zayinconde/Expert_In_Teams/Report/Images/olfactoryBreadboard.JPEG

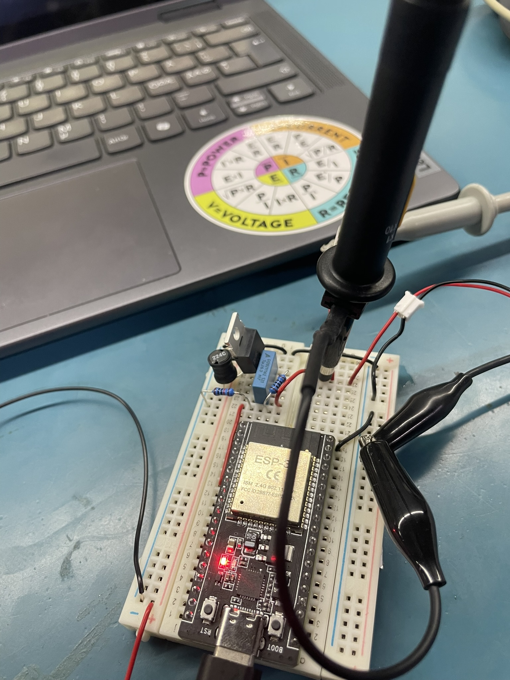
Report/Images/olfactoryBreadboard.JPEG
