zayinconde/Expert_In_Teams/Report/Images/IMG_4819.JPEG

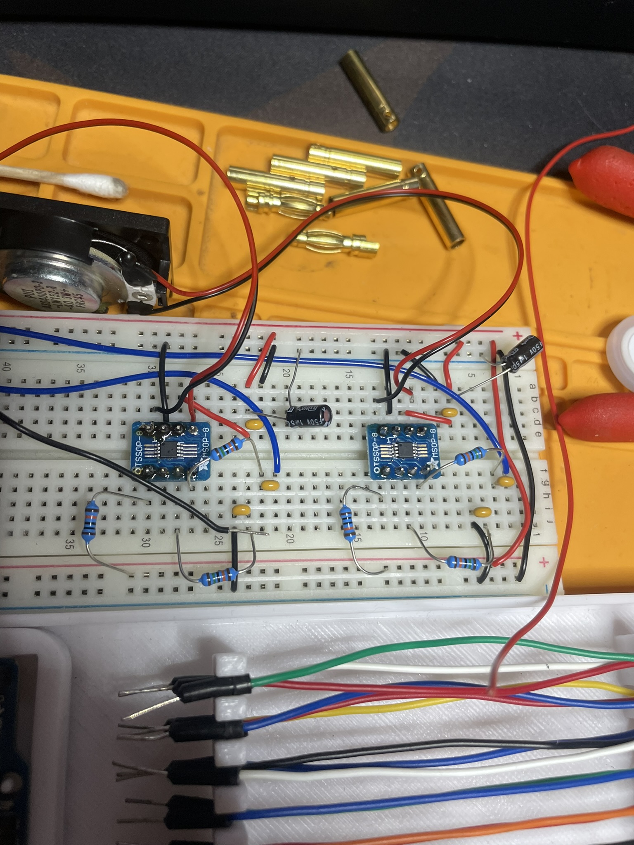
Report/Images/IMG_4819.JPEG
