zayinconde/Expert_In_Teams/README.md

This is my expert and teams electronics repository. The project is a multi-dsiciplinary project. This repository contains all the files related to the electronics part by me (Zayin Conde). 

The embedded software is developed in VS code using platformio cross platform developemnt tool. 

The repository also contains the KICAD files for circuit schematics and PCB designs. 

Additionally, a project B.O.M list is linked along with a brainstorming document (note: language can be informal, used for personal brainstorming and decision making) (View only with SDU Mail)

[📄 View the live Brainstorming Document (Word)](https://syddanskuni.sharepoint.com/:w:/s/AIDeputyExpertinTeams/ETyJX5G7IEFBnaOn01ZgCaMBbD81jJfqN7rkElq9ijI7jw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)
[📊 View the live B.O.M list (Excel)](https://syddanskuni.sharepoint.com/:x:/s/AIDeputyExpertinTeams/EaCTvVSukcdOoP5wCQjI0uoB_z5LuD4u5wMGKWqrb4GMKw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)
