zayinconde/Expert_In_Teams/Report/olfactory_presentation.pdf

## Active Mesh Nebulizer

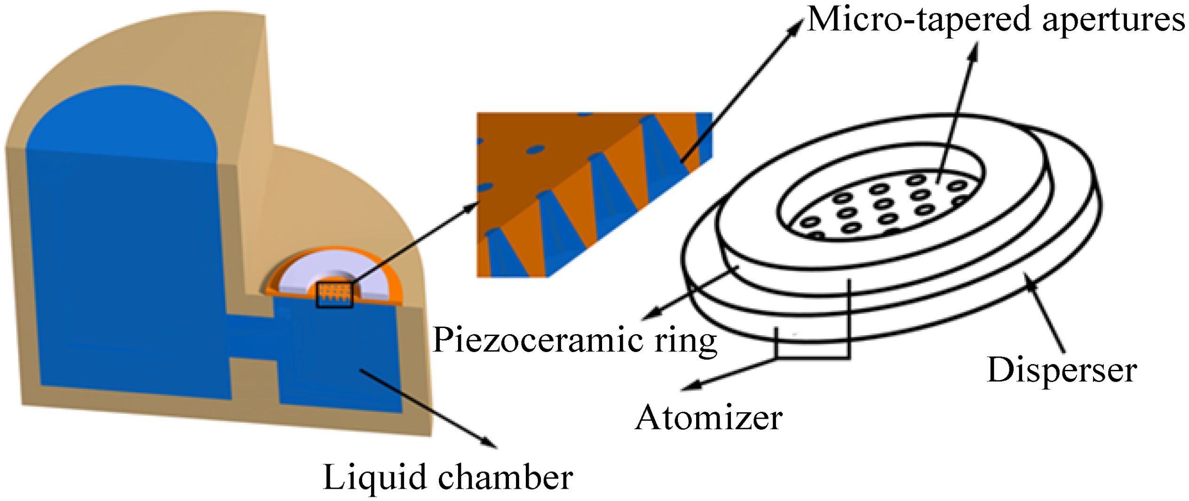
[picture p17: figure]

## Driving Circuit

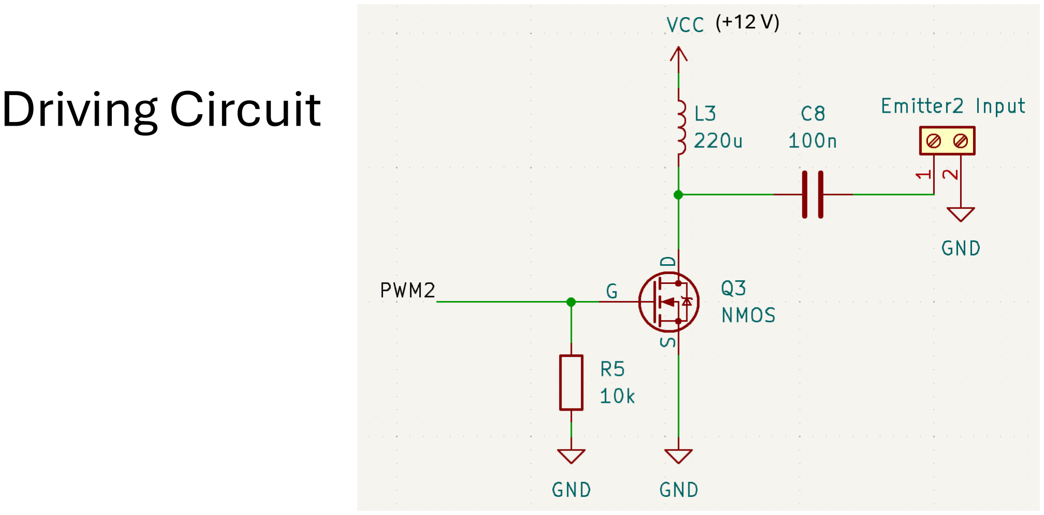
[picture p18: page 2]

(+12 V)

## Things to Consider

- 1. Low rate of atomization (up to 0.025 ml/s or 25 ul/s) for water.
- 2. Higher voltages may help achieve better atomization rates but risk damaging the transducer.
- 3. If the pressure of your liquid reservoir is too high, the liquid may leak through the mesh on its own.
- 4. Performance drops with more viscous liquids.
- 5. Liquids that crystalize on drying can clog the mesh. (e.g. tap water)
