zayinconde/Expert_In_Teams/DC-DC Converter Design/Scope ScreenShots/scopeDCDC.PNG

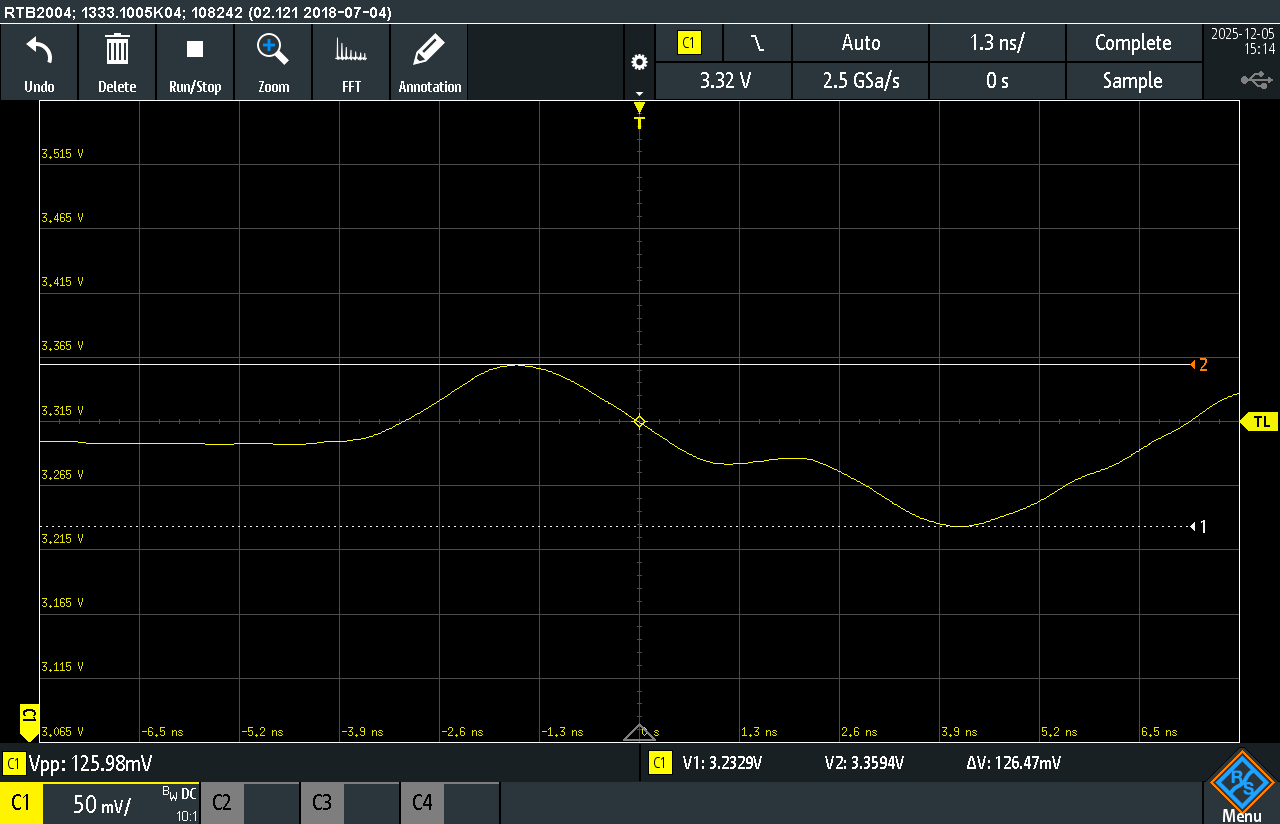
DC-DC Converter Design/Scope ScreenShots/scopeDCDC.PNG
