zayinconde/Expert_In_Teams/DC-DC Converter Design/Scope ScreenShots/SCR05.PNG

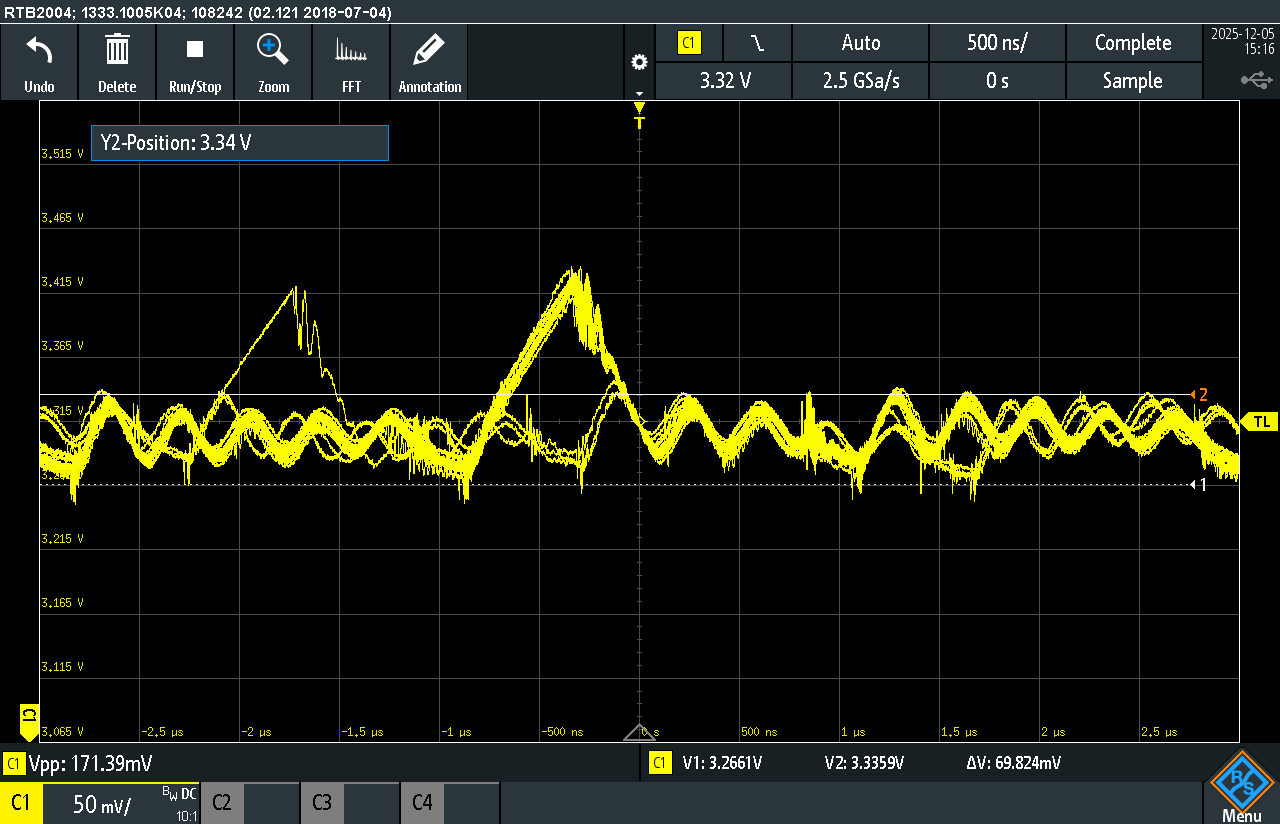
DC-DC Converter Design/Scope ScreenShots/SCR05.PNG
