zayinconde/Expert_In_Teams/DC-DC Converter Design/Scope ScreenShots/SCR07.PNG

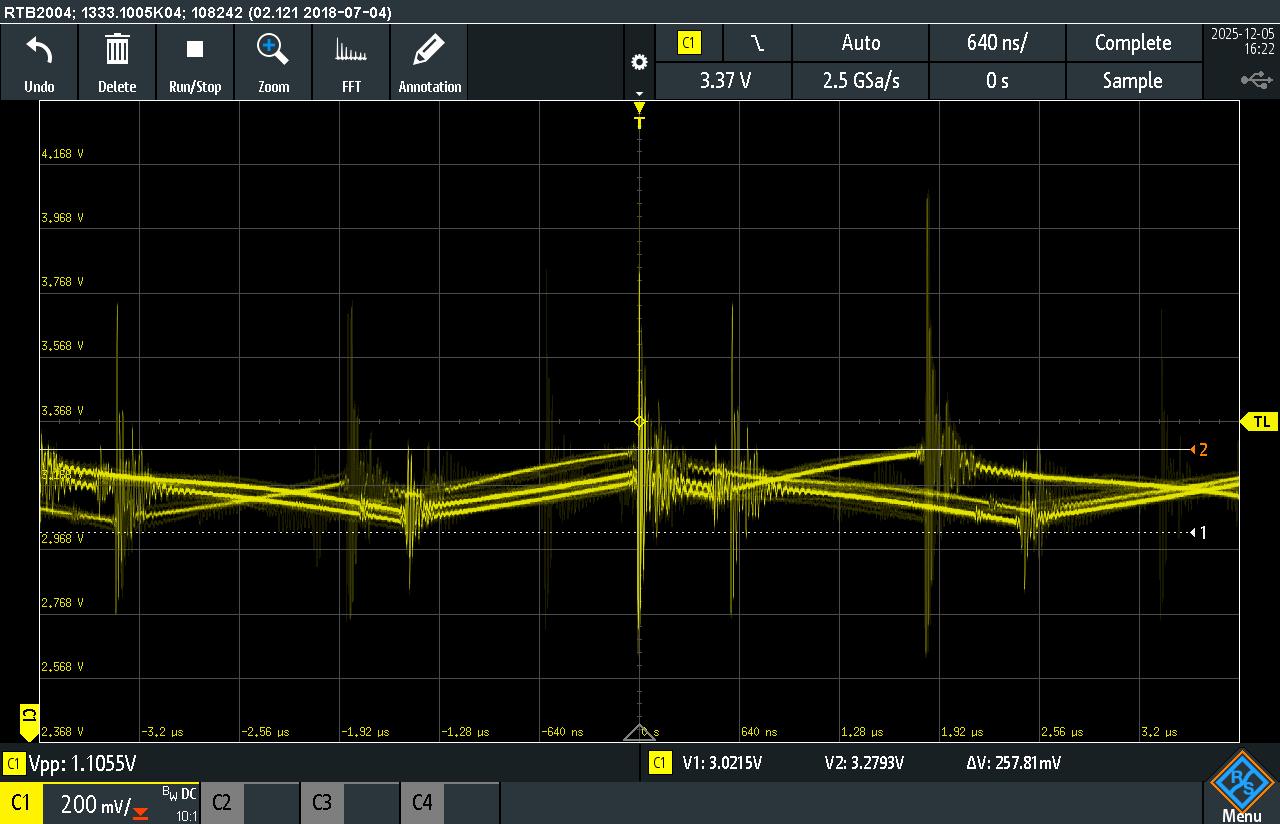
DC-DC Converter Design/Scope ScreenShots/SCR07.PNG
