zayinconde/Expert_In_Teams/Report/github.png

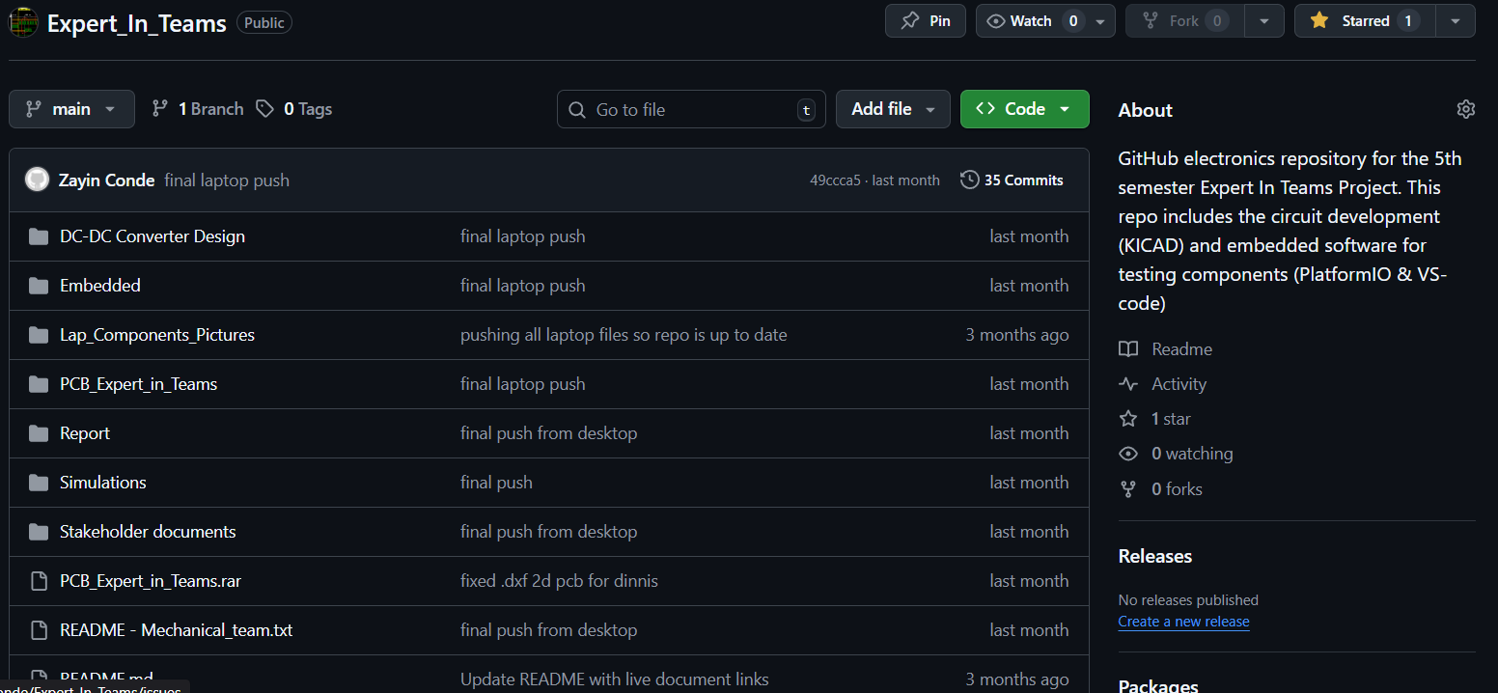
Report/github.png
