zayinconde/Expert_In_Teams/Report/Images/3dRenderPCB.png

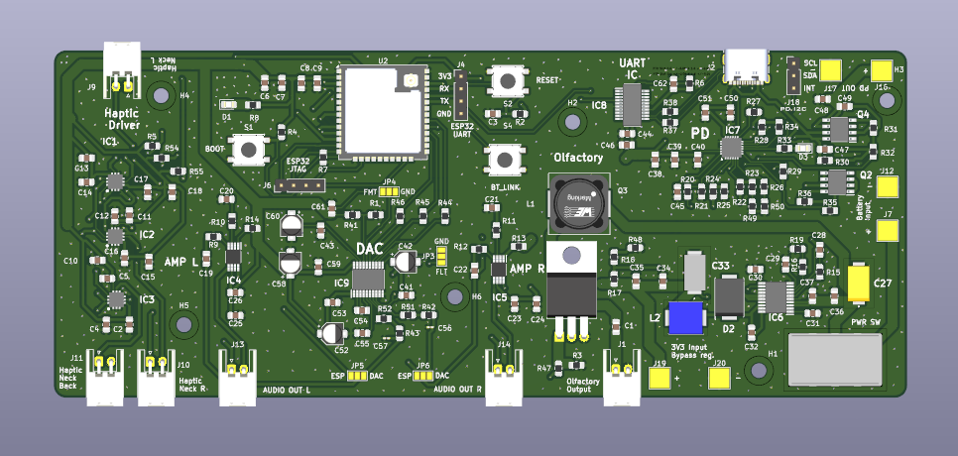
Report/Images/3dRenderPCB.png
