zayinconde/Expert_In_Teams/Report/Images/3dRenderPCBoutline.PNG

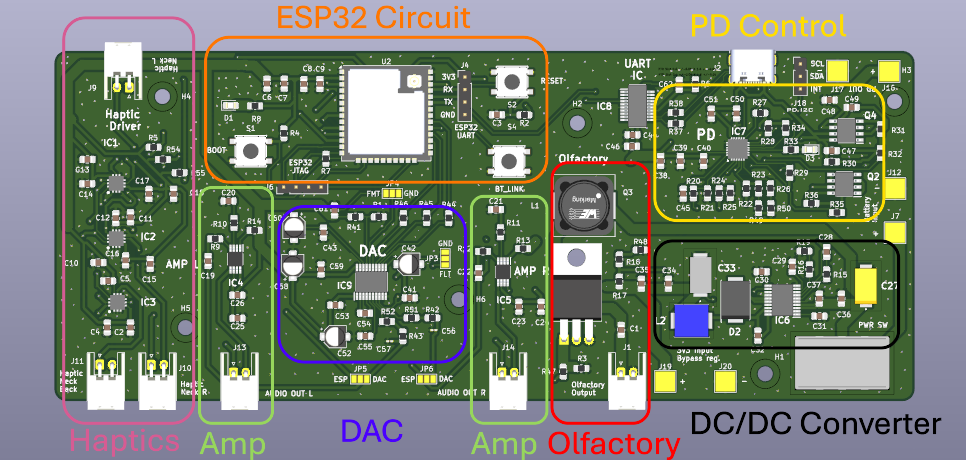
Report/Images/3dRenderPCBoutline.PNG
