zayinconde/Expert_In_Teams/Report/Images/AI-Deputy-Electronics-System-Diagram.drawio.png

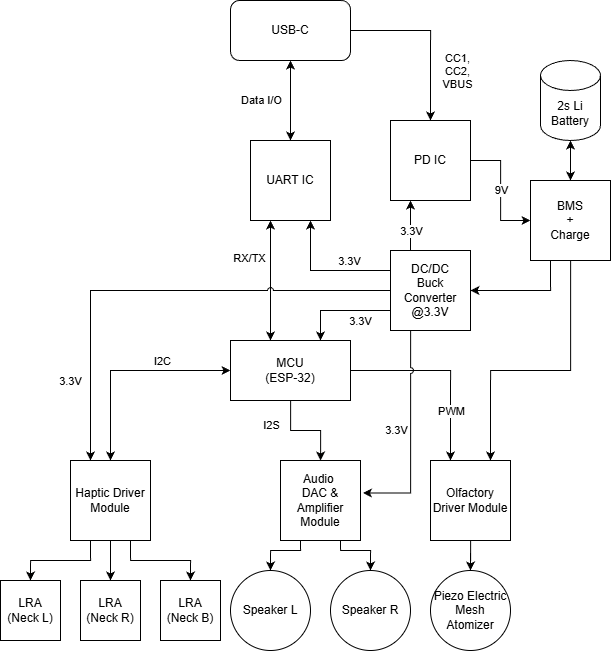
Report/Images/AI-Deputy-Electronics-System-Diagram.drawio.png
