zayinconde/Expert_In_Teams/Report/Images/audiodiagram.drawio.png

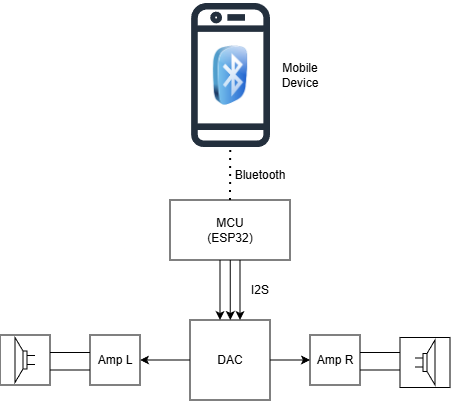
Report/Images/audiodiagram.drawio.png
