zayinconde/Expert_In_Teams/Report/Images/audiotestnodac..JPG

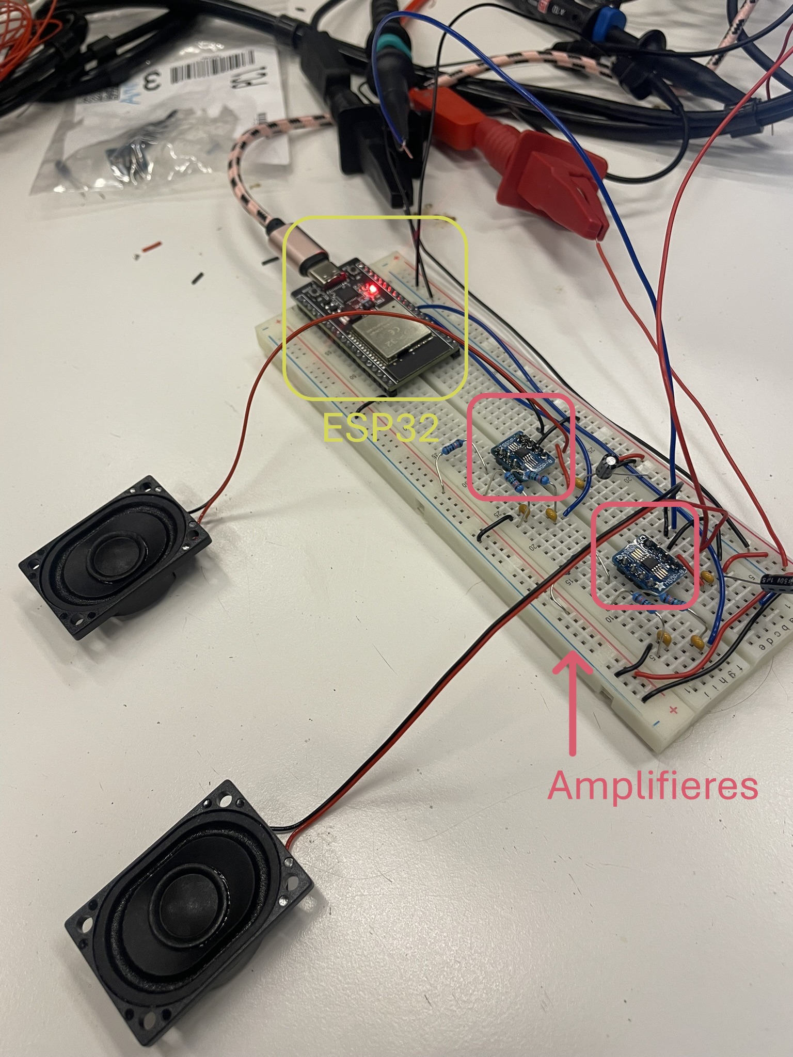
Report/Images/audiotestnodac..JPG
