zayinconde/Expert_In_Teams/Report/Images/buck_converter.JPEG

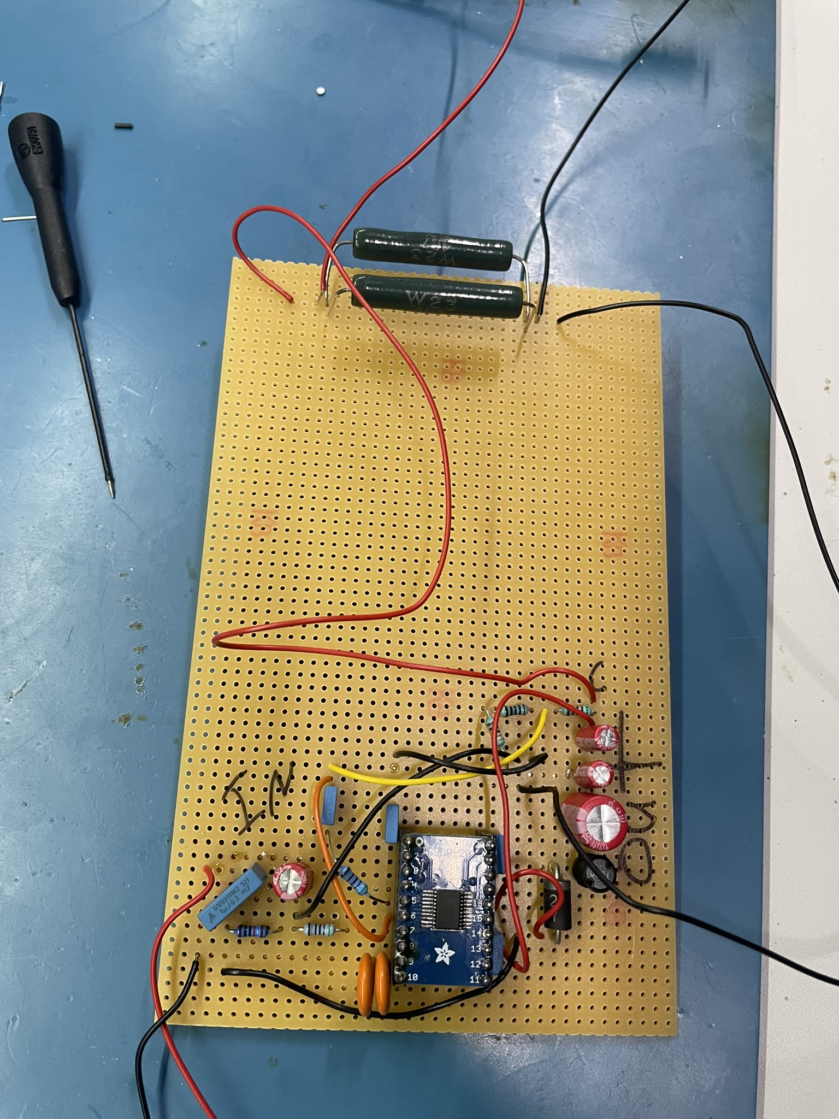
Report/Images/buck_converter.JPEG
