zayinconde/Expert_In_Teams/Report/Images/buck_converter_breadboard.JPEG

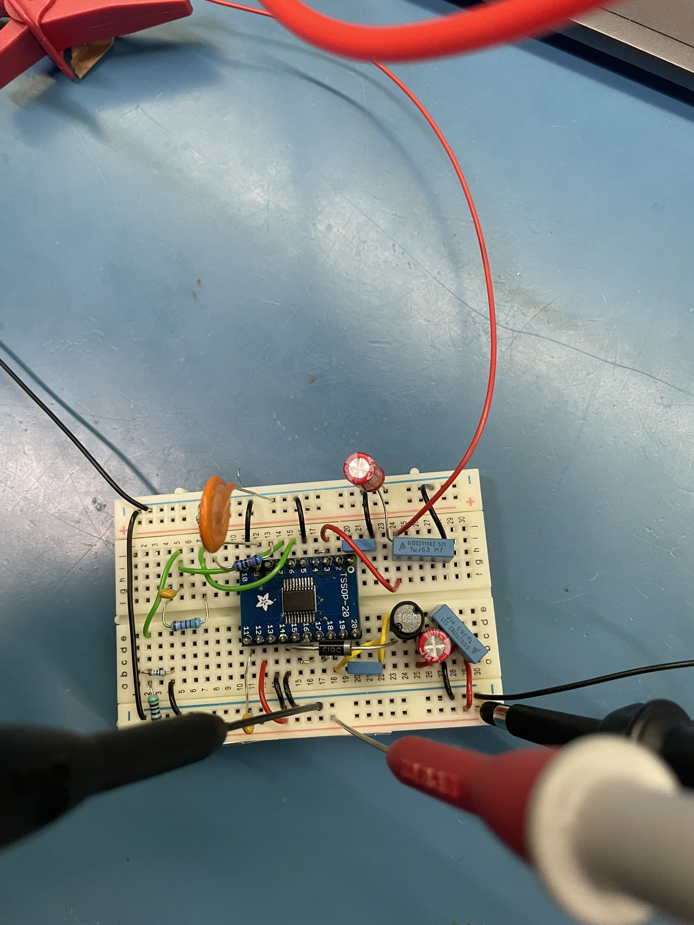
Report/Images/buck_converter_breadboard.JPEG
