zayinconde/Expert_In_Teams/Report/Images/DACbreadboard.JPG

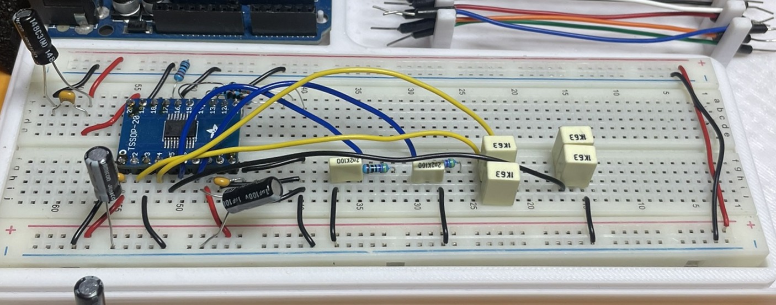
Report/Images/DACbreadboard.JPG
