zayinconde/Expert_In_Teams/Report/Images/git.png

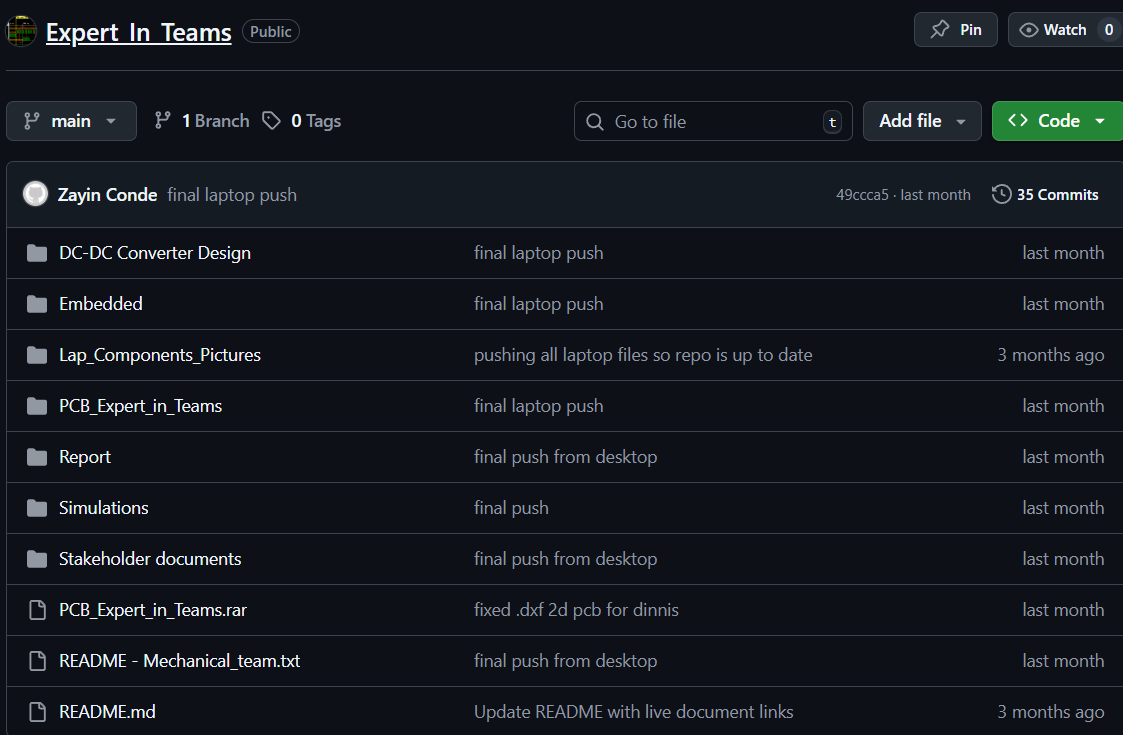
Report/Images/git.png
