zayinconde/Expert_In_Teams/Report/Images/IMG_4792.JPEG

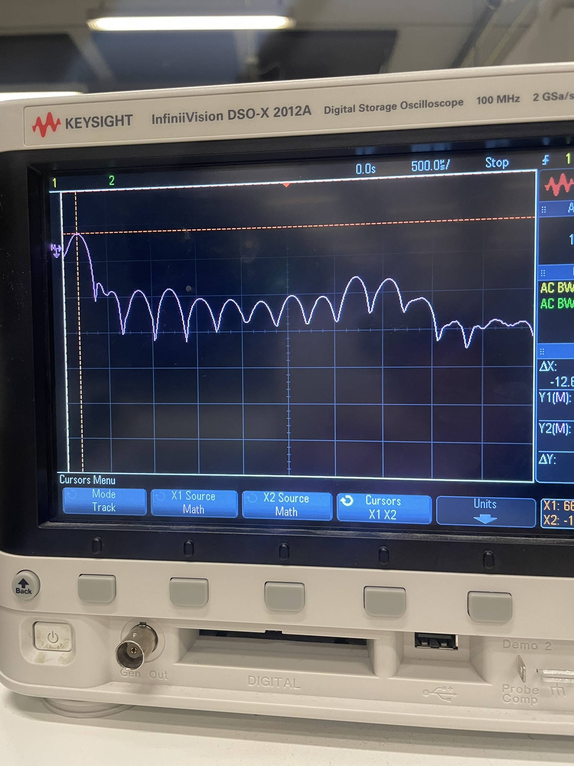
Report/Images/IMG_4792.JPEG
