zayinconde/Expert_In_Teams/Report/Images/IMG_4815.JPEG

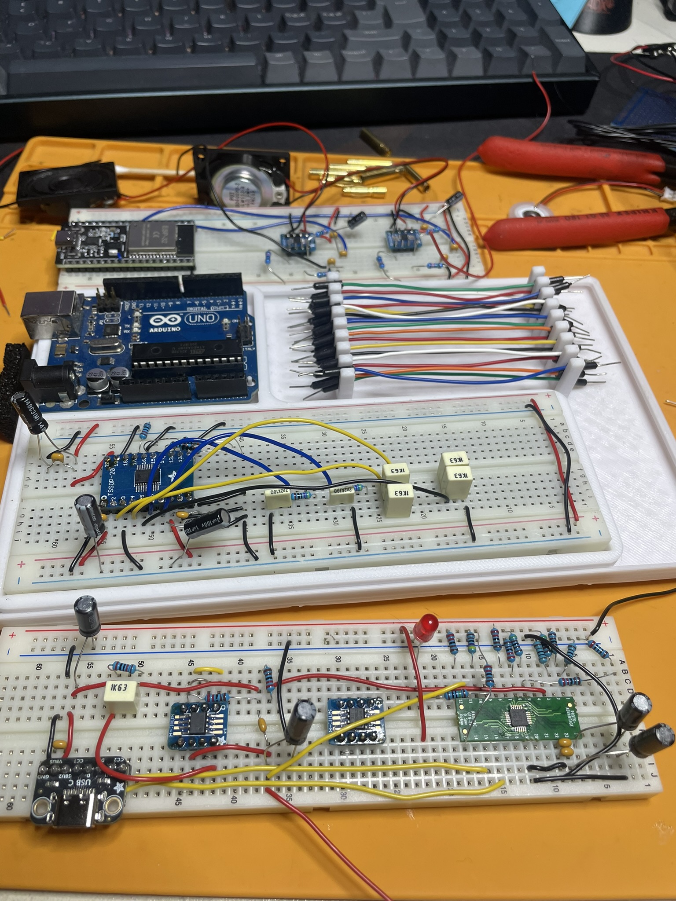
Report/Images/IMG_4815.JPEG
