zayinconde/Expert_In_Teams/Report/Images/IMG_4816.JPEG

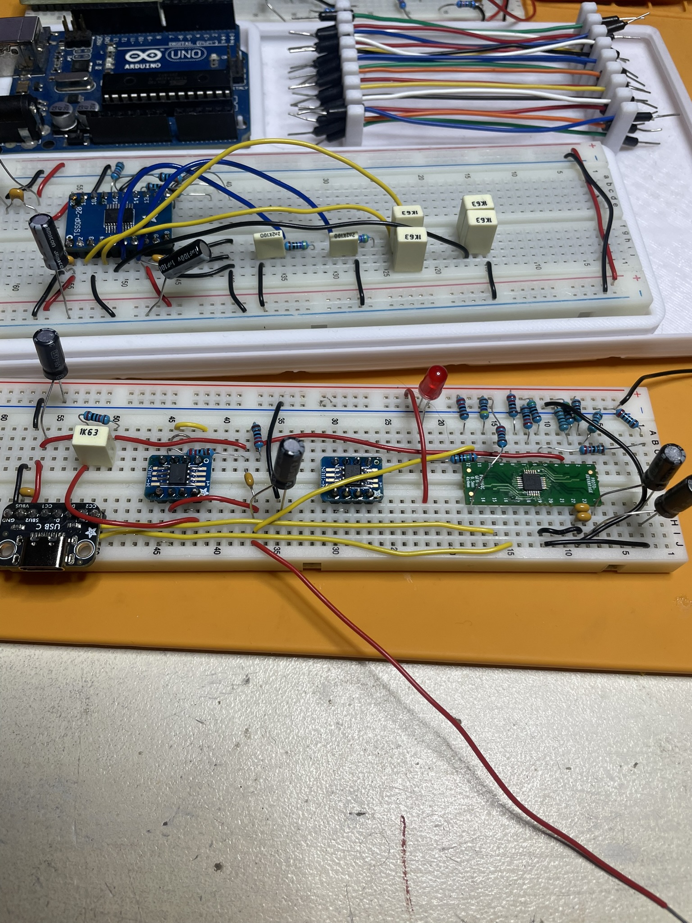
Report/Images/IMG_4816.JPEG
