zayinconde/Expert_In_Teams/Report/Images/IMG_4817.JPEG

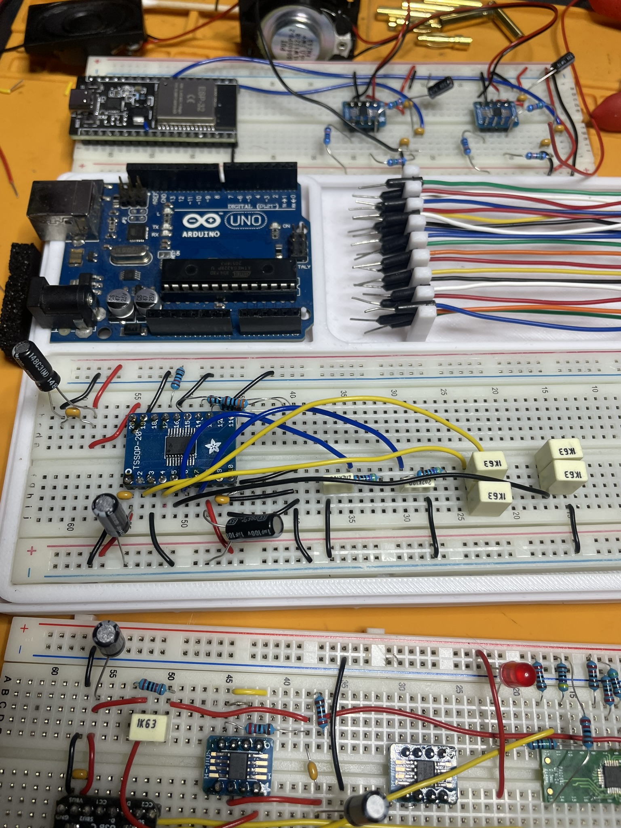
Report/Images/IMG_4817.JPEG
