zayinconde/Expert_In_Teams/Report/Images/IMG_4818.JPEG

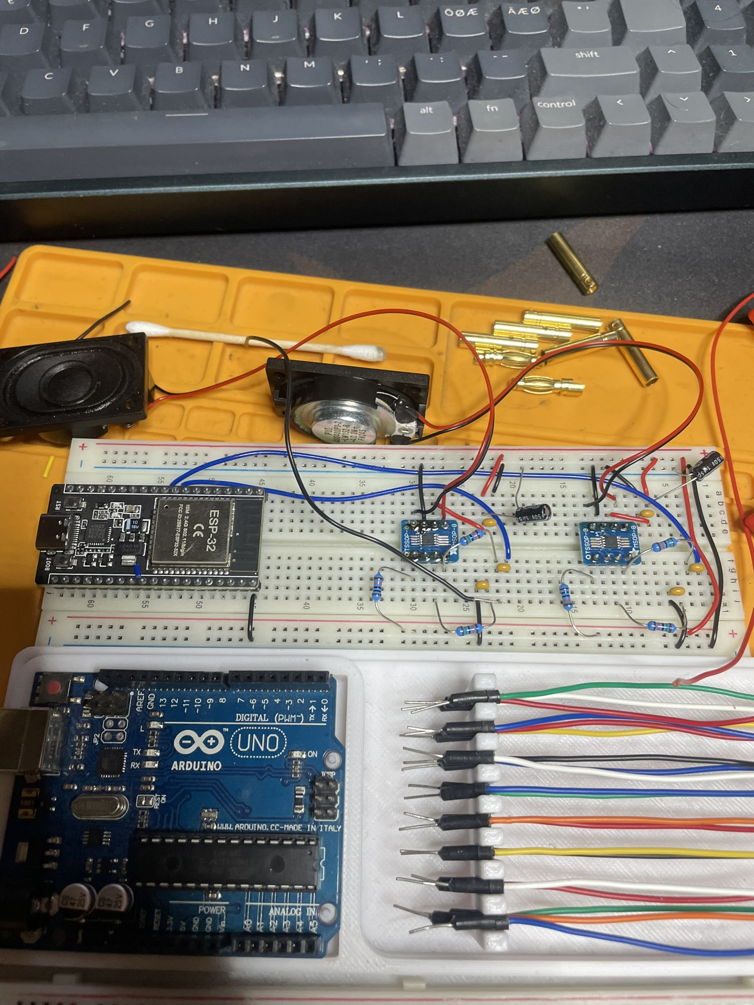
Report/Images/IMG_4818.JPEG
