zayinconde/Expert_In_Teams/Report/Images/IMG_4835.JPEG

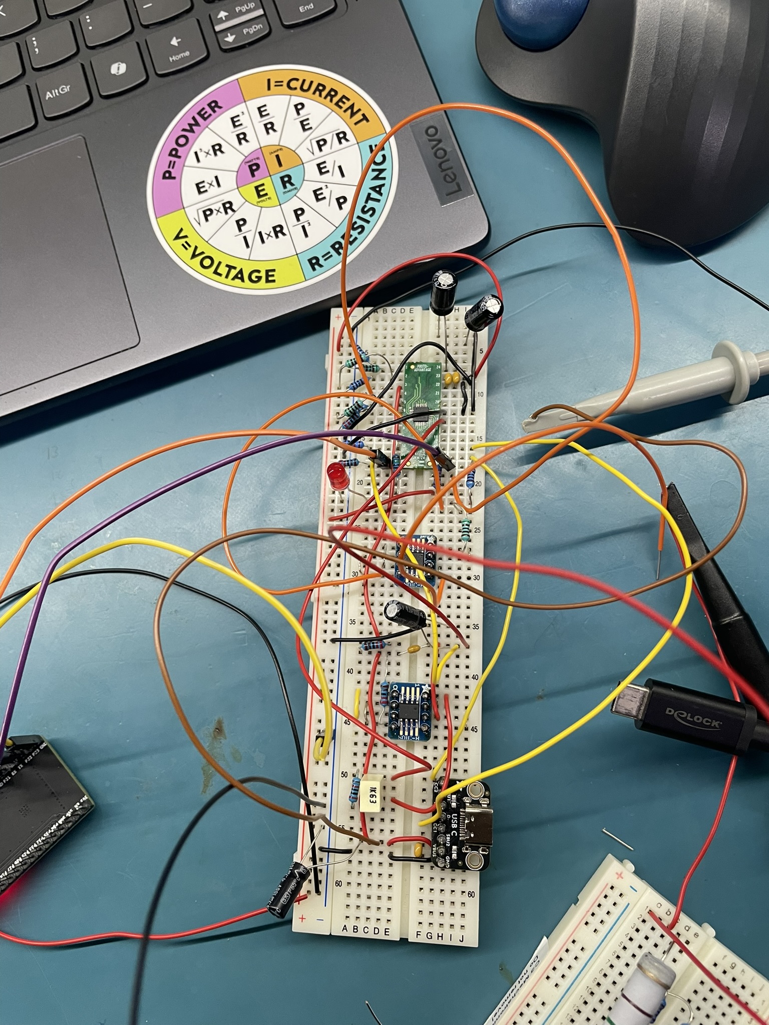
Report/Images/IMG_4835.JPEG
