zayinconde/Expert_In_Teams/Report/Images/IMG_4836.JPEG

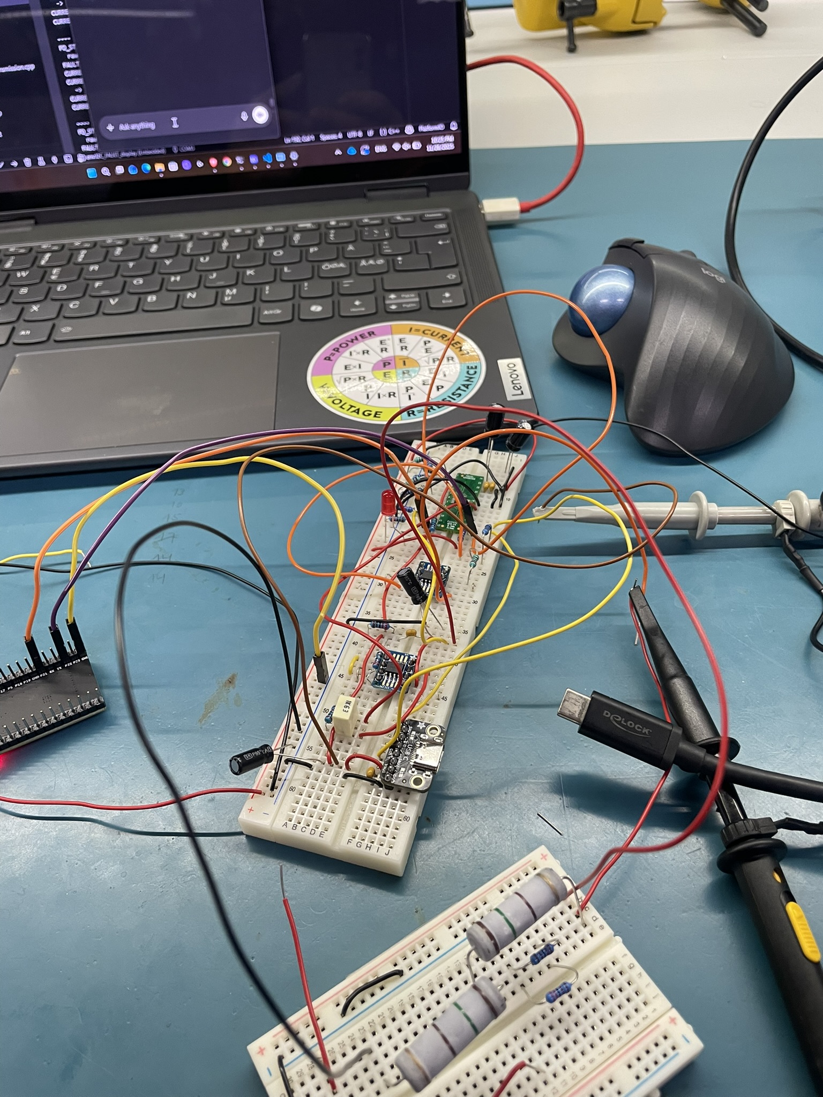
Report/Images/IMG_4836.JPEG
