zayinconde/Expert_In_Teams/Report/Images/IMG_4837.JPEG

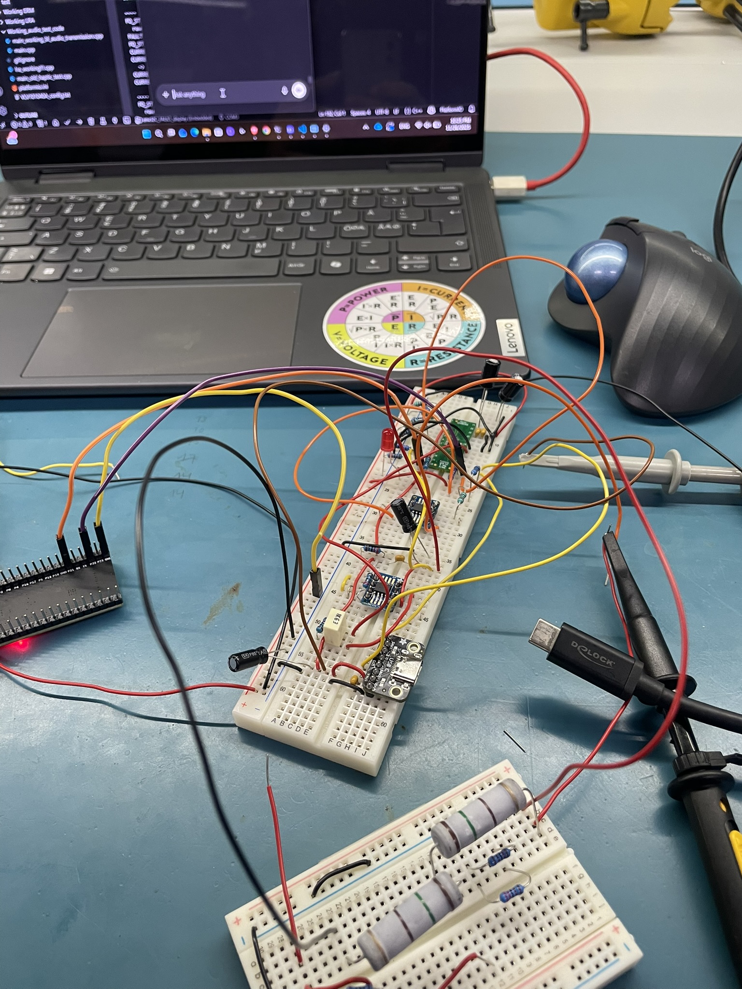
Report/Images/IMG_4837.JPEG
