zayinconde/Expert_In_Teams/Report/Images/IMG_4838.JPEG

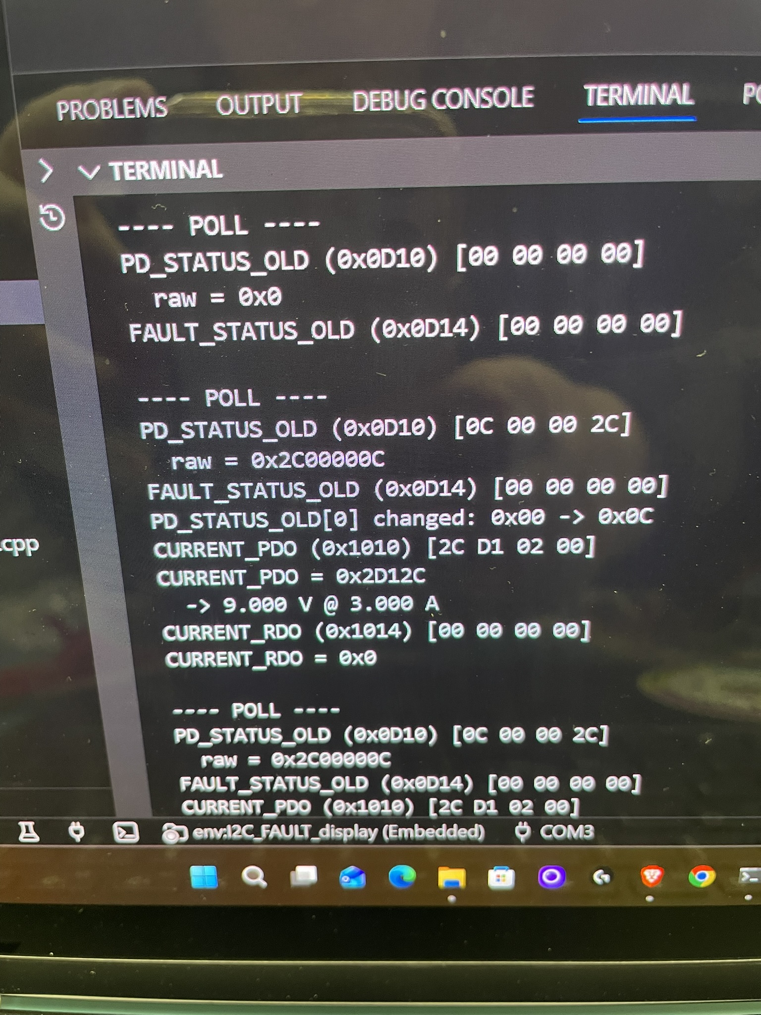
Report/Images/IMG_4838.JPEG
