zayinconde/Expert_In_Teams/Report/Images/IMG_4950.JPEG

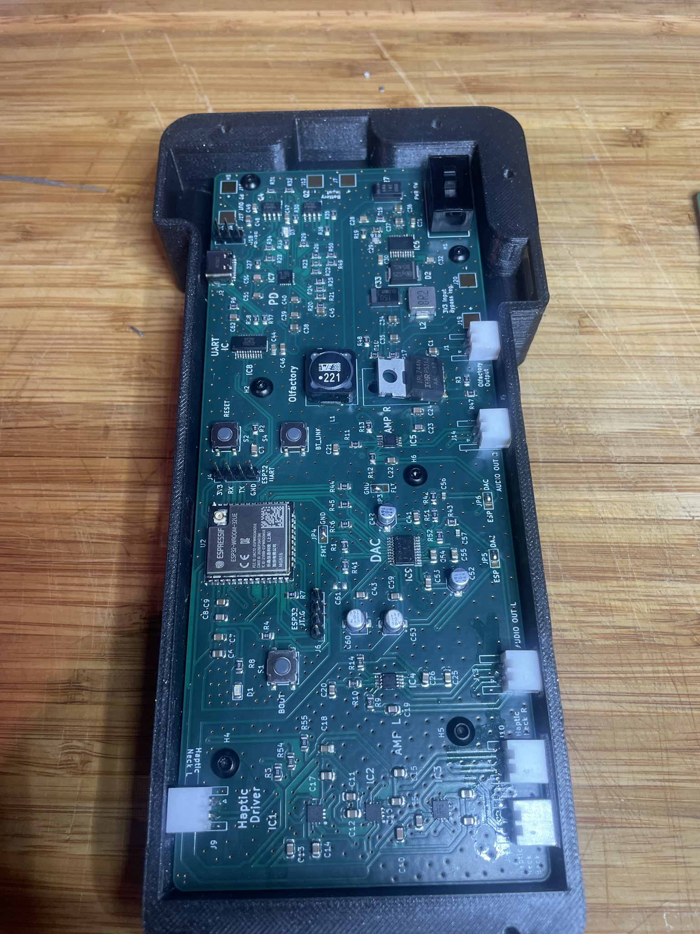
Report/Images/IMG_4950.JPEG
