zayinconde/Expert_In_Teams/Report/Images/IMG_4951.JPEG

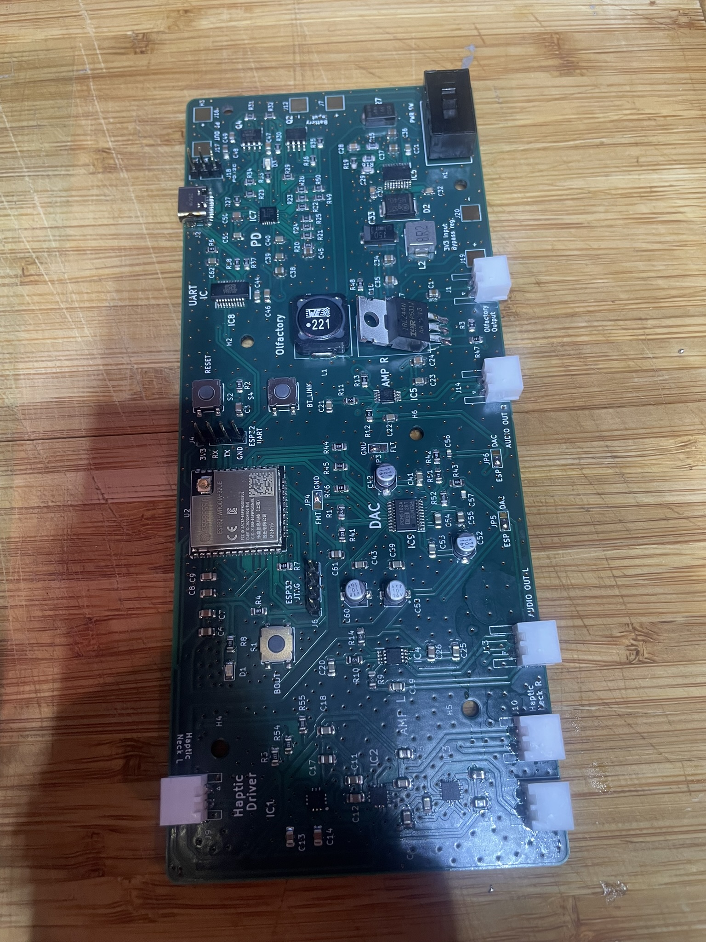
Report/Images/IMG_4951.JPEG
