zayinconde/Expert_In_Teams/Report/Images/IMG_4952.JPEG

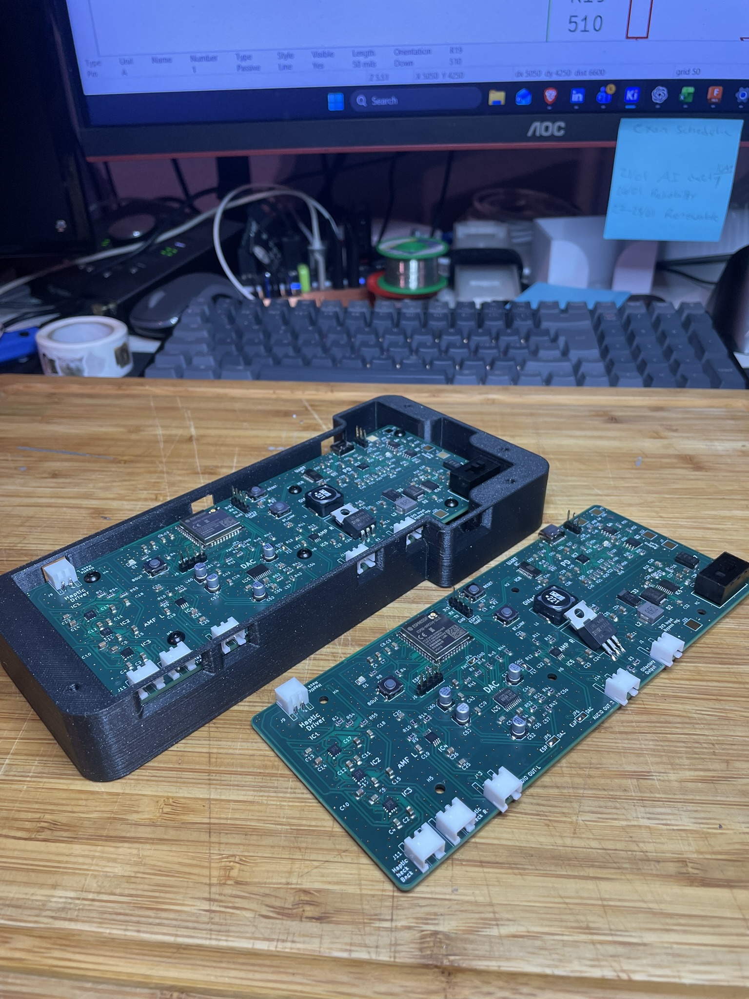
Report/Images/IMG_4952.JPEG
