zayinconde/Expert_In_Teams/Report/Images/IMG_4957.JPEG

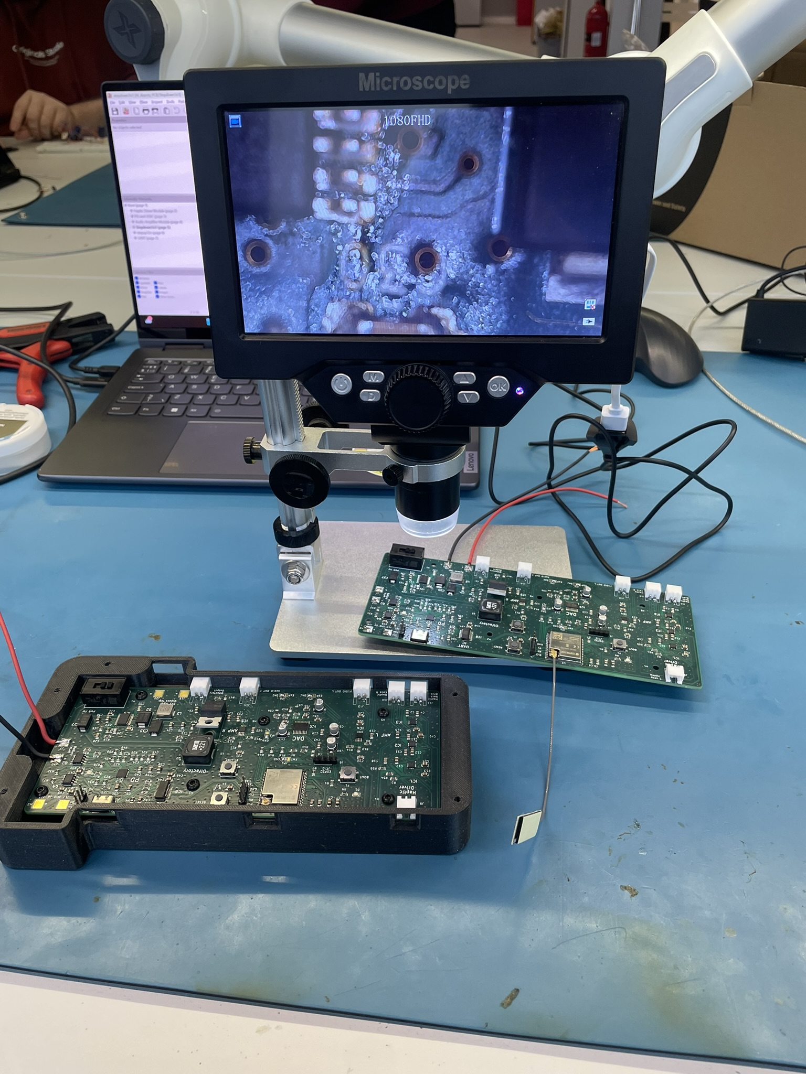
Report/Images/IMG_4957.JPEG
