zayinconde/Expert_In_Teams/Report/Images/Mikroe-Haptic-4-click.png

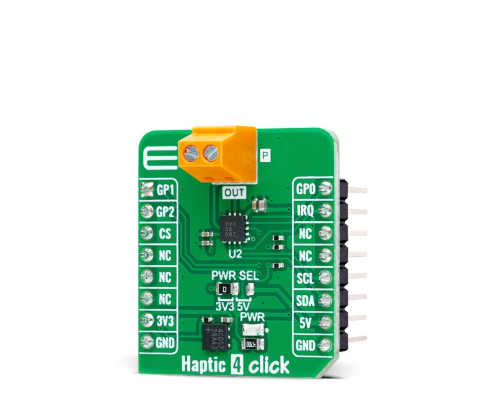
Report/Images/Mikroe-Haptic-4-click.png
