zayinconde/Expert_In_Teams/Report/Images/pcbcrop.JPG

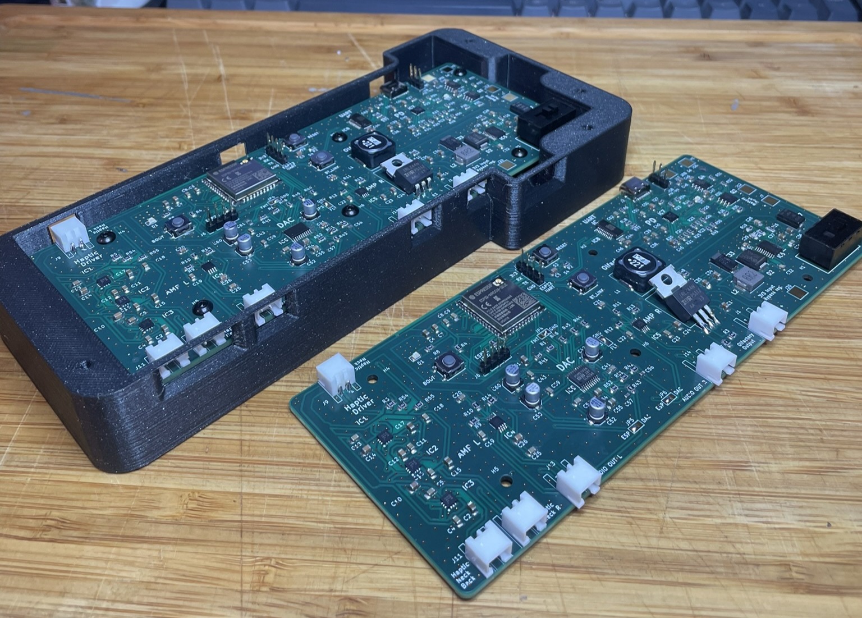
Report/Images/pcbcrop.JPG
