zayinconde/Expert_In_Teams/Report/Images/pdtriggerbreadboard.JPG

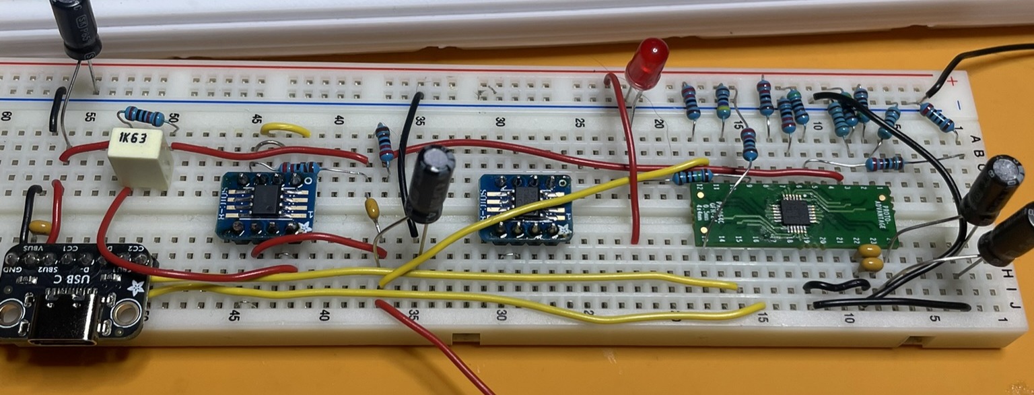
Report/Images/pdtriggerbreadboard.JPG
