zayinconde/Expert_In_Teams/Report/Images/Power Supply ext.drawio.png

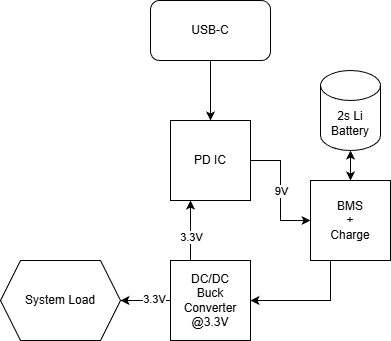
Report/Images/Power Supply ext.drawio.png
