zayinconde/Expert_In_Teams/Report/Images/pres1.png

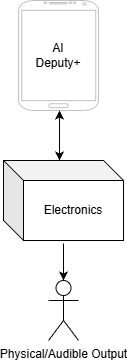
Report/Images/pres1.png
