zayinconde/Expert_In_Teams/Report/Images/Screenshot 2026-01-20 133958.png

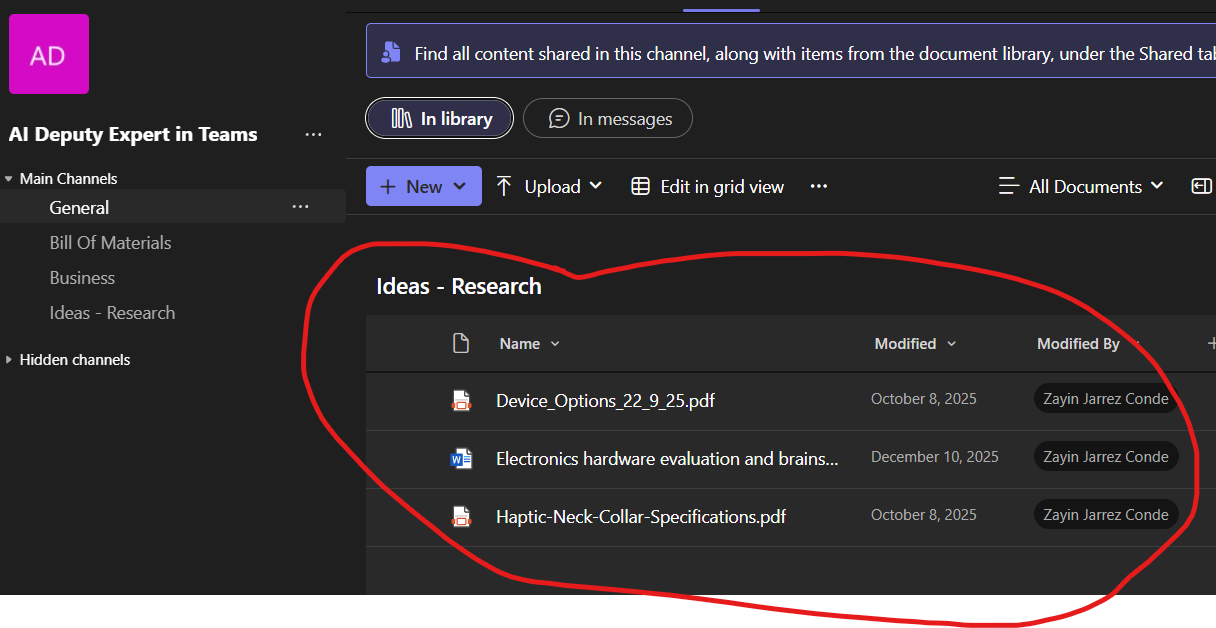
Report/Images/Screenshot 2026-01-20 133958.png
