zayinconde/Expert_In_Teams/Simulations/Olfactory/Screenshot 2025-11-24 204346.png

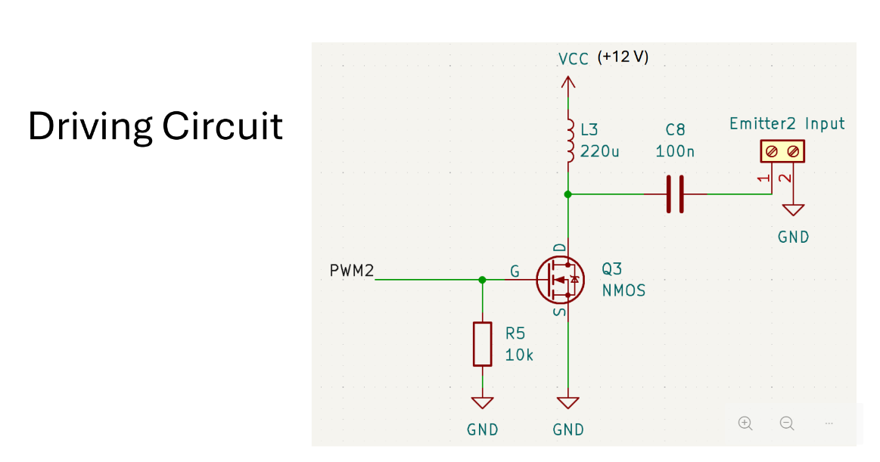
Simulations/Olfactory/Screenshot 2025-11-24 204346.png
