zayinconde/Expert_In_Teams/Lap_Components_Pictures/lab-opamps.jpeg

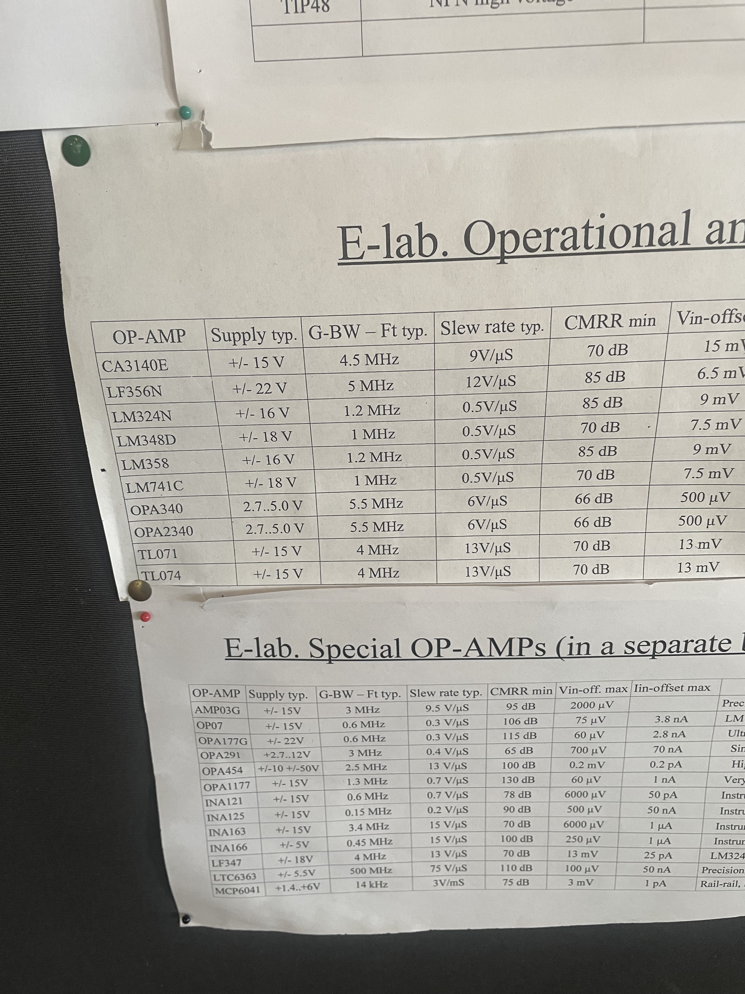
Lap_Components_Pictures/lab-opamps.jpeg
