zayinconde/Expert_In_Teams/Lap_Components_Pictures/lab-transistors.jpeg

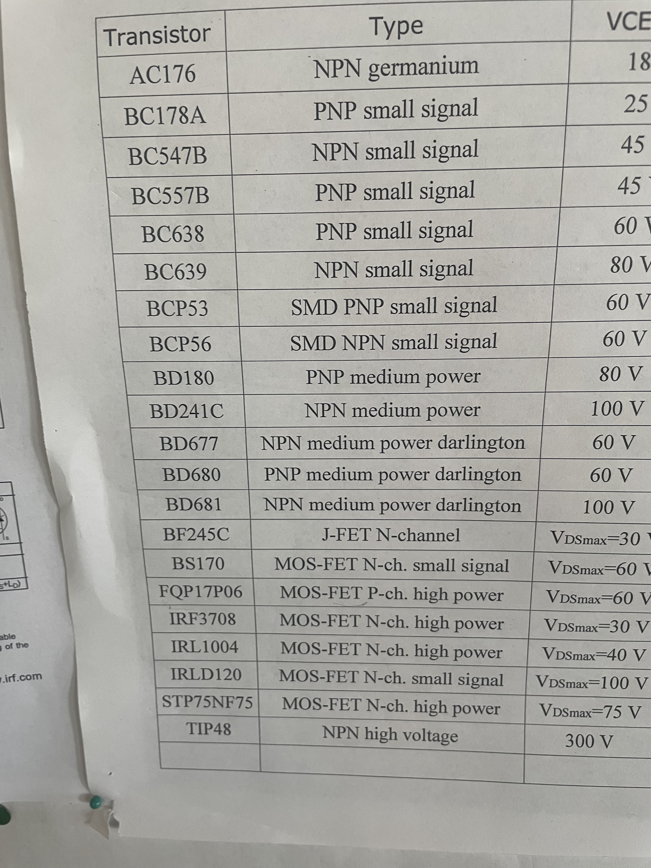
Lap_Components_Pictures/lab-transistors.jpeg
