zayinconde/Expert_In_Teams/CAD Files/scent emitter concept zayin.stl

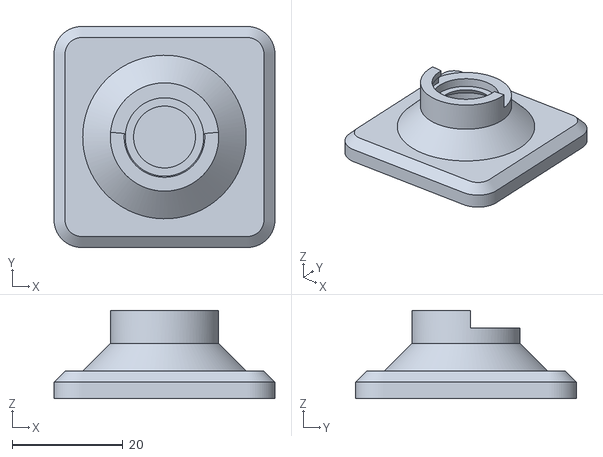
[picture p56: CAD file, 2026-01-21]
CAD Files/scent emitter concept zayin.stl
40.0 x 40.0 x 16.0
