zayinconde/Expert_In_Teams/PCB_Expert_in_Teams/Models/CYPD3177-24LQXQ/3D/CYPD3177-24LQXQ.stp

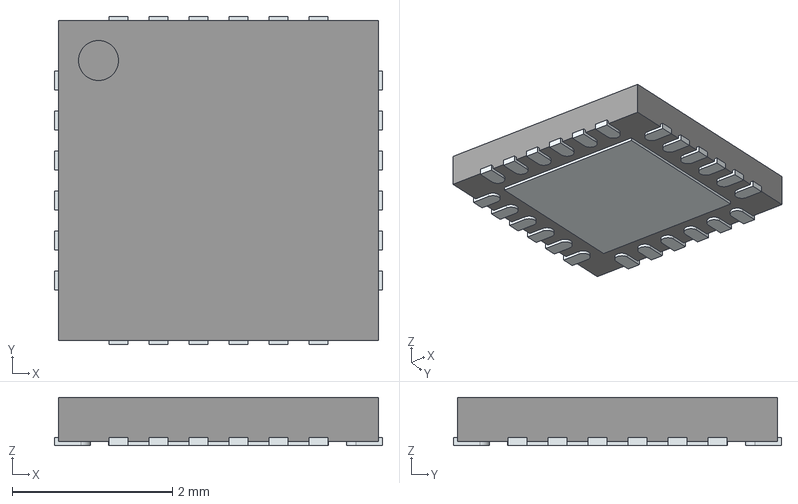
[picture p57: CAD file, 2025-10-30]
PCB_Expert_in_Teams/Models/CYPD3177-24LQXQ/3D/CYPD3177-24LQXQ.stp
4.10 x 4.10 x 0.6 mm
ThermalPin
PinsArrayLR
PinsArrayTB
