zayinconde/Expert_In_Teams/PCB_Expert_in_Teams/Models/DA7280-00FVC/3D/DA7280-00FVC.stp

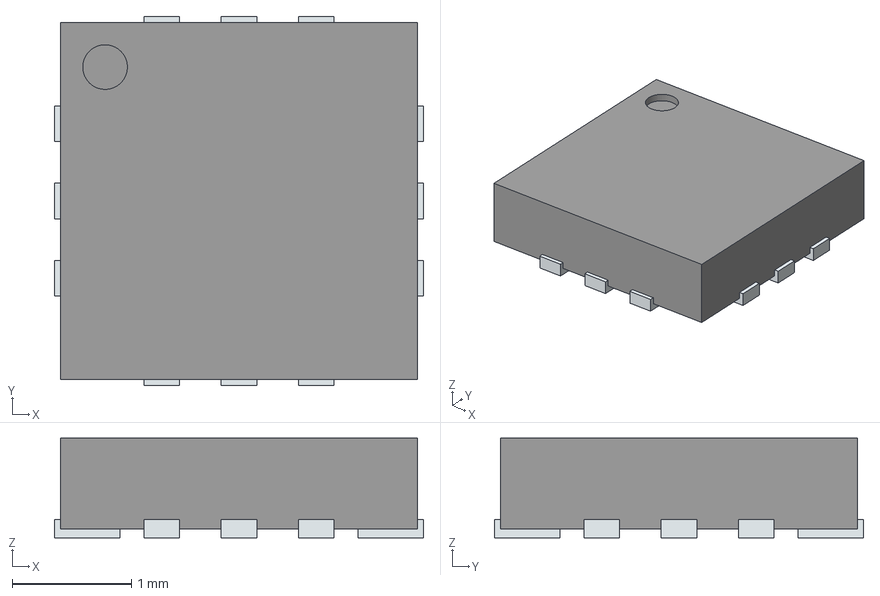
[picture p58: CAD file, 2025-10-28]
PCB_Expert_in_Teams/Models/DA7280-00FVC/3D/DA7280-00FVC.stp
3.10 x 3.10 x 0.84 mm
PinsArrayLR
PinsArrayTB
