zayinconde/Expert_In_Teams/PCB_Expert_in_Teams/Models/DMP3098LSD-13/3D/DMP3098LSD-13.stp

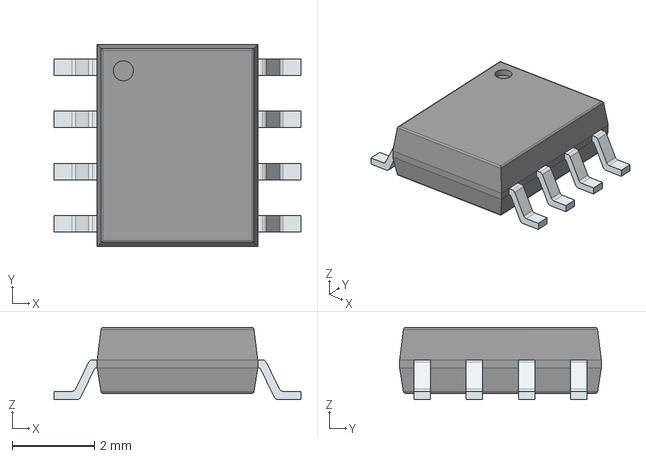
[picture p59: CAD file, 2025-10-30]
PCB_Expert_in_Teams/Models/DMP3098LSD-13/3D/DMP3098LSD-13.stp
6.00 x 4.90 x 1.75 mm
PinsArrayLR
