zayinconde/Expert_In_Teams/PCB_Expert_in_Teams/Models/EEFSX0J151ER/3D/EEFSX0J151ER.stp

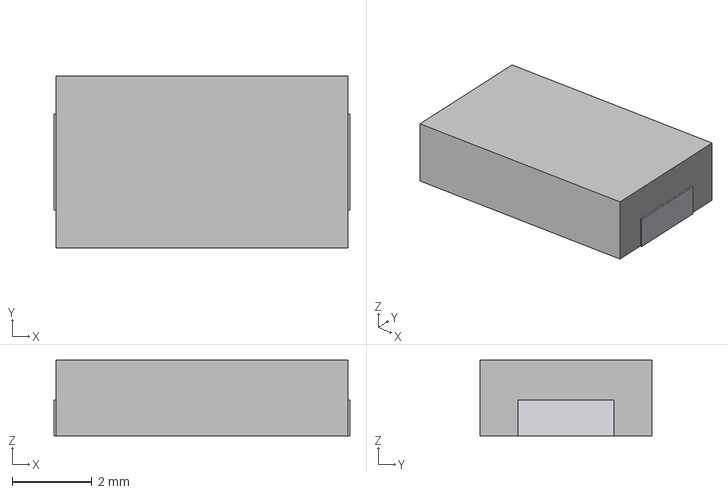
[picture p60: CAD file, 2025-11-06]
PCB_Expert_in_Teams/Models/EEFSX0J151ER/3D/EEFSX0J151ER.stp
7.40 x 4.30 x 1.90 mm
