zayinconde/Expert_In_Teams/PCB_Expert_in_Teams/Models/ESP32-WROOM-32UE-N16/3D/ESP32-WROOM-32UE-N16.stp

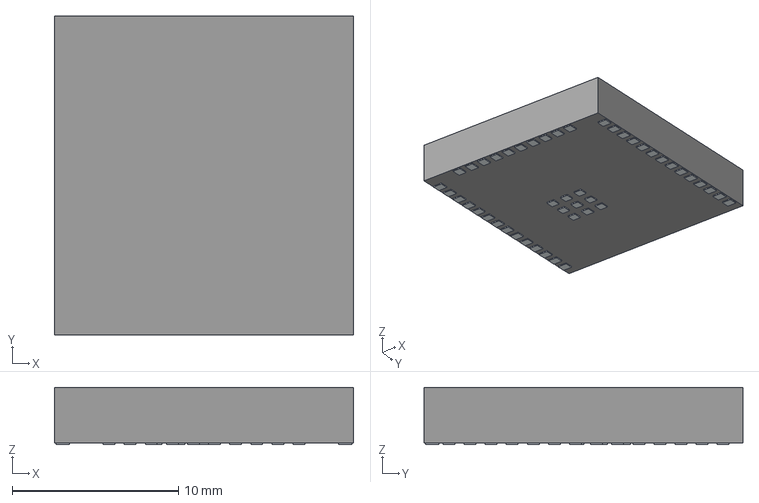
[picture p61: CAD file, 2025-12-01]
PCB_Expert_in_Teams/Models/ESP32-WROOM-32UE-N16/3D/ESP32-WROOM-32UE-N16.stp
18.0 x 19.2 x 3.45 mm
Pins
