zayinconde/Expert_In_Teams/PCB_Expert_in_Teams/Models/ESP32-WROOM-32UE_M113EH6400UH3Q0_/ESP32-WROOM-32UE_M113EH6400UH3Q0_.step

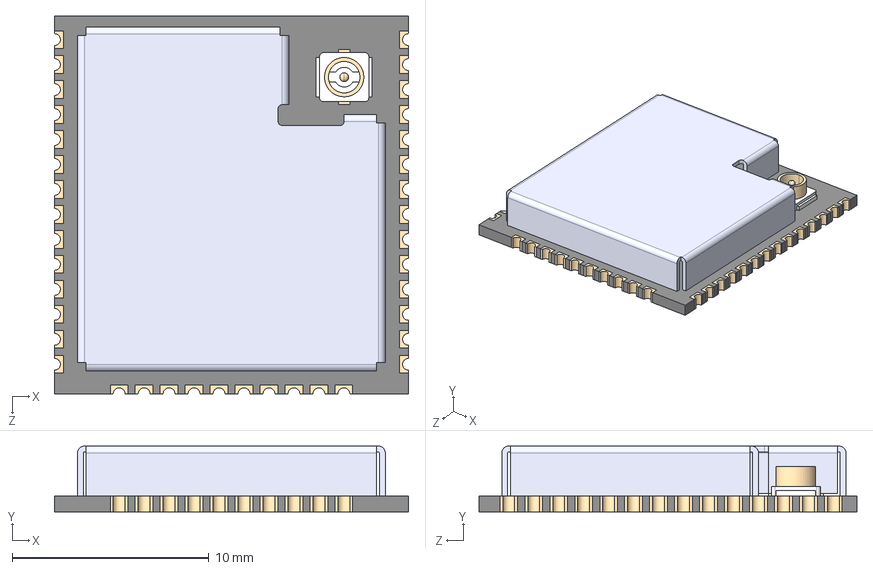
[picture p62: CAD file, 2025-10-28]
PCB_Expert_in_Teams/Models/ESP32-WROOM-32UE_M113EH6400UH3Q0_/ESP32-WROOM-32UE_M113EH6400UH3Q0_.step
18.0 x 3.35 x 19.2 mm
