zayinconde/Expert_In_Teams/PCB_Expert_in_Teams/Models/FT231XS-R/3D/FT231XS-R.stp

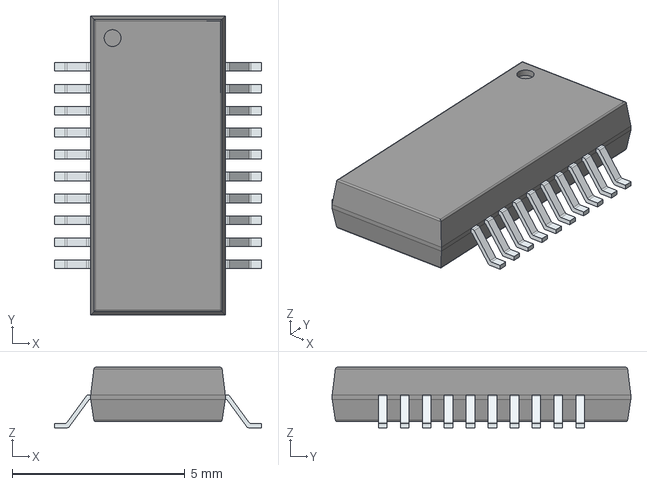
[picture p63: CAD file, 2025-10-30]
PCB_Expert_in_Teams/Models/FT231XS-R/3D/FT231XS-R.stp
5.99 x 8.65 x 1.75 mm
PinsArrayLR
