zayinconde/Expert_In_Teams/PCB_Expert_in_Teams/Models/FT231XS-R/KiCad/SSOP-20-5_3.step

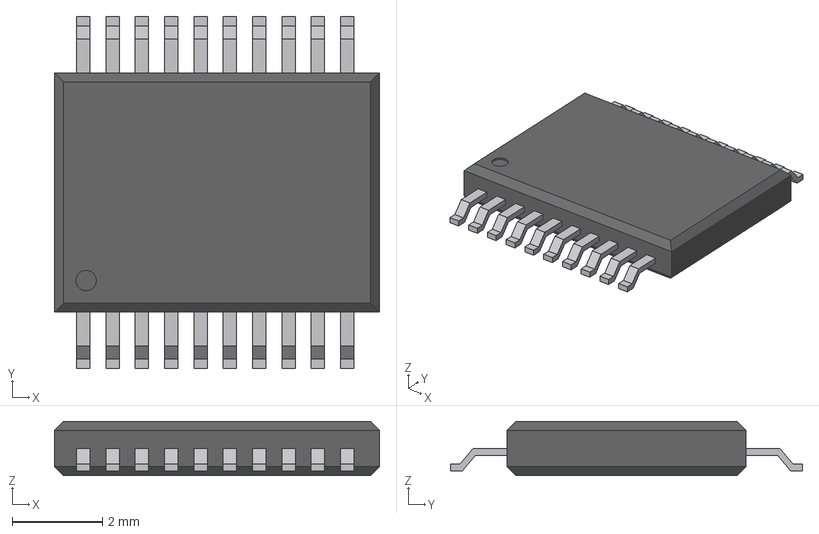
[picture p64: CAD file, 2025-11-12]
PCB_Expert_in_Teams/Models/FT231XS-R/KiCad/SSOP-20-5_3.step
7.20 x 7.80 x 1.20 mm
