zayinconde/Expert_In_Teams/PCB_Expert_in_Teams/Models/IS31AP2005-SLS2-TR/3D/IS31AP2005-SLS2-TR.stp

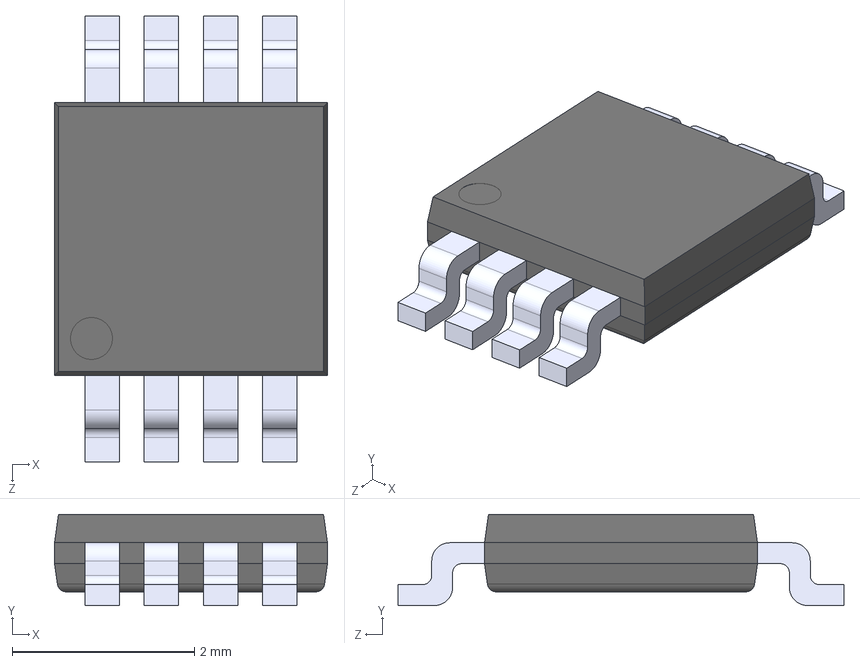
[picture p65: CAD file, 2025-10-28]
PCB_Expert_in_Teams/Models/IS31AP2005-SLS2-TR/3D/IS31AP2005-SLS2-TR.stp
3.00 x 1.00 x 4.90 mm
