zayinconde/Expert_In_Teams/PCB_Expert_in_Teams/Models/LM2576S-3.3_NOPB/3D/LM2576S-3.3_NOPB.stp

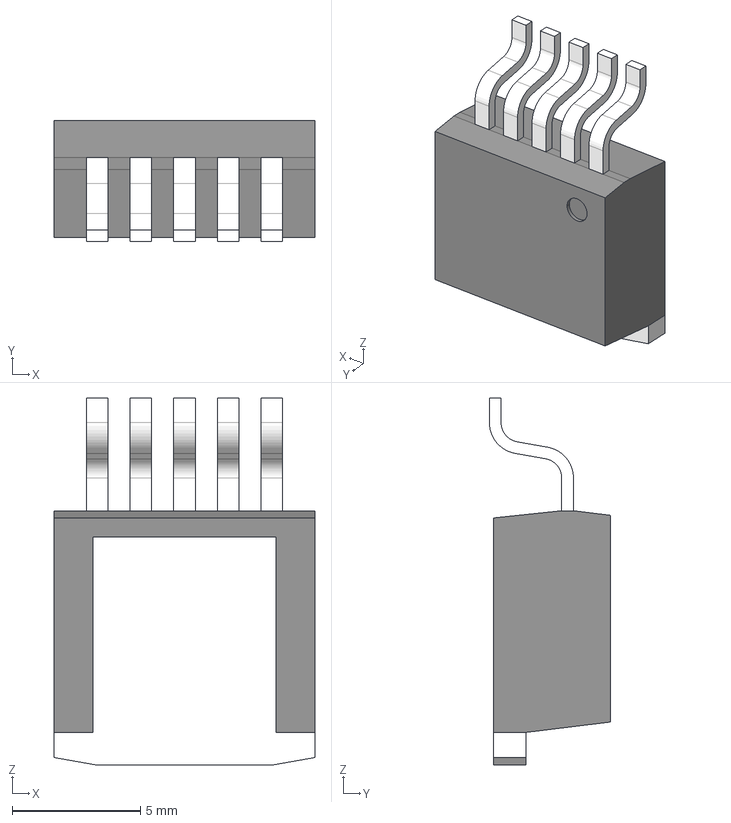
[picture p66: CAD file, 2025-10-28]
PCB_Expert_in_Teams/Models/LM2576S-3.3_NOPB/3D/LM2576S-3.3_NOPB.stp
10.2 x 4.72 x 14.3 mm
BODY_TS5B
HTSINK_TS5B
LEAD_TS5B x 5
