zayinconde/Expert_In_Teams/PCB_Expert_in_Teams/Models/MBRS540T3G/3D/MBRS540T3G.stp

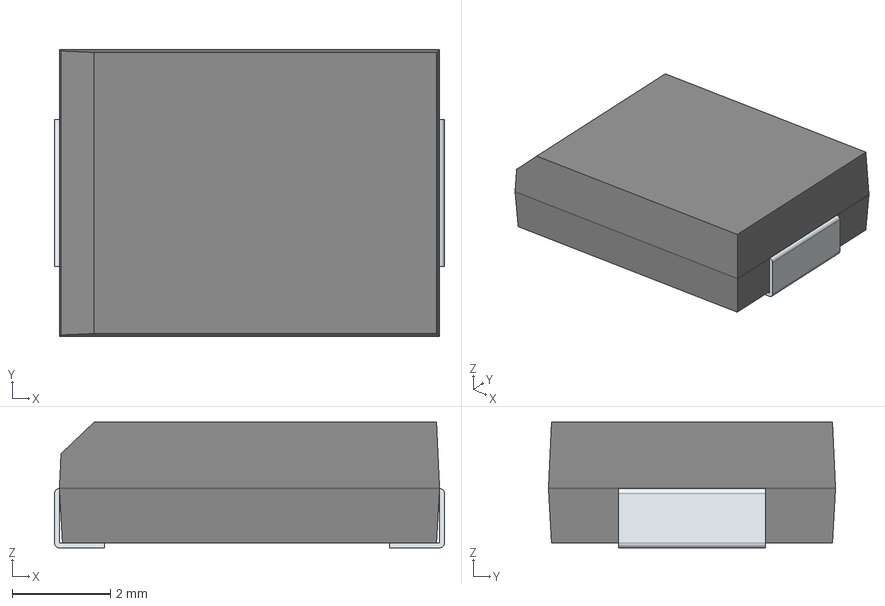
[picture p67: CAD file, 2025-10-28]
PCB_Expert_in_Teams/Models/MBRS540T3G/3D/MBRS540T3G.stp
7.94 x 5.84 x 2.56 mm
FilletPin1
FilletPin2
