zayinconde/Expert_In_Teams/PCB_Expert_in_Teams/Models/PCM5102APWR/3D/PCM5102APWR.stp

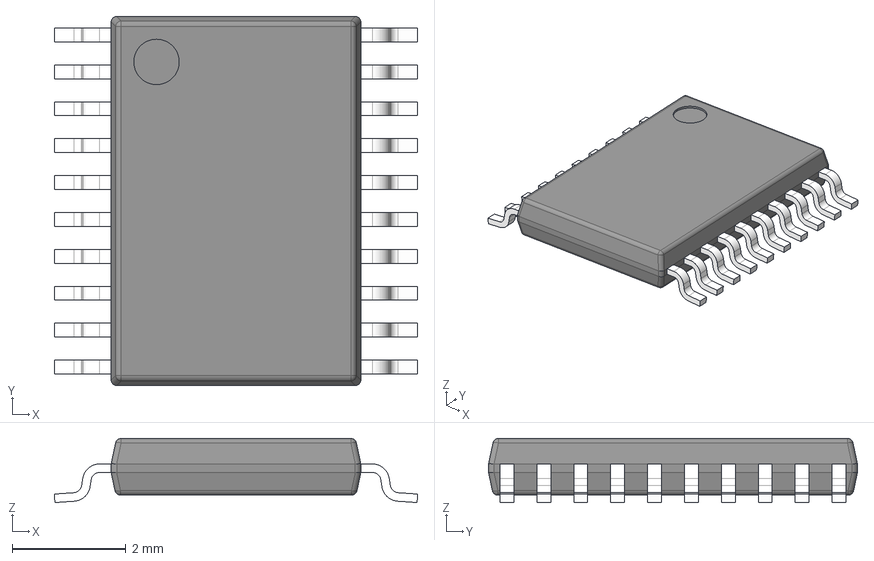
[picture p68: CAD file, 2025-11-10]
PCB_Expert_in_Teams/Models/PCM5102APWR/3D/PCM5102APWR.stp
6.40 x 6.50 x 1.13 mm
BODY-TSSOP
LEAD-TSSOP x 20
PIN1
