zayinconde/Expert_In_Teams/PCB_Expert_in_Teams/Models/SRP6530A-8R2M/3D/SRP6530A-8R2M.stp

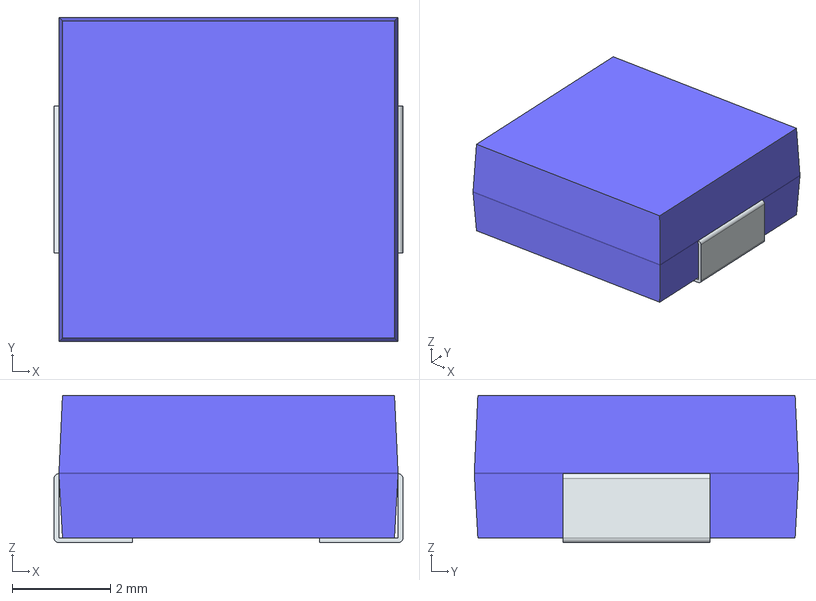
[picture p69: CAD file, 2025-11-06]
PCB_Expert_in_Teams/Models/SRP6530A-8R2M/3D/SRP6530A-8R2M.stp
7.10 x 6.60 x 3.00 mm
FilletPin1
FilletPin2
