zayinconde/Expert_In_Teams/PCB_Expert_in_Teams/Models/STUSB4500QTR/3D/STUSB4500QTR.stp

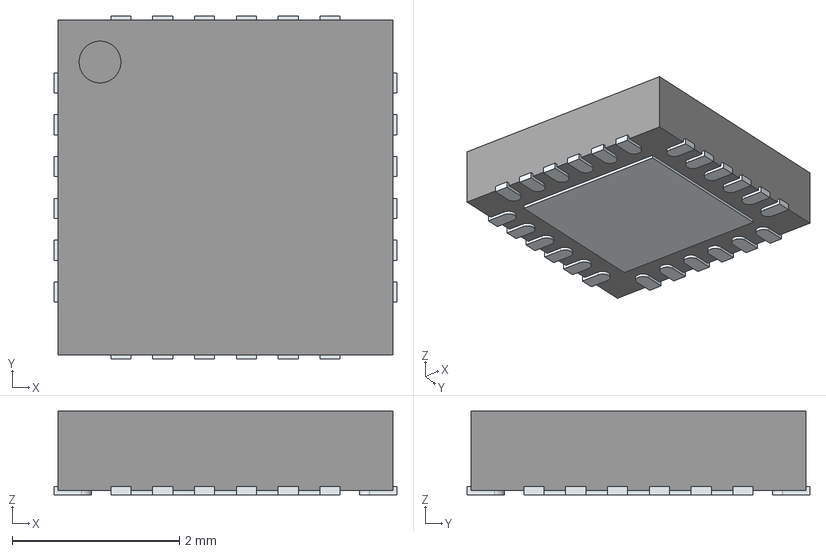
[picture p70: CAD file, 2025-10-30]
PCB_Expert_in_Teams/Models/STUSB4500QTR/3D/STUSB4500QTR.stp
4.10 x 4.10 x 1.00 mm
ThermalPin
PinsArrayLR
PinsArrayTB
