zayinconde/Expert_In_Teams/PCB_Expert_in_Teams/Models/T520D686M016ATE050/3D/T520D686M016ATE050.stp

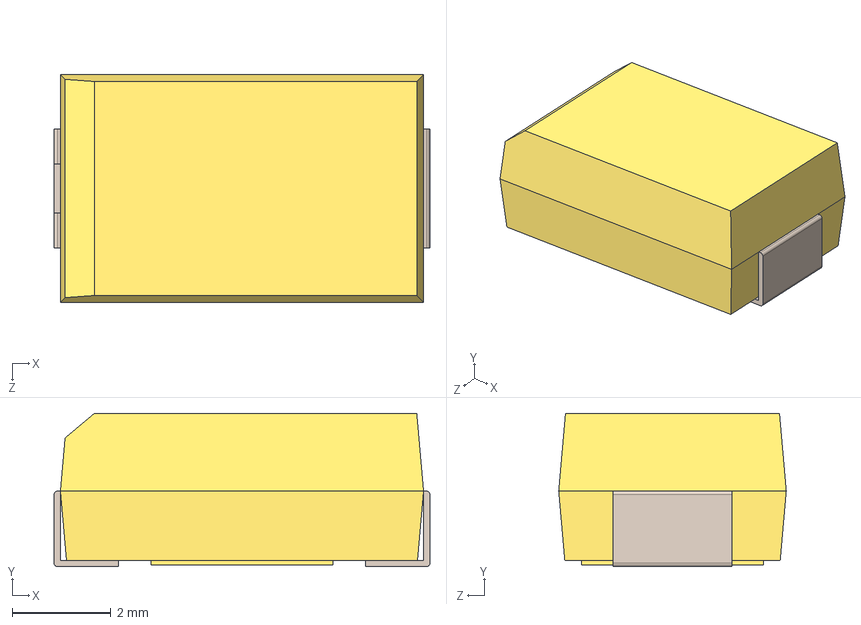
[picture p71: CAD file, 2025-11-06]
PCB_Expert_in_Teams/Models/T520D686M016ATE050/3D/T520D686M016ATE050.stp
7.60 x 3.10 x 4.60 mm
Case_Bottom_21
Case_Top_21
Case_Cathode_21
Case_Anode_21
