zayinconde/Expert_In_Teams/PCB_Expert_in_Teams/Models/Wurth Buttons/Downloads_STP_4307x30xx8xx_rev1.stp

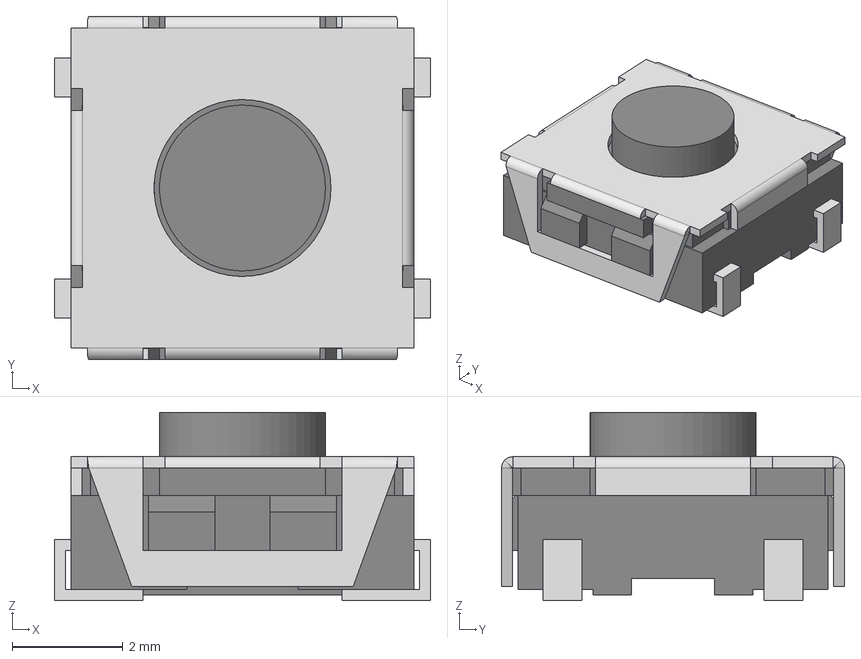
[picture p72: CAD file, 2025-11-12]
PCB_Expert_in_Teams/Models/Wurth Buttons/Downloads_STP_4307x30xx8xx_rev1.stp
6.80 x 6.20 x 3.40 mm
spring
actuator_3_4
cover
