zayinconde/Expert_In_Teams/PCB_Expert_in_Teams/PCB 2D DXF/AI_DEPUTY_PCB_MM_2D.dxf

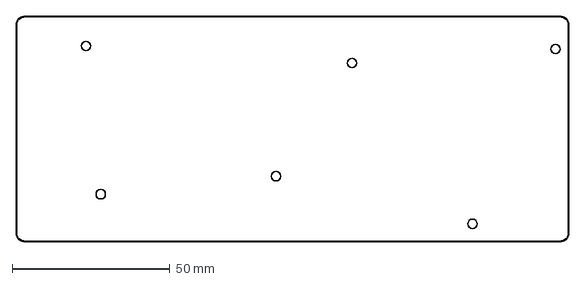
[picture p73: CAD file, 2025-12-23]
PCB_Expert_in_Teams/PCB 2D DXF/AI_DEPUTY_PCB_MM_2D.dxf
175.2 x 71.5 mm
