zayinconde/Expert_In_Teams/PCB_Expert_in_Teams/PCB 3D Renders/Rev v0.2/AI_deputy_PCB_V2.step

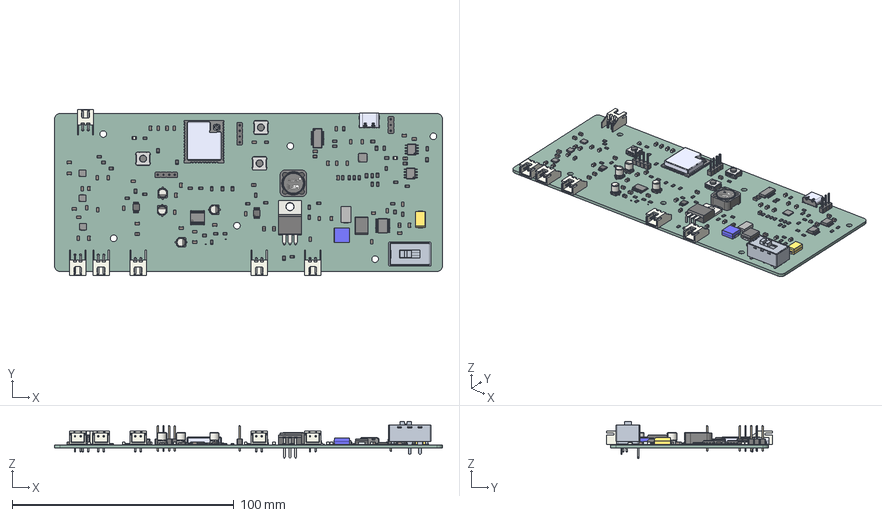
[picture p74: CAD file, 2025-12-02]
PCB_Expert_in_Teams/PCB 3D Renders/Rev v0.2/AI_deputy_PCB_V2.step
175.0 x 74.8 x 16.8 mm
C_0805_2012Metric x 54
R_0805_2012Metric x 52
L101121MS02Q_PART1
C_0201_0603Metric x 2
FilletPin1 x 2
FilletPin2 x 2
CP_Elec_4x5.4 x 4
IS31AP2005-SLS2-TR x 2
JST_XH_S2B-XH-A_1x02_P2.50mm_Horizontal x 3
JST_XH_S2B-XH-A-1_1x02_P2.50mm_Horizontal x 3
Case_Bottom_21
Case_Top_21
Case_Cathode_21
Case_Anode_21
ESP32-WROOM-32UE_M113EH6400UH3Q0_
spring x 3
actuator_3_4 x 3
cover x 3
LED_0805_2012Metric x 2
PinsArrayLR x 7
TO-220-3_Horizontal_TabDown
PinsArrayTB x 4
PinHeader_1x04_P2.54mm_Vertical x 2
PinHeader_1x03_P2.54mm_Vertical
Core
ShieldRing
Glue
Leadframe
SX2.0
端子1
端子2
ThermalPin
BODY-TSSOP
LEAD-TSSOP x 20
PIN1
BODY-SO
LEAD-SO x 20
THERMALPAD-SO
PIN1-ID
AI_deputy_PCB_PCB
