zayinconde/Expert_In_Teams/CAD Files/scent emitter concept.step

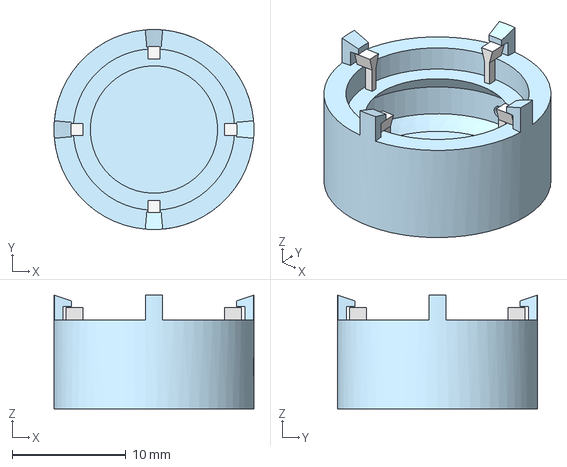
[picture p75: CAD file, 2026-01-20]
CAD Files/scent emitter concept.step
17.6 x 17.6 x 10.0 mm
