zayinconde/Expert_In_Teams/(list of files, cad)

Other CAD files:
PCB_Expert_in_Teams/Models/1054500101/1054500101.step
PCB_Expert_in_Teams/Models/744771220wruth_we-pd/3D/744771220.stp
PCB_Expert_in_Teams/Models/744771220wruth_we-pd/DEHDL/744771220/chips/chips.prt
PCB_Expert_in_Teams/Models/CYPD3177-24LQXQ/Allegro/qfn50p400x400x60-25n-d.psm
PCB_Expert_in_Teams/Models/CYPD3177-24LQXQ/DEHDL/cypd3177_24lqxq/chips/chips.prt
PCB_Expert_in_Teams/Models/DA7280-00FVC/Allegro/qfn65p300x300x84-12n.psm
PCB_Expert_in_Teams/Models/DA7280-00FVC/DEHDL/da7280_00fvc/chips/chips.prt
PCB_Expert_in_Teams/Models/DMP3098LSD-13/Allegro/soic127p600x175-8n.psm
PCB_Expert_in_Teams/Models/DMP3098LSD-13/DEHDL/dmp3098lsd_13/chips/chips.prt
PCB_Expert_in_Teams/Models/EEFSX0J151ER/Allegro/sx_package.psm
PCB_Expert_in_Teams/Models/EEFSX0J151ER/DEHDL/eefsx0j151er/chips/chips.prt
PCB_Expert_in_Teams/Models/ESP32-WROOM-32UE-N16/DEHDL/esp32_wroom_32ue_n16/chips/chips.prt
PCB_Expert_in_Teams/Models/FT231XS-R/Allegro/sop64p599x175-20n.psm
PCB_Expert_in_Teams/Models/FT231XS-R/DEHDL/ft231xs_r/chips/chips.prt
PCB_Expert_in_Teams/Models/IS31AP2005-SLS2-TR/Allegro/sop65p490x110-8n.psm
PCB_Expert_in_Teams/Models/IS31AP2005-SLS2-TR/DEHDL/is31ap2005_sls2_tr/chips/chips.prt
PCB_Expert_in_Teams/Models/LM25576QMH_NOPB/3D/LM25576QMH_NOPB.stp
PCB_Expert_in_Teams/Models/LM25576QMH_NOPB/Allegro/sop65p640x110-21n.psm
PCB_Expert_in_Teams/Models/LM25576QMH_NOPB/DEHDL/lm25576qmh_nopb/chips/chips.prt
PCB_Expert_in_Teams/Models/LM2576S-3.3_NOPB/Allegro/to170p1435x465-6n.psm
PCB_Expert_in_Teams/Models/LM2576S-3.3_NOPB/DEHDL/lm2576s_3.3_nopb/chips/chips.prt
PCB_Expert_in_Teams/Models/MBRS540T3G/Allegro/diom7958x256n.psm
PCB_Expert_in_Teams/Models/MBRS540T3G/DEHDL/mbrs540t3g/chips/chips.prt
PCB_Expert_in_Teams/Models/PCM5102APWR/Allegro/sop65p640x120-20n.psm
PCB_Expert_in_Teams/Models/PCM5102APWR/DEHDL/pcm5102apwr/chips/chips.prt
PCB_Expert_in_Teams/Models/PWR_SW_L101121MS02Q/3D/L101121MS02Q.stp
PCB_Expert_in_Teams/Models/PWR_SW_L101121MS02Q/Allegro/l101021ms02q.psm
PCB_Expert_in_Teams/Models/PWR_SW_L101121MS02Q/DEHDL/l101121ms02q/chips/chips.prt
PCB_Expert_in_Teams/Models/SRP6530A-8R2M/Allegro/indpm7166x300n.psm
PCB_Expert_in_Teams/Models/SRP6530A-8R2M/DEHDL/srp6530a_8r2m/chips/chips.prt
PCB_Expert_in_Teams/Models/STUSB4500QTR/Allegro/qfn50p400x400x100-25n-d.psm
PCB_Expert_in_Teams/Models/STUSB4500QTR/DEHDL/stusb4500qtr/chips/chips.prt
PCB_Expert_in_Teams/Models/T520D686M016ATE050/Allegro/t520d.psm
PCB_Expert_in_Teams/Models/T520D686M016ATE050/DEHDL/t520d686m016ate050/chips/chips.prt
PCB_Expert_in_Teams/Models/USBC_16p_2.0_217179-0001/2171790001.step
PCB_Expert_in_Teams/Models/USBC_16p_2.0_217179-0001/3D/217179-0001.stp
PCB_Expert_in_Teams/PCB 3D Renders/Rev v0.1/PCB OUTLINE 2D dxf.dxf
PCB_Expert_in_Teams/PCB 3D Renders/Rev v0.1/PCB Outline dxf.dxf
