zayinconde/Expert_In_Teams/Report/Images/integration_test_img.JPG

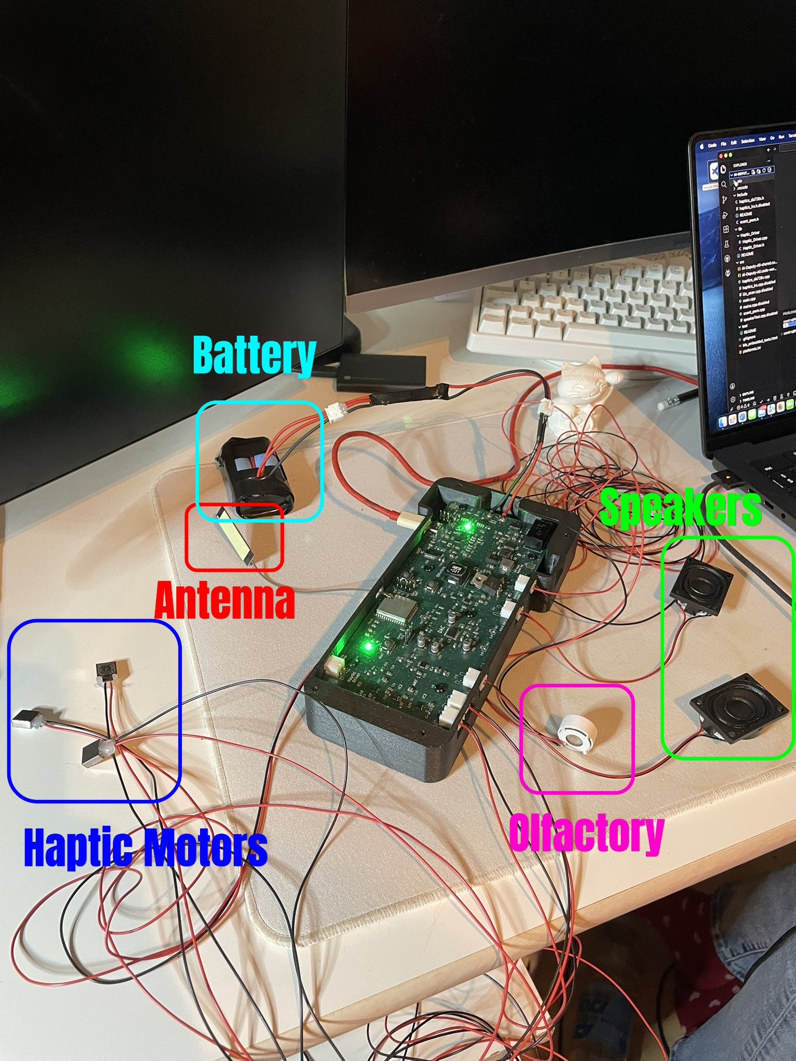
Report/Images/integration_test_img.JPG
