zayinconde/Expert_In_Teams/Report/Images/olfactoryTest.JPEG

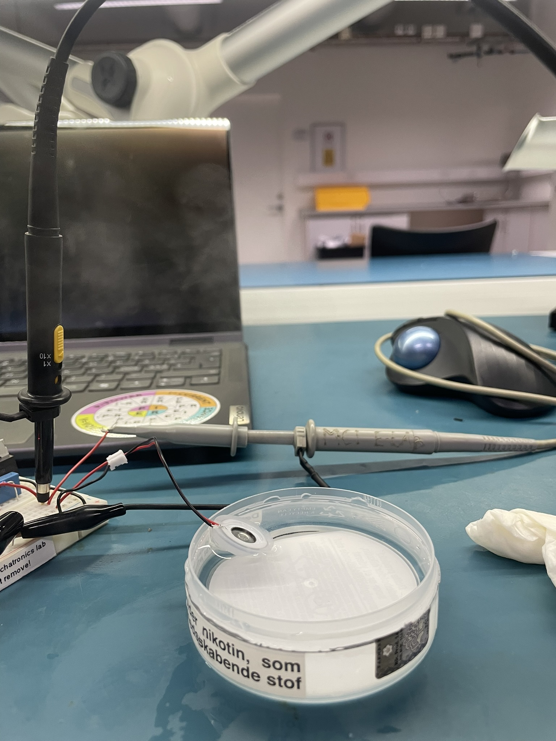
Report/Images/olfactoryTest.JPEG
