zayinconde/Expert_In_Teams/DC-DC Converter Design/matlab_DCDC_calculations.pdf

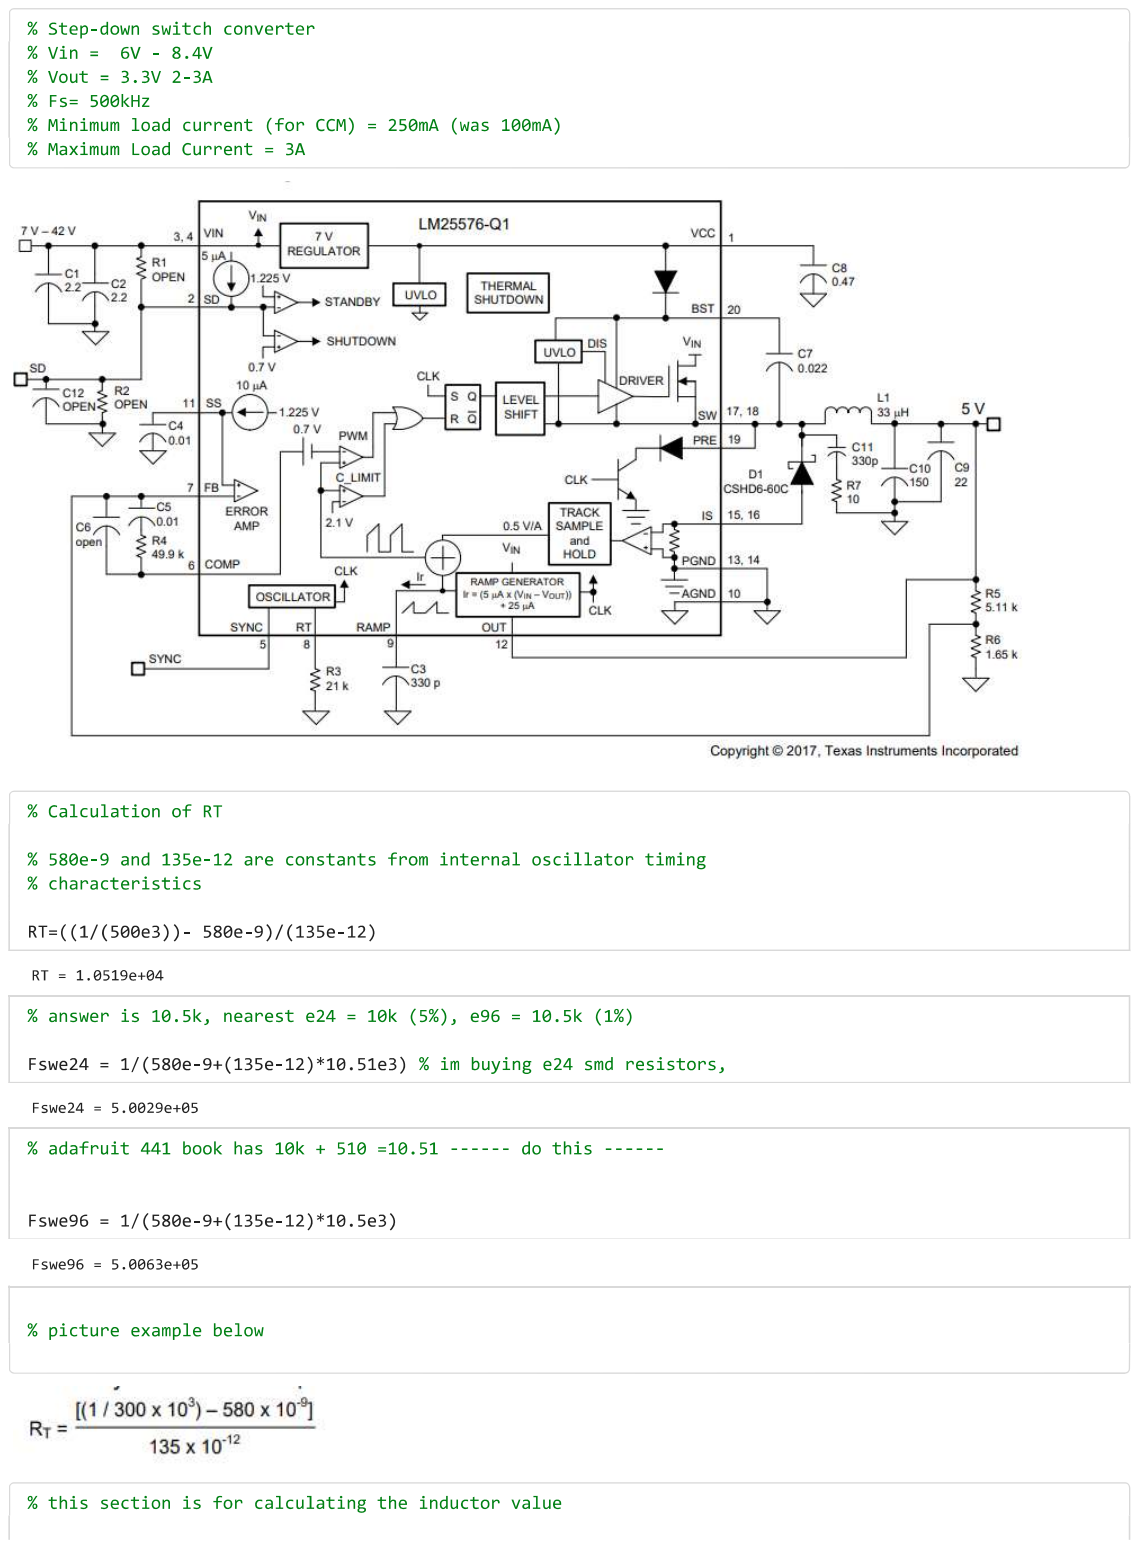
[picture p78: page 1]

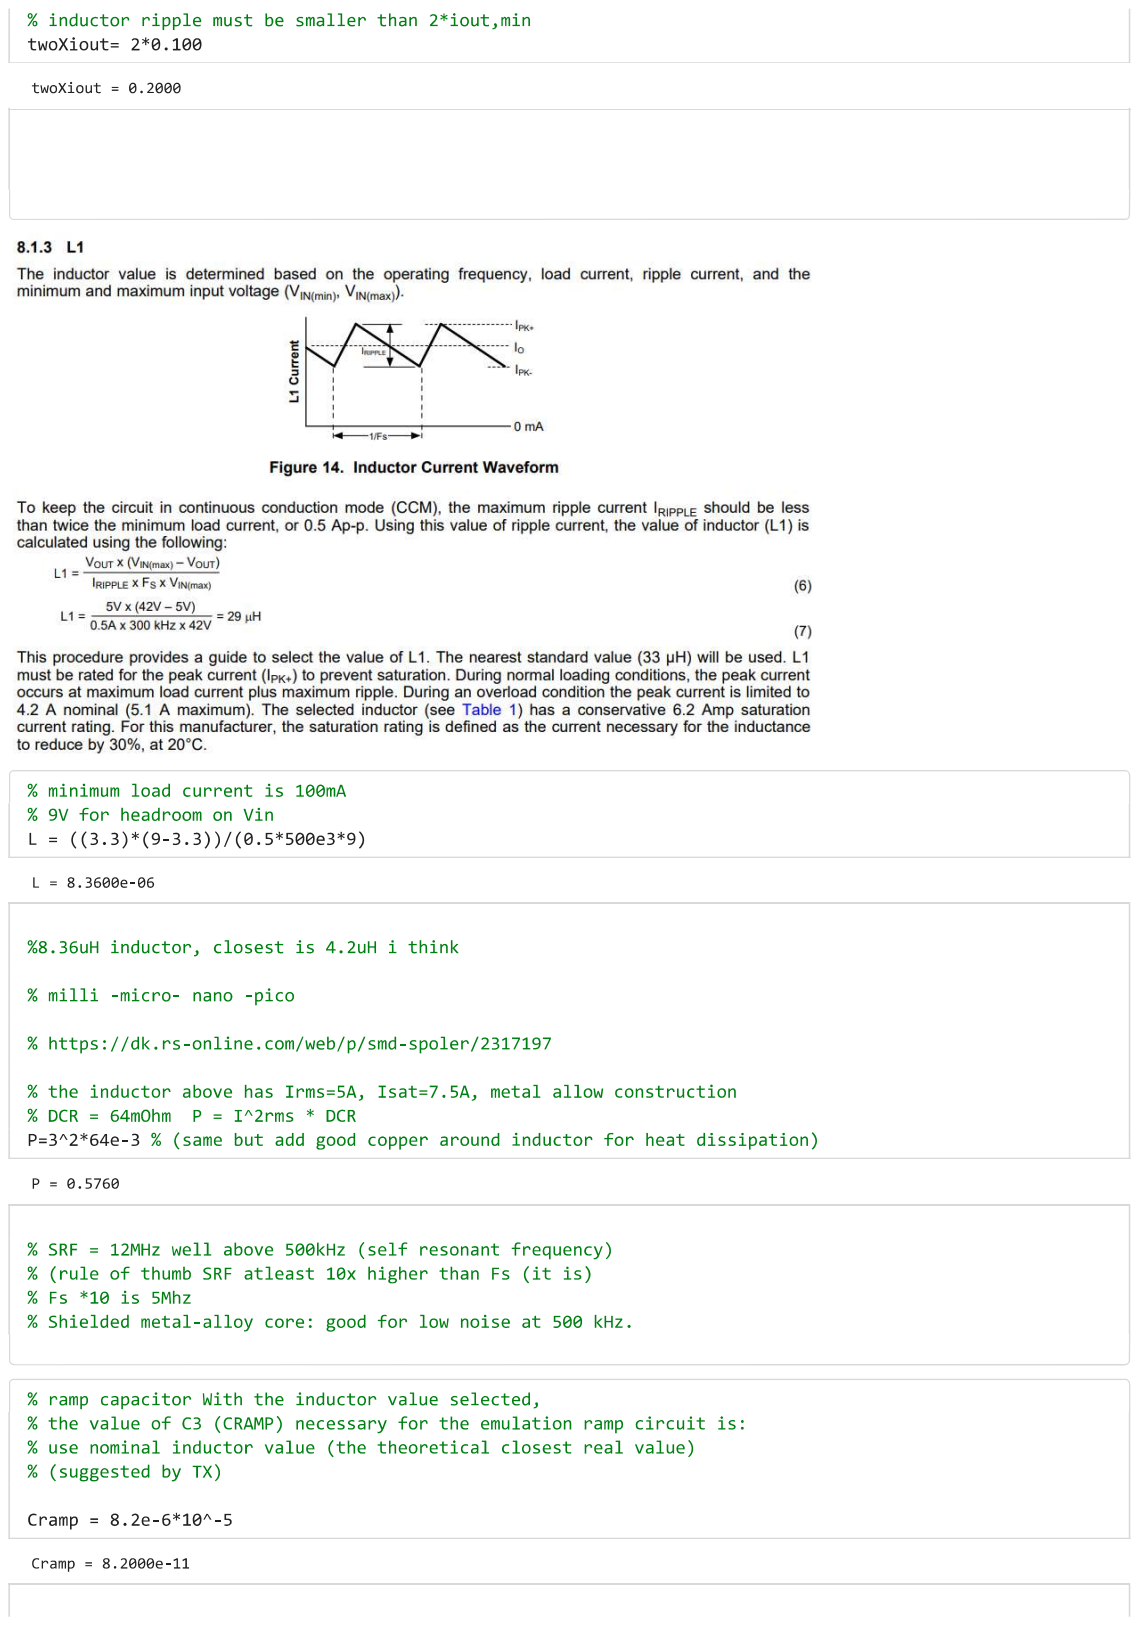
[picture p79: page 2]

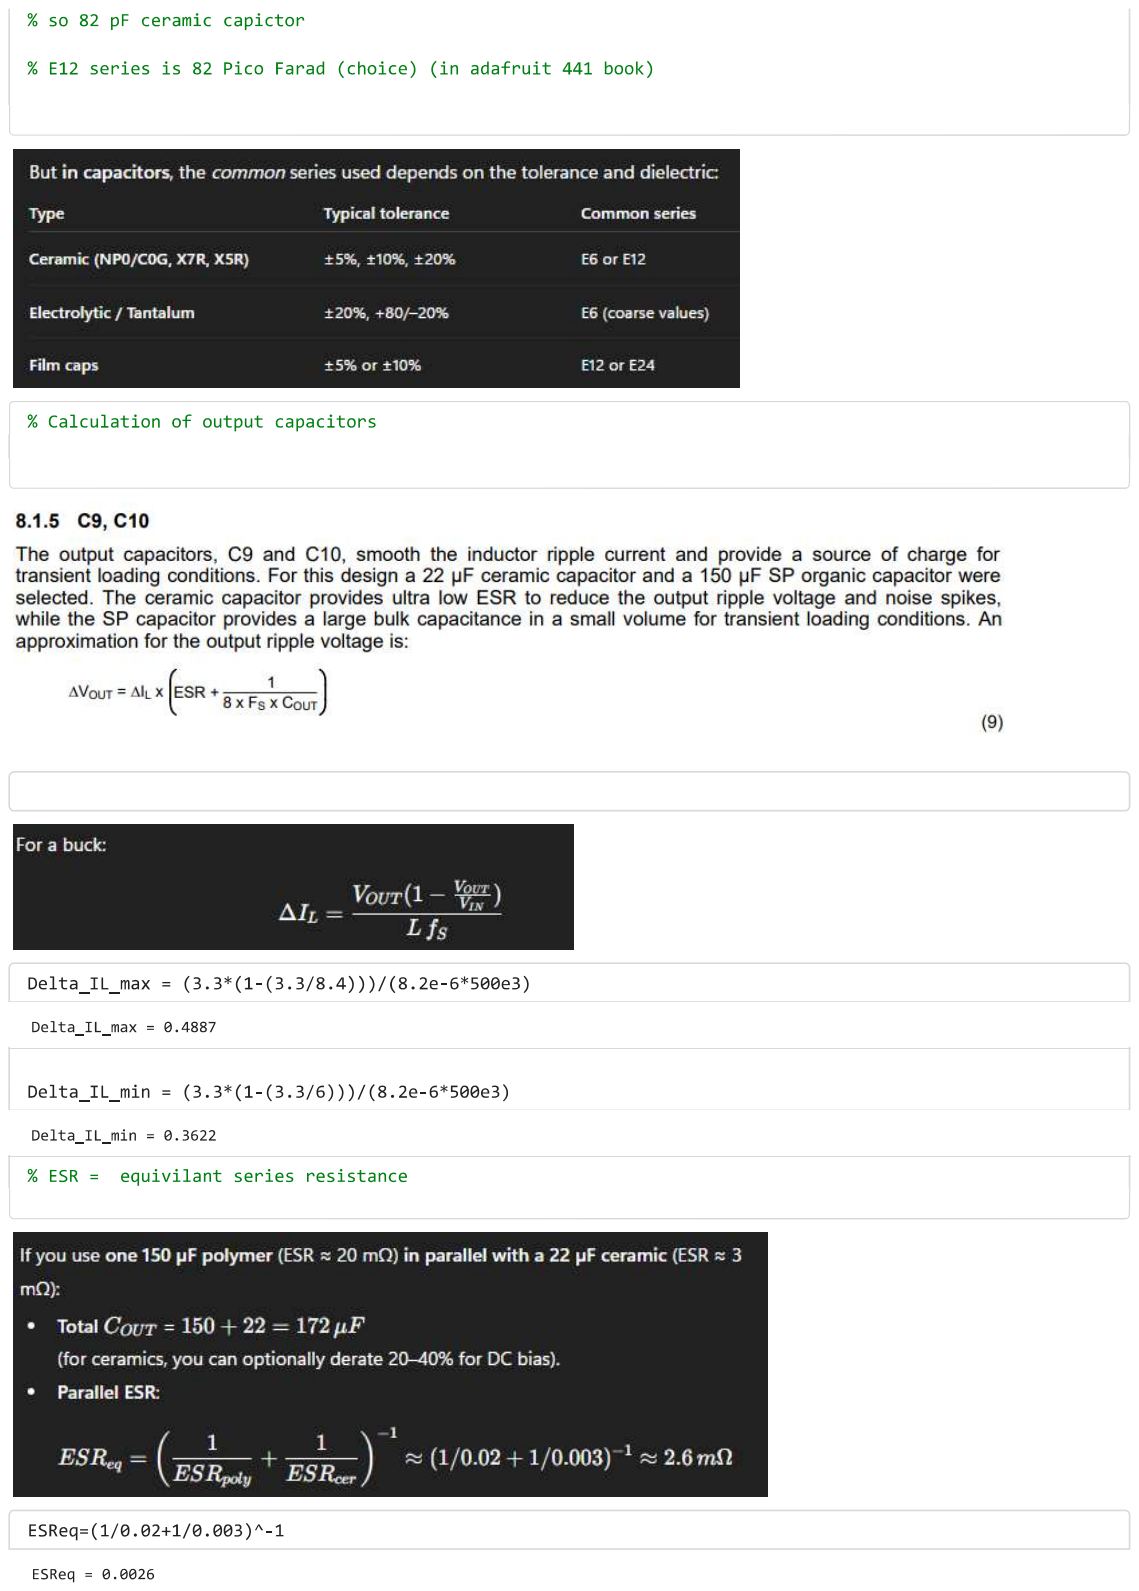
[picture p80: page 3]

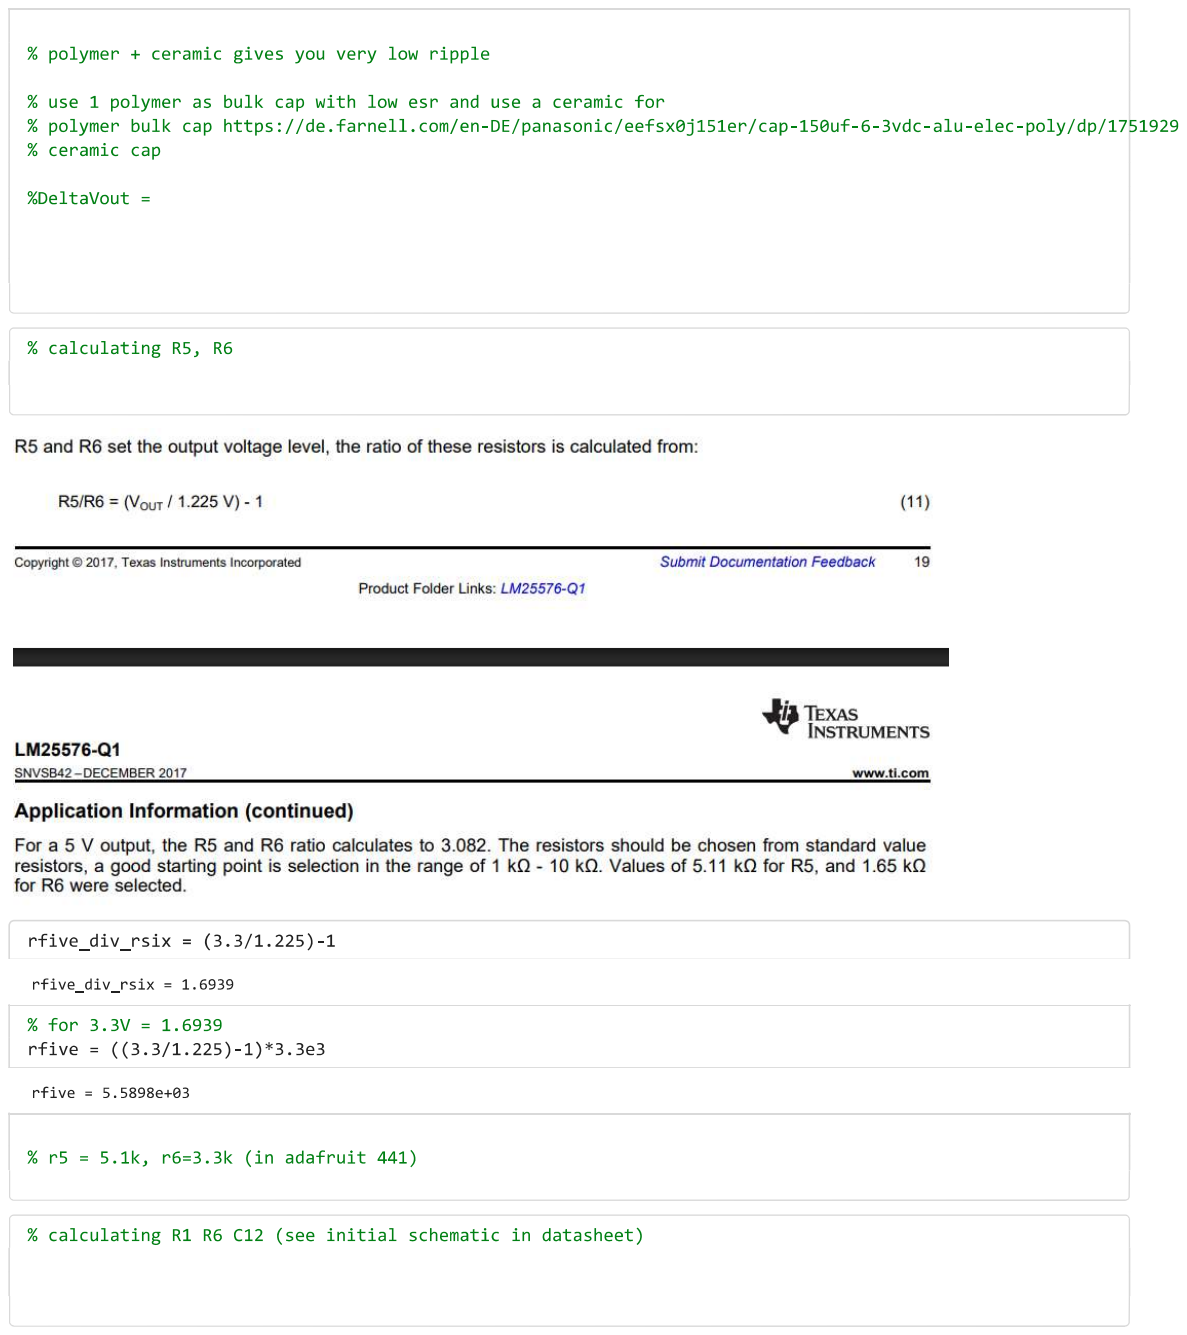
[picture p81: page 4]

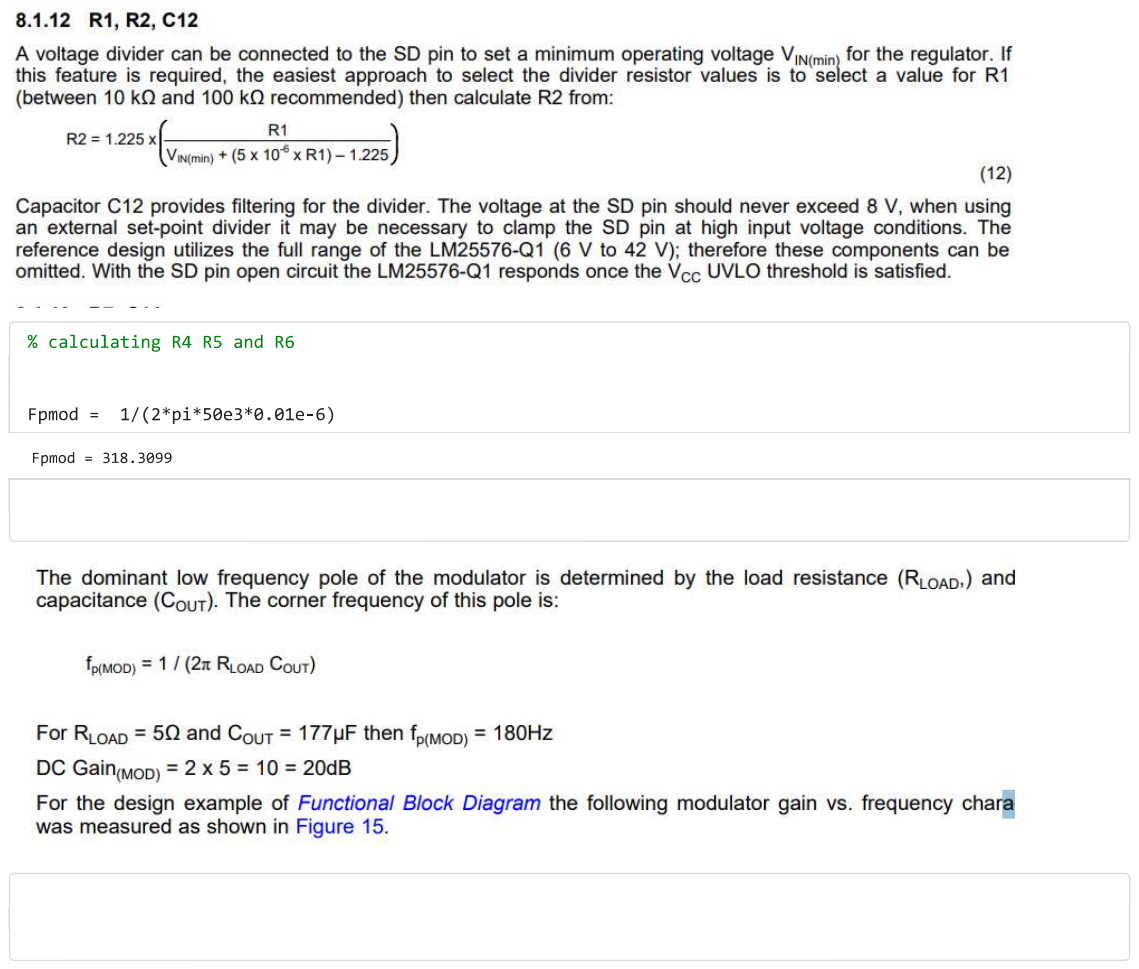
[picture p82: page 5]
