zayinconde/Expert_In_Teams/DC-DC Converter Design/Draft1.asc

M1: nmos; IPF050N03L
M2: pmos; IRF7205
M3: nmos; IPF050N03L
M4: pmos; IRF7205
M5: nmos; IPF050N03L
Q1: npn; 2N3904
Q2: pnp; 2N3906
R1: res; 3
R2: res; 1.2
R3: res; 1.2
R4: res; 10k
R5: res; 3
R6: res; 1.2
R7: res; 10k
V1: voltage; 12
V2: voltage; PULSE(0 3.3V 0 0 0 4.54u 9.1u)
V3: voltage; 12
V4: voltage; PULSE(0 3.3V 0 0 0 4.54u 9.1u)
V5: voltage; 12
V6: voltage; PULSE(0 3.3V 0 0 0 4.54u 9.1u)
Named nets: 0
.tran 100u
LOW SIDE SWITCHING N channel MOSFET
HIGH SIDE SWITCHING P-channel MOSFET
This is an example of how you do PMOS High Side Switching and NMOS low side switching with a 3.3V gate voltage from MCU
.tran 100u
HIGH SIDE SWITCHING P-channel MOSFET
