zayinconde/Expert_In_Teams/DC-DC Converter Design/LM25576_LTSPICE_Simulation.asc

C1: cap; 68µ
C2: cap; 10µ
C3: cap; 10µ
C4: cap; 0.01µ
C5: cap; 0.01µ
C6: cap; 150µ
C7: cap; 10µ
C8: cap; 10µ
C9: cap; 0.01µ
C10: cap; 82p
C11: cap; 22n
D1: schottky
L1: ind; 8.2µ
R1: res; 50k
R2: res; 10k
R3: res; 510
R4: res; 5.1k
R5: res; 3k
R6: res; 100k
U1: LM25576_TRANS
V1: voltage; 8.4
Named nets: 0
.tran 0.1
.lib "C:\\Users\\zayin\\OneDrive - Syddansk Universitet\\Desktop\\Expert in Teams - AI Deputy\\DC-DC Converter Design\\Ltspice Model\\LM25576_Trans_LTSPICE.lib"
