zayinconde/Expert_In_Teams/Simulations/load switch for pd trigger/Draft1.asc

C1: cap; 10µ
L1: ind; 220µ
M1: nmos
R1: res; 1
R2: res; 10k
V1: voltage; PULSE(0 3.3 0 0 0 4.54u 9.09u)
V2: voltage; 6
Named nets: 0
Battery Voltage
.tran 50u
