zayinconde/Expert_In_Teams/Simulations/load switch for pd trigger/Draft2.asc

C1: cap; 10µ
L1: ind; 220µ
R1: res; 10k
R2: res; 10k
V1: voltage; PULSE(0 6 0 0 0 4.54u 9.09u)
Named nets: 0
.tran 100u
