zayinconde/Expert_In_Teams/Simulations/load switch for pd trigger/PMOS_Load_switch_backtoback_sim.asc

C1: cap; 4.7µ
C2: cap; 4.7µ
C3: cap; 100n
C4: cap; 100n
C5: cap; 1µ
R1: res; 2.2k
R2: res; 100k
R4: res; 170k
R5: res; 10k
R7: res; 2.2k
U1: DMP3098LSD
U2: DMP3098LSD
V1: voltage; 5
V2: voltage; PULSE(0 3.3 0 0 0 4.5u 9u)
V3: voltage; 8.1
V4: voltage; 3
V5: voltage; PULSE(0 3.3 0 0 0 10u 20u)
Named nets: 0, gate, VDC_OUT, VBUS, Source
.include DMP3098LSD.lib
Vbus en
1
2
.tran 100u
VBUS
