zayinconde/Expert_In_Teams/Simulations/Olfactory/with_irlz44N.asc

C1: cap; 10µ
C2: cap; 5µ
L1: ind; 220µ
M1: nmos; IRLZ44N
R1: res; 10k
R2: res; 20
R3: res; 68
V1: voltage; PULSE(0 3.3 0 0 0 4.545u 9.09u)
V2: voltage; 3.3
Named nets: 0
.tran 300u
.include "IRLZ44N.spi"
ESP32 current limit
