zayinconde/Expert_In_Teams/Simulations/Olfactory/V1_based_on_demo_model.asc

C1: cap; 100µ
L1: ind; 200µ
M1: nmos
Piezo: cap; 2n
R1: res; 10k
V1: voltage; PULSE(0 3.3 0 1n 1n 0.294u 0.588u)
V2: voltage; 12
Named nets: 0, V1
.tran 1ms
