zayinconde/Expert_In_Teams/(list of files, drawings)

Other design files:
PCB_Expert_in_Teams/Models/CYPD3177-24LQXQ/Altium/CYPD3177-24LQXQ.SchLib
PCB_Expert_in_Teams/Models/CYPD3177-24LQXQ/Altium/QFN50P400X400X60-25N-D.PcbLib
PCB_Expert_in_Teams/Models/DA7280-00FVC/Altium/DA7280-00FVC.SchLib
PCB_Expert_in_Teams/Models/DA7280-00FVC/Altium/QFN65P300X300X84-12N.PcbLib
PCB_Expert_in_Teams/Models/DMP3098LSD-13/Altium/DMP3098LSD-13.SchLib
PCB_Expert_in_Teams/Models/DMP3098LSD-13/Altium/SOIC127P600X175-8N.PcbLib
PCB_Expert_in_Teams/Models/ESP32-WROOM-32UE-N16/Altium/ESP32-WROOM-32UE-N16.SchLib
PCB_Expert_in_Teams/Models/ESP32-WROOM-32UE-N16/Altium/ESP32WROOM32UEN16.PcbLib
PCB_Expert_in_Teams/Models/FT231XS-R/Altium/FT231XS-R.SchLib
PCB_Expert_in_Teams/Models/FT231XS-R/Altium/SOP64P599X175-20N.PcbLib
PCB_Expert_in_Teams/Models/IS31AP2005-SLS2-TR/Altium/IS31AP2005-SLS2-TR.SchLib
PCB_Expert_in_Teams/Models/IS31AP2005-SLS2-TR/Altium/SOP65P490X110-8N.PcbLib
PCB_Expert_in_Teams/Models/LM25576QMH_NOPB/Altium/LM25576QMH_NOPB.SchLib
PCB_Expert_in_Teams/Models/LM25576QMH_NOPB/Altium/SOP65P640X110-21N.PcbLib
PCB_Expert_in_Teams/Models/MBRS540T3G/Altium/DIOM7958X256N.PcbLib
PCB_Expert_in_Teams/Models/MBRS540T3G/Altium/MBRS540T3G.SchLib
PCB_Expert_in_Teams/Models/PCM5102APWR/Altium/PCM5102APWR.SchLib
PCB_Expert_in_Teams/Models/PCM5102APWR/Altium/SOP65P640X120-20N.PcbLib
PCB_Expert_in_Teams/Models/SRP6530A-8R2M/Altium/INDPM7166X300N.PcbLib
PCB_Expert_in_Teams/Models/SRP6530A-8R2M/Altium/SRP6530A-8R2M.SchLib
PCB_Expert_in_Teams/Models/STUSB4500QTR/Altium/QFN50P400X400X100-25N-D.PcbLib
PCB_Expert_in_Teams/Models/STUSB4500QTR/Altium/STUSB4500QTR.SchLib
