zayinconde/Expert_In_Teams/PCB_Expert_in_Teams/pcb/AI_deputy_PCB/AI_deputy_PCB.kicad_pcb

## KiCad design PCB_Expert_in_Teams/pcb/AI_deputy_PCB/AI_deputy_PCB.kicad_pcb (2025-12-23)

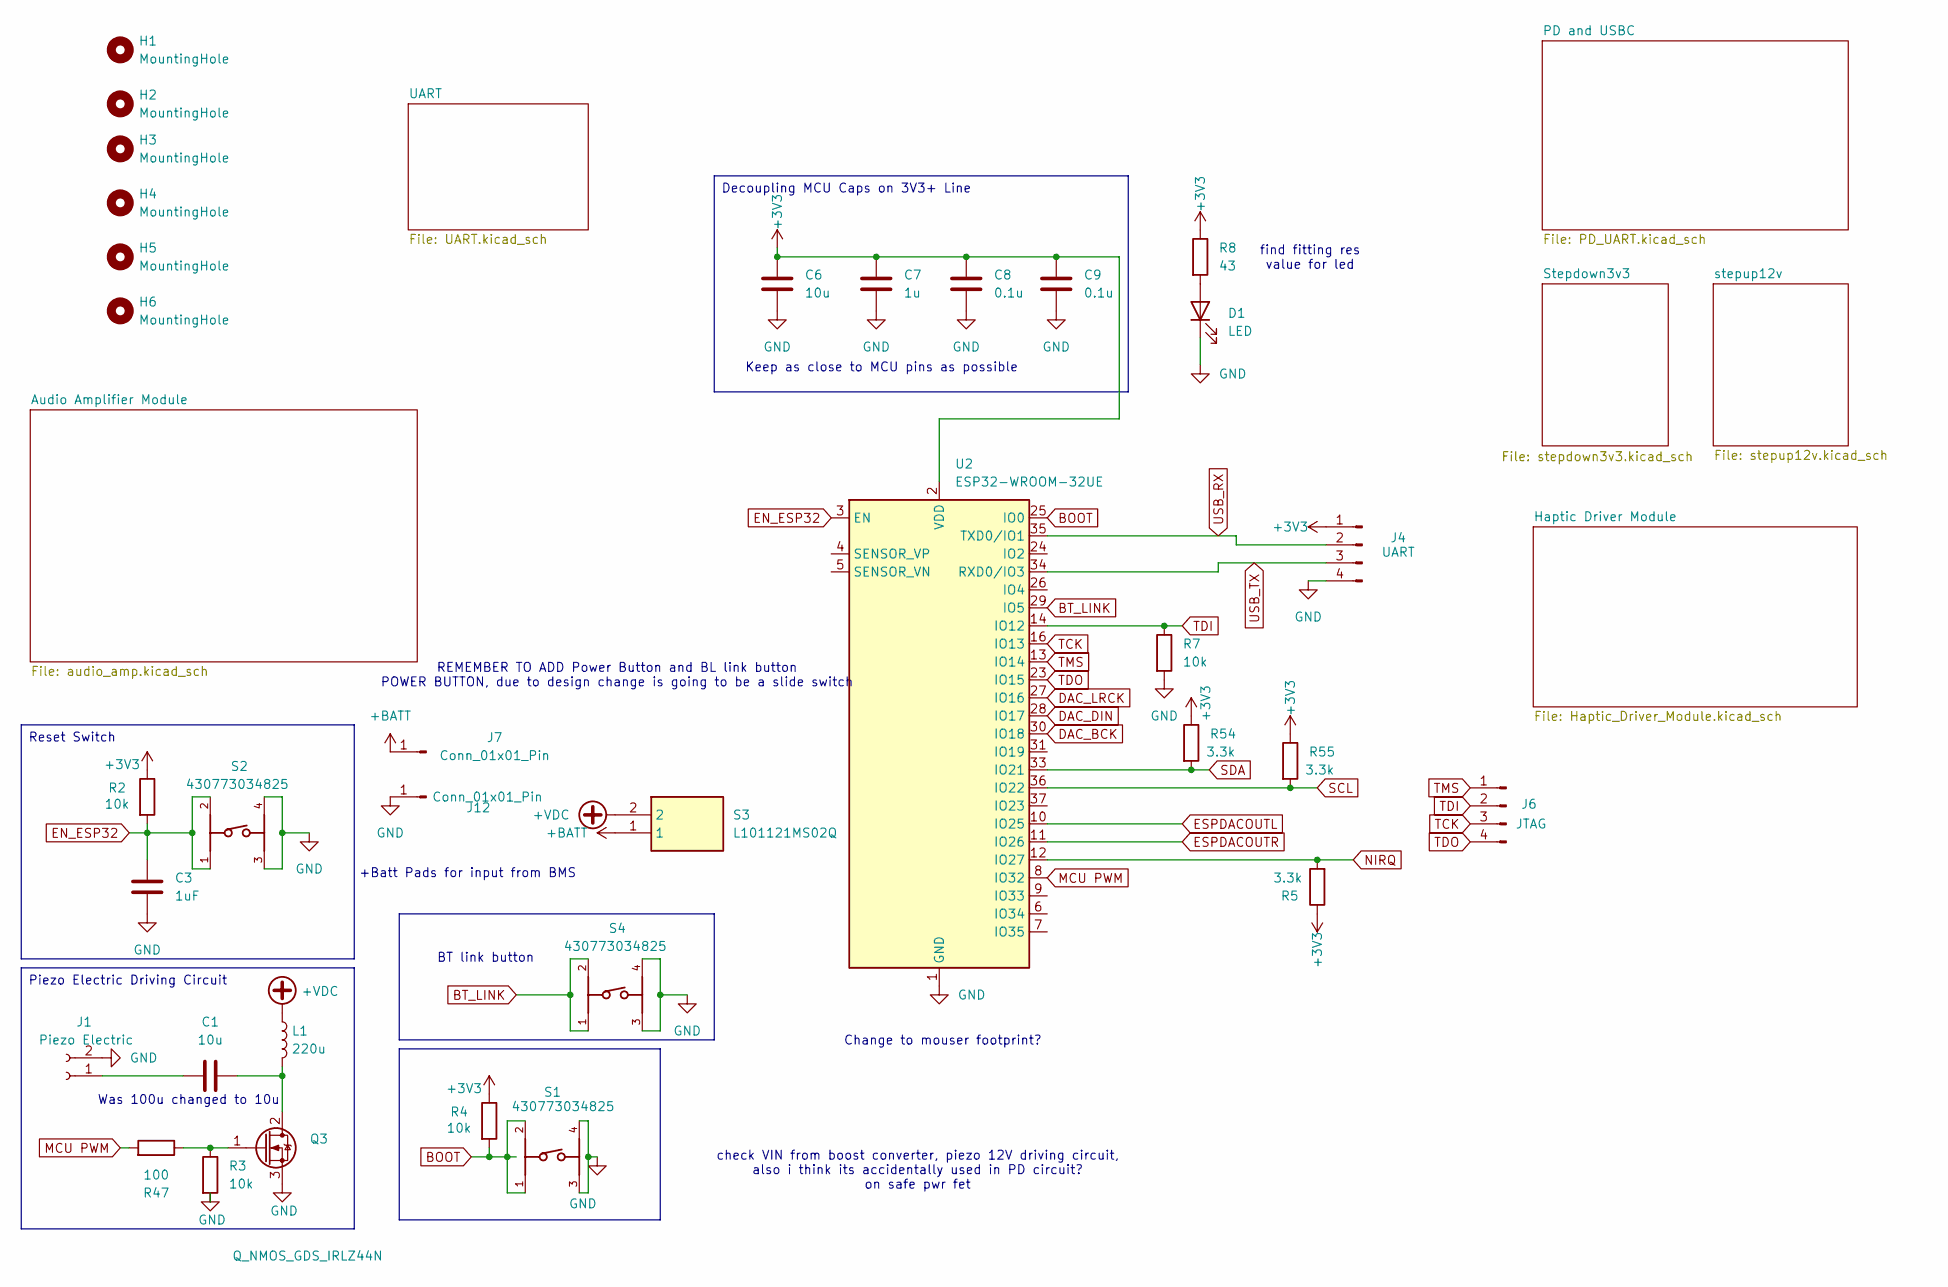
[picture p90: schematic AI_deputy_PCB.kicad_sch, AI Deputy]

Parts:
C1, C6: 10u; C_0805_2012Metric_Pad1.18x1.45mm_HandSolder
C3: 1uF; C_0805_2012Metric_Pad1.18x1.45mm_HandSolder
C7: 1u; C_0805_2012Metric_Pad1.18x1.45mm_HandSolder
C8, C9: 0.1u; C_0805_2012Metric_Pad1.18x1.45mm_HandSolder
D1: LED; LED_0805_2012Metric_Pad1.15x1.40mm_HandSolder
H1, H2, H3, H4, H5, H6: MountingHole; MountingHole_3mm
J1: Piezo Electric; JST_XH_S2B-XH-A-1_1x02_P2.50mm_Horizontal
J4: UART; PinHeader_1x04_P2.54mm_Vertical
J6: JTAG; PinHeader_1x04_P2.54mm_Vertical
J7, J12: Conn_01x01_Pin; TestPoint_Pad_4.0x4.0mm
L1: 220u; L_Wuerth_WE-PD-Typ-LS
Q3: Q_NMOS_GDS_IRLZ44N; TO-220-3_Horizontal_TabDown
R2, R3, R4, R7: 10k; R_0805_2012Metric_Pad1.20x1.40mm_HandSolder
R5, R54, R55: 3.3k; R_0805_2012Metric_Pad1.20x1.40mm_HandSolder
R8: 43; R_0805_2012Metric_Pad1.20x1.40mm_HandSolder
R47: 100; R_0805_2012Metric_Pad1.20x1.40mm_HandSolder
S1, S2, S4: 430773034825
S3: L101121MS02Q; PWR_SW_L101021MS02Q; Mouser Part Number 611-L101121MS02Q
U2: ESP32-WROOM-32UE

Connections:
+3V3: C6.1, C7.1, C8.1, C9.2, J4.1, R2.1, R4.1, R5.1, R8.1, R54.1, R55.1, U2.2 (VDD); also elsewhere on the board
+BATT: J7.1, S3.1
+VDC: L1.1, S3.2; also elsewhere on the board
BOOT: R4.2, S1.1, S1.2, U2.25 (IO0)
BT_LINK: S4.1, S4.2, U2.29 (IO5)
DAC_BCK: U2.30 (IO18); also elsewhere on the board
DAC_DIN: U2.28 (IO17); also elsewhere on the board
DAC_LRCK: U2.27 (IO16); also elsewhere on the board
EN_ESP32: C3.1, R2.2, S2.1, S2.2, U2.3 (EN)
ESPDACOUTL: U2.10 (IO25); also elsewhere on the board
ESPDACOUTR: U2.11 (IO26); also elsewhere on the board
GND: C3.2, C6.2, C7.2, C8.2, C9.1, D1.1 (K), J1.2, J4.4, J12.1, Q3.3 (S), R3.2, R7.2, S1.3, S1.4, S2.3, S2.4, S4.3, S4.4, U2.1 (GND), U2.15 (GND), U2.38 (GND), U2.39 (GND); also elsewhere on the board
MCU PWM: R47.2, U2.8 (IO32)
NIRQ: R5.2, U2.12 (IO27); also elsewhere on the board
unnamed: D1.2 (A), R8.2
unnamed: C1.1, J1.1
unnamed: C1.2, L1.2, Q3.2 (D)
unnamed: Q3.1 (G), R3.1, R47.1
SCL: R55.2, U2.36 (IO22); also elsewhere on the board
SDA: R54.2, U2.33 (IO21); also elsewhere on the board
TCK: J6.3, U2.16 (IO13)
TDI: J6.2, R7.1, U2.14 (IO12)
TDO: J6.4, U2.23 (IO15)
TMS: J6.1, U2.13 (IO14)
USB_RX: J4.2, U2.35 (TXD0/IO1); also elsewhere on the board
USB_TX: J4.3, U2.34 (RXD0/IO3); also elsewhere on the board

Notes on the sheet:
Keep as close to MCU pins as possible
Was 100u changed to 10u
BT link button
REMEMBER TO ADD Power Button and BL link button POWER BUTTON, due to design change is going to be a slide switch
+Batt Pads for input from BMS
find fitting res value for led
check VIN from boost converter, piezo 12V driving circuit, also i think its accidentally used in PD circuit? on safe pwr fet
Change to mouser footprint?
Piezo Electric Driving Circuit
Decoupling MCU Caps on 3V3+ Line
Reset Switch

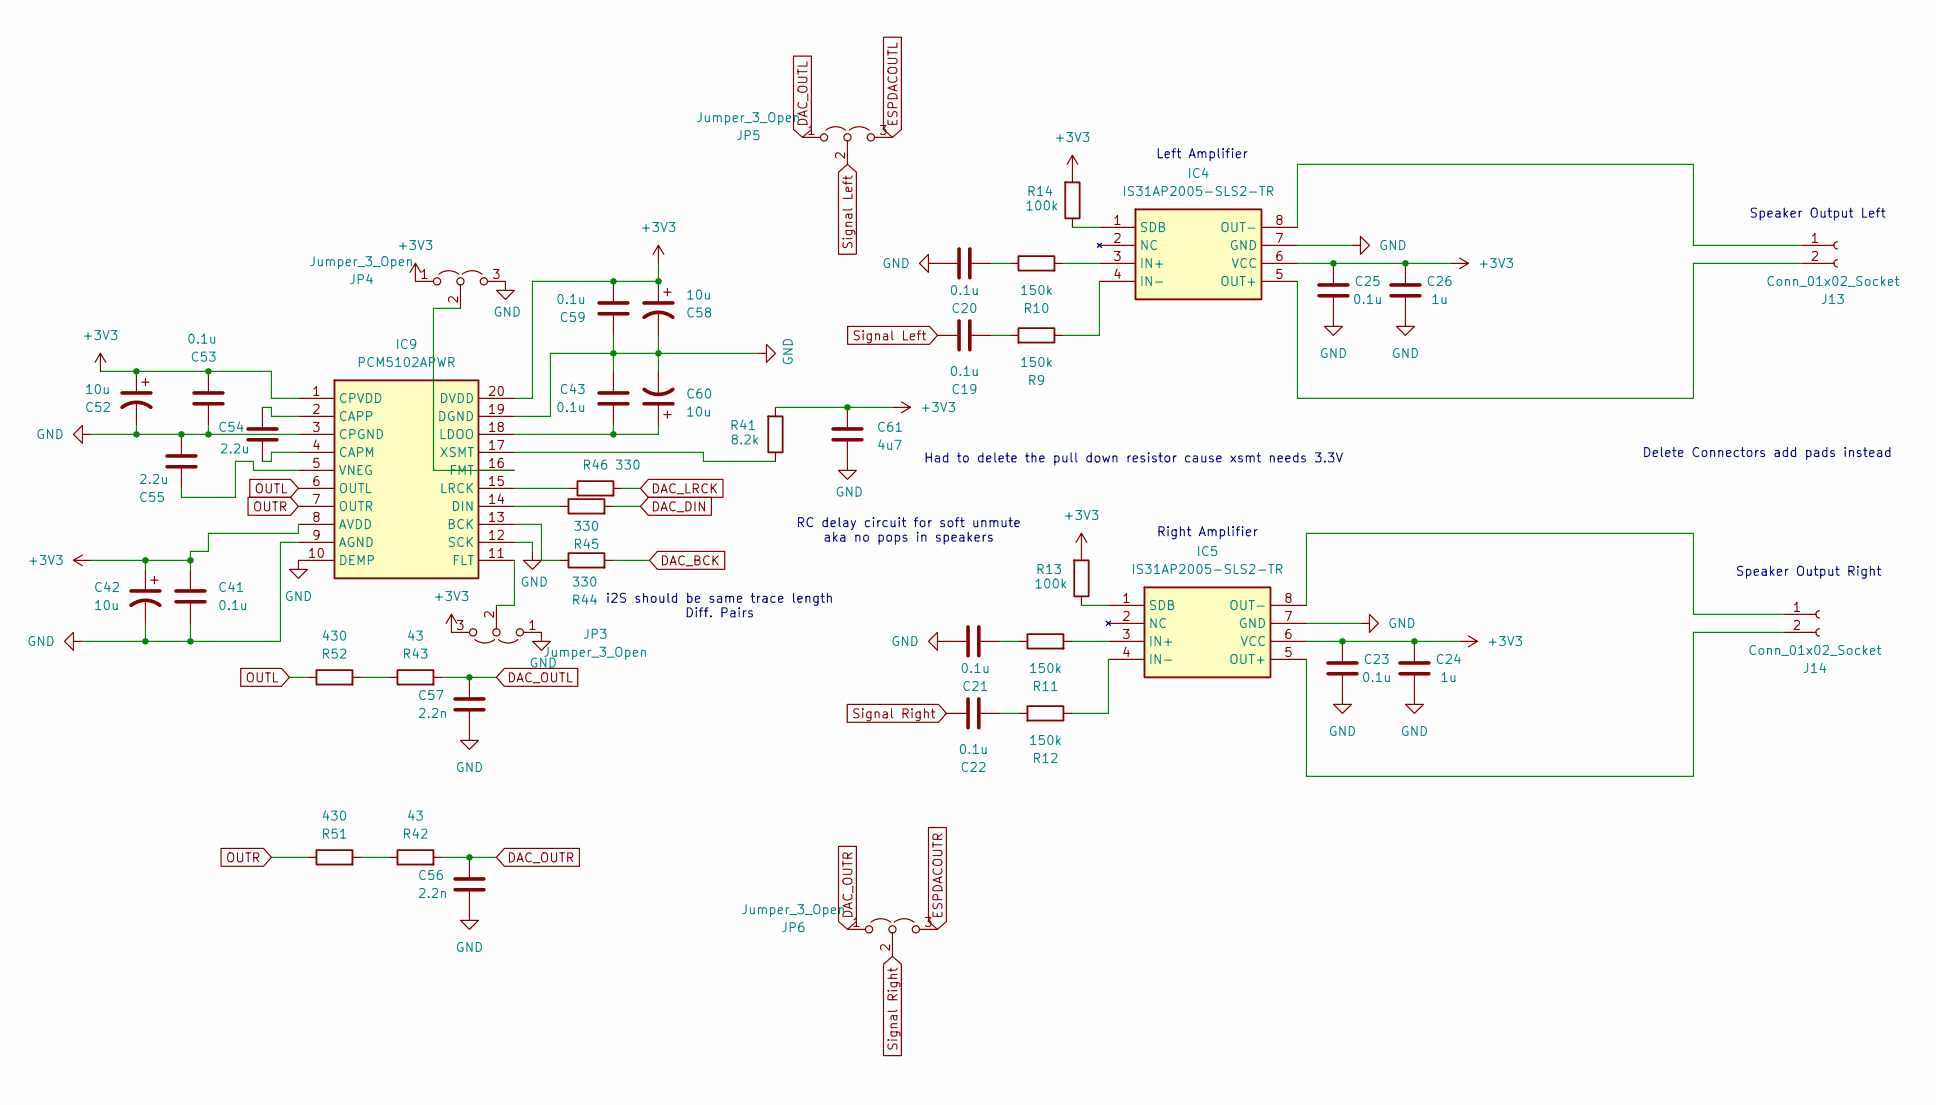
[picture p91: schematic audio_amp.kicad_sch, AI Deputy]

Parts:
C19, C20, C21, C22, C23, C25, C41, C43, C53, C59: 0.1u; C_0805_2012Metric_Pad1.18x1.45mm_HandSolder
C24, C26: 1u; C_0805_2012Metric_Pad1.18x1.45mm_HandSolder
C42, C52, C58, C60: 10u; CP_Elec_4x5.4
C54, C55: 2.2u; C_0805_2012Metric_Pad1.18x1.45mm_HandSolder
C56, C57: 2.2n; C_0201_0603Metric_Pad0.64x0.40mm_HandSolder
C61: 4u7; C_0805_2012Metric_Pad1.18x1.45mm_HandSolder
IC4, IC5: IS31AP2005-SLS2-TR; SOP65P490X110-8N; Manufacturer_Part_Number IS31AP2005-SLS2-TR
IC9: PCM5102APWR; SOP65P640X120-20N; Mouser Part Number 595-PCM5102APWR
J13, J14: Conn_01x02_Socket; JST_XH_S2B-XH-A-1_1x02_P2.50mm_Horizontal
JP3, JP4, JP5, JP6: Jumper_3_Open; SolderJumper-3_P1.3mm_Open_Pad1.0x1.5mm_NumberLabels
R9, R10, R11, R12: 150k; R_0805_2012Metric_Pad1.20x1.40mm_HandSolder
R13, R14: 100k; R_0805_2012Metric_Pad1.20x1.40mm_HandSolder
R41: 8.2k; R_0805_2012Metric_Pad1.20x1.40mm_HandSolder
R42, R43: 43; R_0805_2012Metric_Pad1.20x1.40mm_HandSolder
R44, R45, R46: 330; R_0805_2012Metric_Pad1.20x1.40mm_HandSolder
R51, R52: 430; R_0805_2012Metric_Pad1.20x1.40mm_HandSolder

Connections:
+3V3: C23.2, C24.2, C25.2, C26.2, C41.1, C42.1, C52.1, C53.2, C58.1, C59.2, C61.1, IC4.6 (VCC), IC5.6 (VCC), IC9.1 (CPVDD), IC9.8 (AVDD), IC9.20 (DVDD), JP3.3 (B), JP4.1 (A), R13.2, R14.2, R41.2; also elsewhere on the board
DAC_BCK: R44.2; also elsewhere on the board
DAC_DIN: R45.2; also elsewhere on the board
DAC_LRCK: R46.2; also elsewhere on the board
DAC_OUTL: C57.1, JP5.1 (A), R43.2
DAC_OUTR: C56.1, JP6.1 (A), R42.2
ESPDACOUTL: JP5.3 (B); also elsewhere on the board
ESPDACOUTR: JP6.3 (B); also elsewhere on the board
GND: C20.1, C21.1, C23.1, C24.1, C25.1, C26.1, C41.2, C42.2, C43.1, C52.2, C53.1, C55.1, C56.2, C57.2, C58.2, C59.1, C60.2, C61.2, IC4.7 (GND), IC5.7 (GND), IC9.3 (CPGND), IC9.9 (AGND), IC9.10 (DEMP), IC9.12 (SCK), IC9.19 (DGND), JP3.1 (A), JP4.3 (B); also elsewhere on the board
unnamed: C19.2, R9.2
unnamed: C20.2, R10.1
unnamed: C21.2, R11.1
unnamed: C22.2, R12.2
unnamed: IC4.3 (IN+), R10.2
unnamed: IC4.4 (IN-), R9.1
unnamed: IC4.5 (OUT+), J13.2
unnamed: IC4.8 (OUT-), J13.1
unnamed: IC4.1 (SDB), R14.1
unnamed: IC5.3 (IN+), R11.2
unnamed: IC5.4 (IN-), R12.1
unnamed: IC5.5 (OUT+), J14.2
unnamed: IC5.8 (OUT-), J14.1
unnamed: IC5.1 (SDB), R13.1
unnamed: IC9.13 (BCK), R44.1
unnamed: C54.2, IC9.4 (CAPM)
unnamed: C54.1, IC9.2 (CAPP)
unnamed: IC9.14 (DIN), R45.1
unnamed: IC9.11 (FLT), JP3.2 (C)
unnamed: IC9.16 (FMT), JP4.2 (C)
unnamed: C43.2, C60.1, IC9.18 (LDOO)
unnamed: IC9.15 (LRCK), R46.1
unnamed: C55.2, IC9.5 (VNEG)
unnamed 74: IC9.17 (XSMT), R41.1; also elsewhere on the board
unnamed: R42.1, R51.2
unnamed: R43.1, R52.2
OUTL: IC9.6 (OUTL), R52.1
OUTR: IC9.7 (OUTR), R51.1
Signal Left: C19.1, JP5.2 (C)
Signal Right: C22.1, JP6.2 (C)

Notes on the sheet:
Speaker Output Right
Delete Connectors add pads instead
Speaker Output Left
RC delay circuit for soft unmute aka no pops in speakers
Left Amplifier
i2S should be same trace length Diff. Pairs
Right Amplifier
Had to delete the pull down resistor cause xsmt needs 3.3V

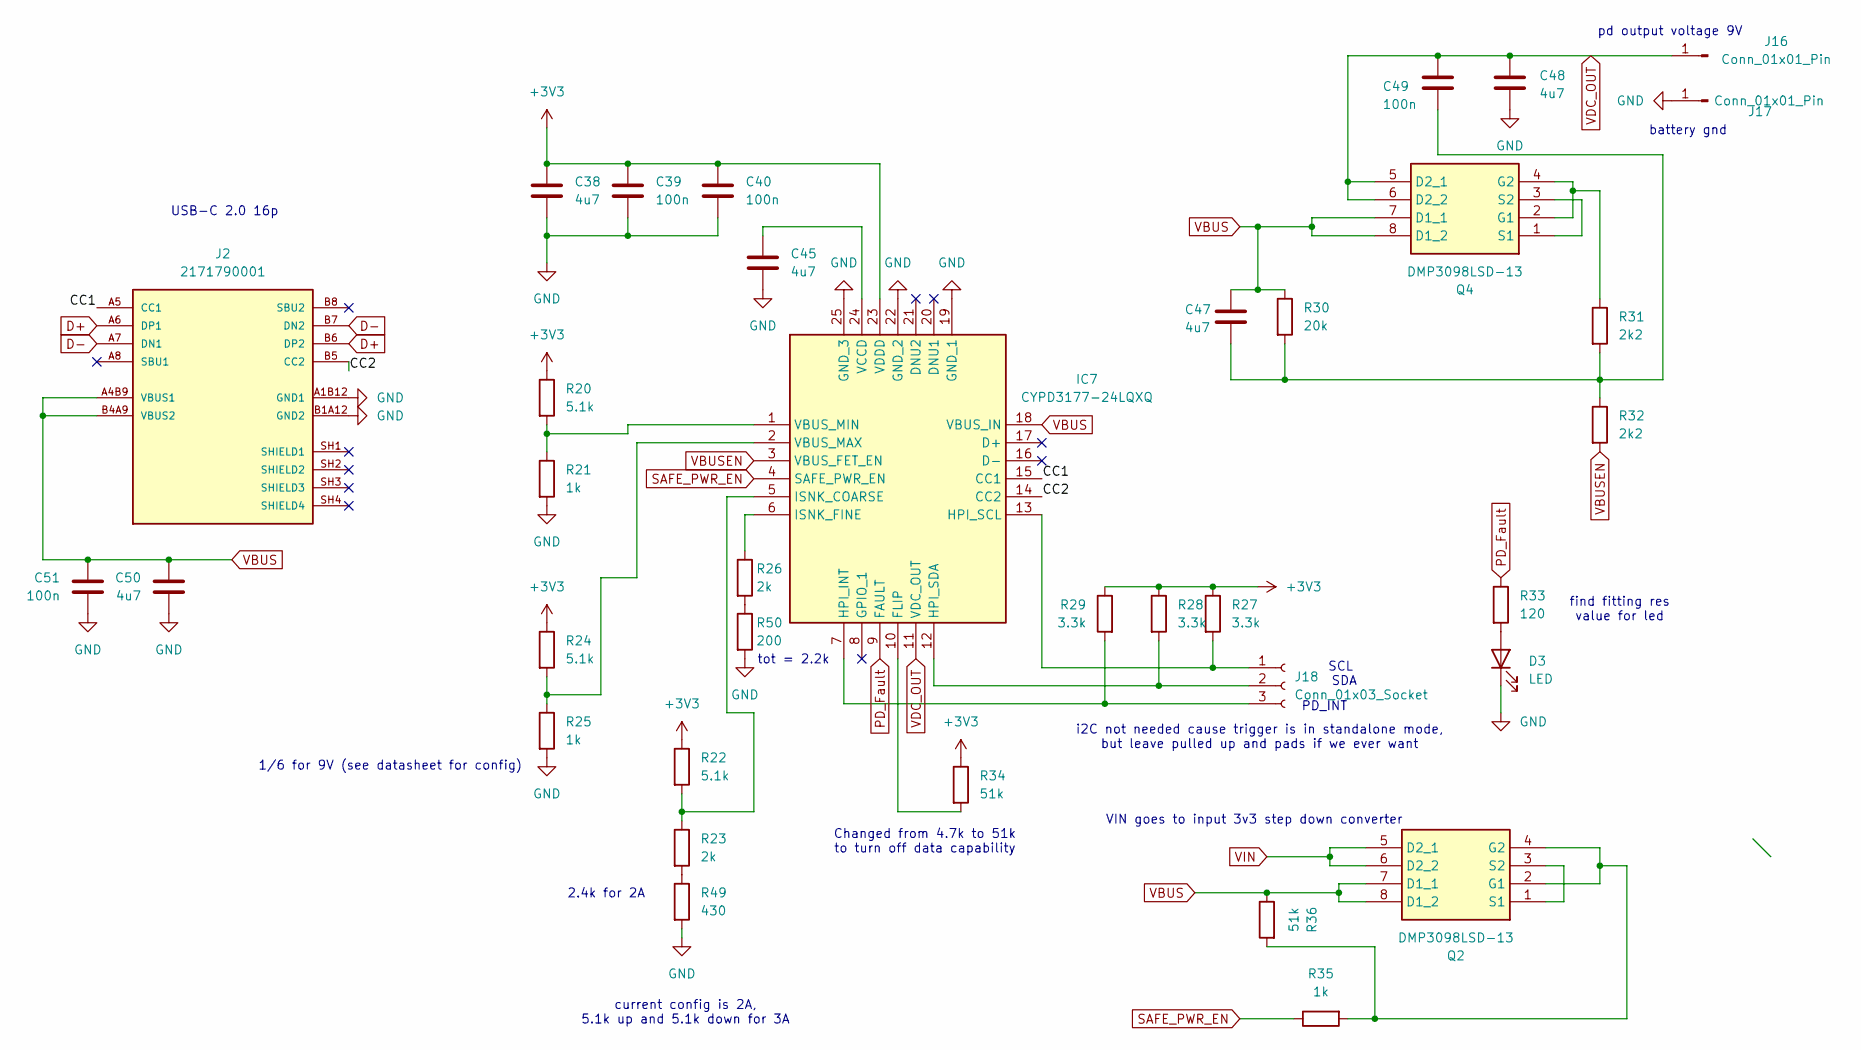
[picture p92: schematic PD_UART.kicad_sch, AI Deputy]

Parts:
C38, C45, C47, C48, C50: 4u7; C_0805_2012Metric_Pad1.18x1.45mm_HandSolder
C39, C40, C49, C51: 100n; C_0805_2012Metric_Pad1.18x1.45mm_HandSolder
D3: LED; LED_0805_2012Metric_Pad1.15x1.40mm_HandSolder
IC7: CYPD3177-24LQXQ; QFN50P400X400X60-25N-D; Mouser Part Number 727-CYPD3177-24LQXQ
J2: 2171790001; MOLEX_2171790001; PARTREV A1
J16, J17: Conn_01x01_Pin; TestPoint_Pad_4.0x4.0mm
J18: Conn_01x03_Socket; PinHeader_1x03_P2.54mm_Vertical
Q2, Q4: DMP3098LSD-13; SOIC127P600X175-8N; Mouser Part Number 621-DMP3098LSD-13
R20, R22, R24: 5.1k; R_0805_2012Metric_Pad1.20x1.40mm_HandSolder
R21, R25, R35: 1k; R_0805_2012Metric_Pad1.20x1.40mm_HandSolder
R23, R26: 2k; R_0805_2012Metric_Pad1.20x1.40mm_HandSolder
R27, R28, R29: 3.3k; R_0805_2012Metric_Pad1.20x1.40mm_HandSolder
R30: 20k; R_0805_2012Metric_Pad1.20x1.40mm_HandSolder
R31, R32: 2k2; R_0805_2012Metric_Pad1.20x1.40mm_HandSolder
R33: 120; R_0805_2012Metric_Pad1.20x1.40mm_HandSolder
R34, R36: 51k; R_0805_2012Metric_Pad1.20x1.40mm_HandSolder
R49: 430; R_0805_2012Metric_Pad1.20x1.40mm_HandSolder
R50: 200; R_0805_2012Metric_Pad1.20x1.40mm_HandSolder

Connections:
+3V3: C38.1, C39.1, C40.1, IC7.23 (VDDD), R20.1, R22.1, R24.1, R27.1, R28.1, R29.1, R34.1; also elsewhere on the board
/PD and USBC/CC1: IC7.15 (CC1), J2.A5 (CC1)
/PD and USBC/CC2: IC7.14 (CC2), J2.B5 (CC2)
D+: J2.A6 (DP1), J2.B6 (DP2); also elsewhere on the board
D-: J2.A7 (DN1), J2.B7 (DN2); also elsewhere on the board
GND: C38.2, C39.2, C40.2, C45.2, C48.2, C50.2, C51.2, D3.1 (K), IC7.19 (GND_1), IC7.22 (GND_2), IC7.25 (GND_3), J2.A1B12 (GND1), J2.B1A12 (GND2), J17.1, R21.2, R25.2, R49.2, R50.2; also elsewhere on the board
unnamed: C47.2, C49.2, R30.2, R31.2, R32.1
unnamed: D3.2 (A), R33.2
unnamed: IC7.10 (FLIP), R34.2
unnamed: IC7.7 (HPI_INT), J18.3, R29.2
unnamed: IC7.13 (HPI_SCL), J18.1, R27.2
unnamed: IC7.12 (HPI_SDA), J18.2, R28.2
unnamed: IC7.5 (ISNK_COARSE), R22.2, R23.1
unnamed: IC7.6 (ISNK_FINE), R26.1
unnamed: IC7.2 (VBUS_MAX), R24.2, R25.1
unnamed: IC7.1 (VBUS_MIN), R20.2, R21.1
unnamed: C45.1, IC7.24 (VCCD)
unnamed: Q2.2 (G1), Q2.4 (G2), R35.2, R36.2
unnamed: Q2.1 (S1), Q2.3 (S2)
unnamed: Q4.2 (G1), Q4.4 (G2), R31.1
unnamed: Q4.1 (S1), Q4.3 (S2)
unnamed: R23.2, R49.1
unnamed: R26.2, R50.1
PD_Fault: IC7.9 (FAULT), R33.1
SAFE_PWR_EN: IC7.4 (SAFE_PWR_EN), R35.1
VBUS: C47.1, C50.1, C51.1, IC7.18 (VBUS_IN), J2.A4B9 (VBUS1), J2.B4A9 (VBUS2), Q2.7 (D1_1), Q2.8 (D1_2), Q4.7 (D1_1), Q4.8 (D1_2), R30.1, R36.1
VBUSEN: IC7.3 (VBUS_FET_EN), R32.2
VDC_OUT: C48.1, C49.1, IC7.11 (VDC_OUT), J16.1, Q4.5 (D2_1), Q4.6 (D2_2)
VIN: Q2.5 (D2_1), Q2.6 (D2_2)

Notes on the sheet:
i2C not needed cause trigger is in standalone mode, but leave pulled up and pads if we ever want
Changed from 4.7k to 51k to turn off data capability
find fitting res value for led
SDA
current config is 2A, 5.1k up and 5.1k down for 3A
SCL
USB-C 2.0 16p
VIN goes to input 3v3 step down converter
PD_INT
battery gnd
pd output voltage 9V
tot = 2.2k
1/6 for 9V (see datasheet for config)
2.4k for 2A

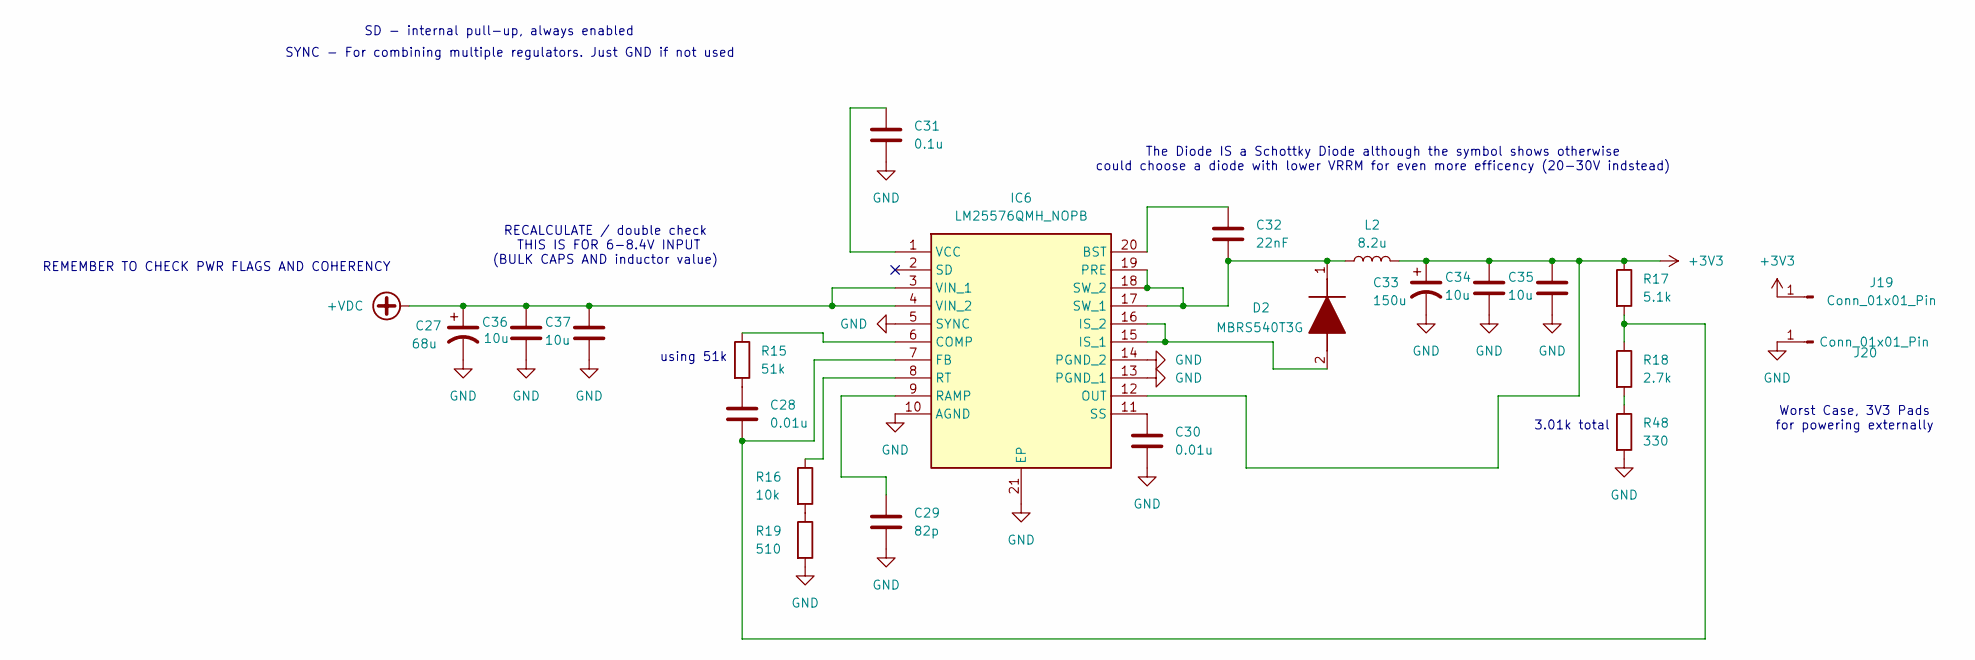
[picture p93: schematic stepdown3v3.kicad_sch, AI Deputy]

Parts:
C27: 68u; T520D
C28, C30: 0.01u; C_0805_2012Metric_Pad1.18x1.45mm_HandSolder
C29: 82p; C_0805_2012Metric_Pad1.18x1.45mm_HandSolder
C31: 0.1u; C_0805_2012Metric_Pad1.18x1.45mm_HandSolder
C32: 22nF; C_0805_2012Metric_Pad1.18x1.45mm_HandSolder
C33: 150u; SX_Package
C34, C35, C36, C37: 10u; C_0805_2012Metric_Pad1.18x1.45mm_HandSolder
D2: MBRS540T3G; DIOM7958X256N; Manufacturer_Part_Number MBRS540T3G
IC6: LM25576QMH_NOPB; SOP65P640X110-21N; Mouser Part Number 926-LM25576QMH/NOPB
J19, J20: Conn_01x01_Pin; TestPoint_Pad_4.0x4.0mm
L2: 8.2u; INDPM7166X300N
R15: 51k; R_0805_2012Metric_Pad1.20x1.40mm_HandSolder
R16: 10k; R_0805_2012Metric_Pad1.20x1.40mm_HandSolder
R17: 5.1k; R_0805_2012Metric_Pad1.20x1.40mm_HandSolder
R18: 2.7k; R_0805_2012Metric_Pad1.20x1.40mm_HandSolder
R19: 510; R_0805_2012Metric_Pad1.20x1.40mm_HandSolder
R48: 330; R_0805_2012Metric_Pad1.20x1.40mm_HandSolder

Connections:
+3V3: C33.1, C34.1, C35.1, IC6.12 (OUT), J19.1, L2.2, R17.1; also elsewhere on the board
+VDC: C27.1, C36.1, C37.1, IC6.3 (VIN_1), IC6.4 (VIN_2); also elsewhere on the board
GND: C27.2, C29.2, C30.2, C31.2, C33.2, C34.2, C35.2, C36.2, C37.2, IC6.5 (SYNC), IC6.10 (AGND), IC6.13 (PGND_1), IC6.14 (PGND_2), IC6.21 (EP), J20.1, R19.2, R48.2; also elsewhere on the board
unnamed: C28.1, R15.2
unnamed: D2.2 (A), IC6.15 (IS_1), IC6.16 (IS_2)
unnamed: C32.2, D2.1 (K), IC6.17 (SW_1), IC6.18 (SW_2), IC6.19 (PRE), L2.1
unnamed: C32.1, IC6.20 (BST)
unnamed: IC6.6 (COMP), R15.1
unnamed: C28.2, IC6.7 (FB), R17.2, R18.1
unnamed: C29.1, IC6.9 (RAMP)
unnamed: IC6.8 (RT), R16.1
unnamed: C30.1, IC6.11 (SS)
unnamed: C31.1, IC6.1 (VCC)
unnamed: R16.2, R19.1
unnamed: R18.2, R48.1

Notes on the sheet:
RECALCULATE / double check THIS IS FOR 6-8.4V INPUT (BULK CAPS AND inductor value)
SYNC - For combining multiple regulators. Just GND if not used
3.01k total
using 51k
SD - internal pull-up, always enabled
Worst Case, 3V3 Pads for powering externally
REMEMBER TO CHECK PWR FLAGS AND COHERENCY
The Diode IS a Schottky Diode although the symbol shows otherwise could choose a diode with lower VRRM for even more efficency (20-30V indstead)

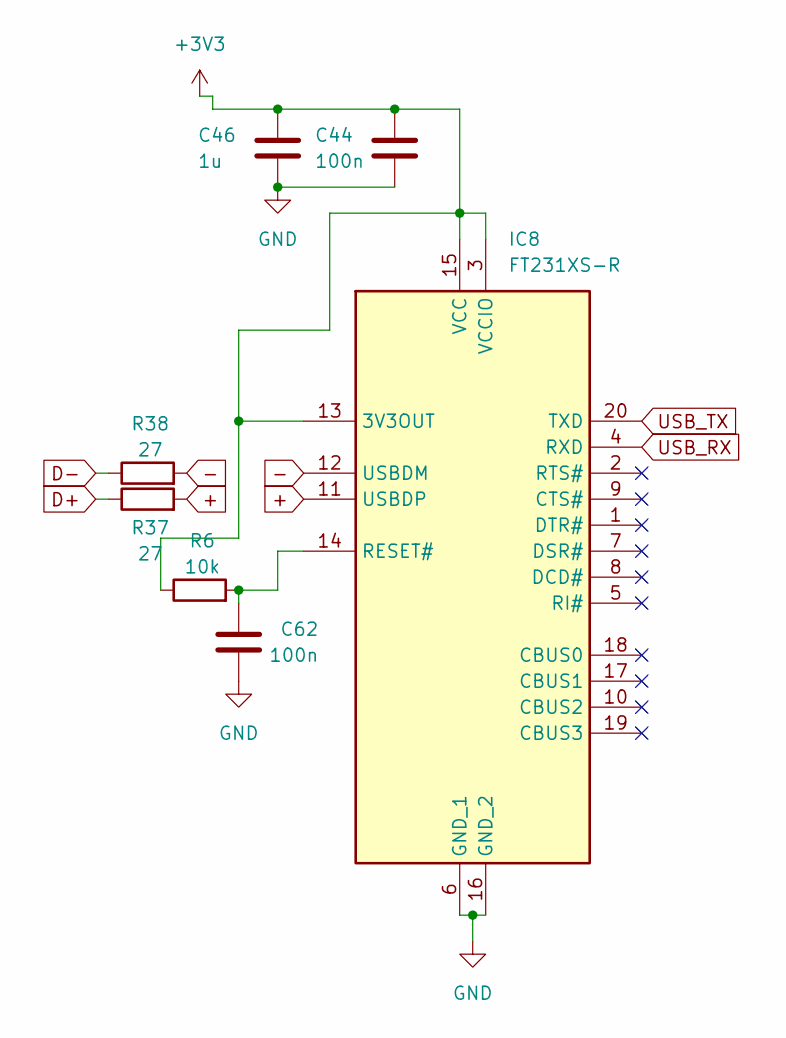
[picture p94: schematic UART.kicad_sch, AI Deputy]

Parts:
C44, C62: 100n; C_0805_2012Metric_Pad1.18x1.45mm_HandSolder
C46: 1u; C_0805_2012Metric_Pad1.18x1.45mm_HandSolder
IC8: FT231XS-R; SOP64P599X175-20N; Mouser Part Number 895-FT231XS-R
R6: 10k; R_0805_2012Metric_Pad1.20x1.40mm_HandSolder
R37, R38: 27; R_0805_2012Metric_Pad1.20x1.40mm_HandSolder

Connections:
+: IC8.11 (USBDP), R37.2
+3V3: C44.1, C46.1, IC8.3 (VCCIO), IC8.13 (3V3OUT), IC8.15 (VCC), R6.1; also elsewhere on the board
-: IC8.12 (USBDM), R38.2
D+: R37.1; also elsewhere on the board
D-: R38.1; also elsewhere on the board
GND: C44.2, C46.2, C62.2, IC8.6 (GND_1), IC8.16 (GND_2); also elsewhere on the board
unnamed: C62.1, IC8.14 (RESET#), R6.2
USB_RX: IC8.4 (RXD); also elsewhere on the board
USB_TX: IC8.20 (TXD); also elsewhere on the board

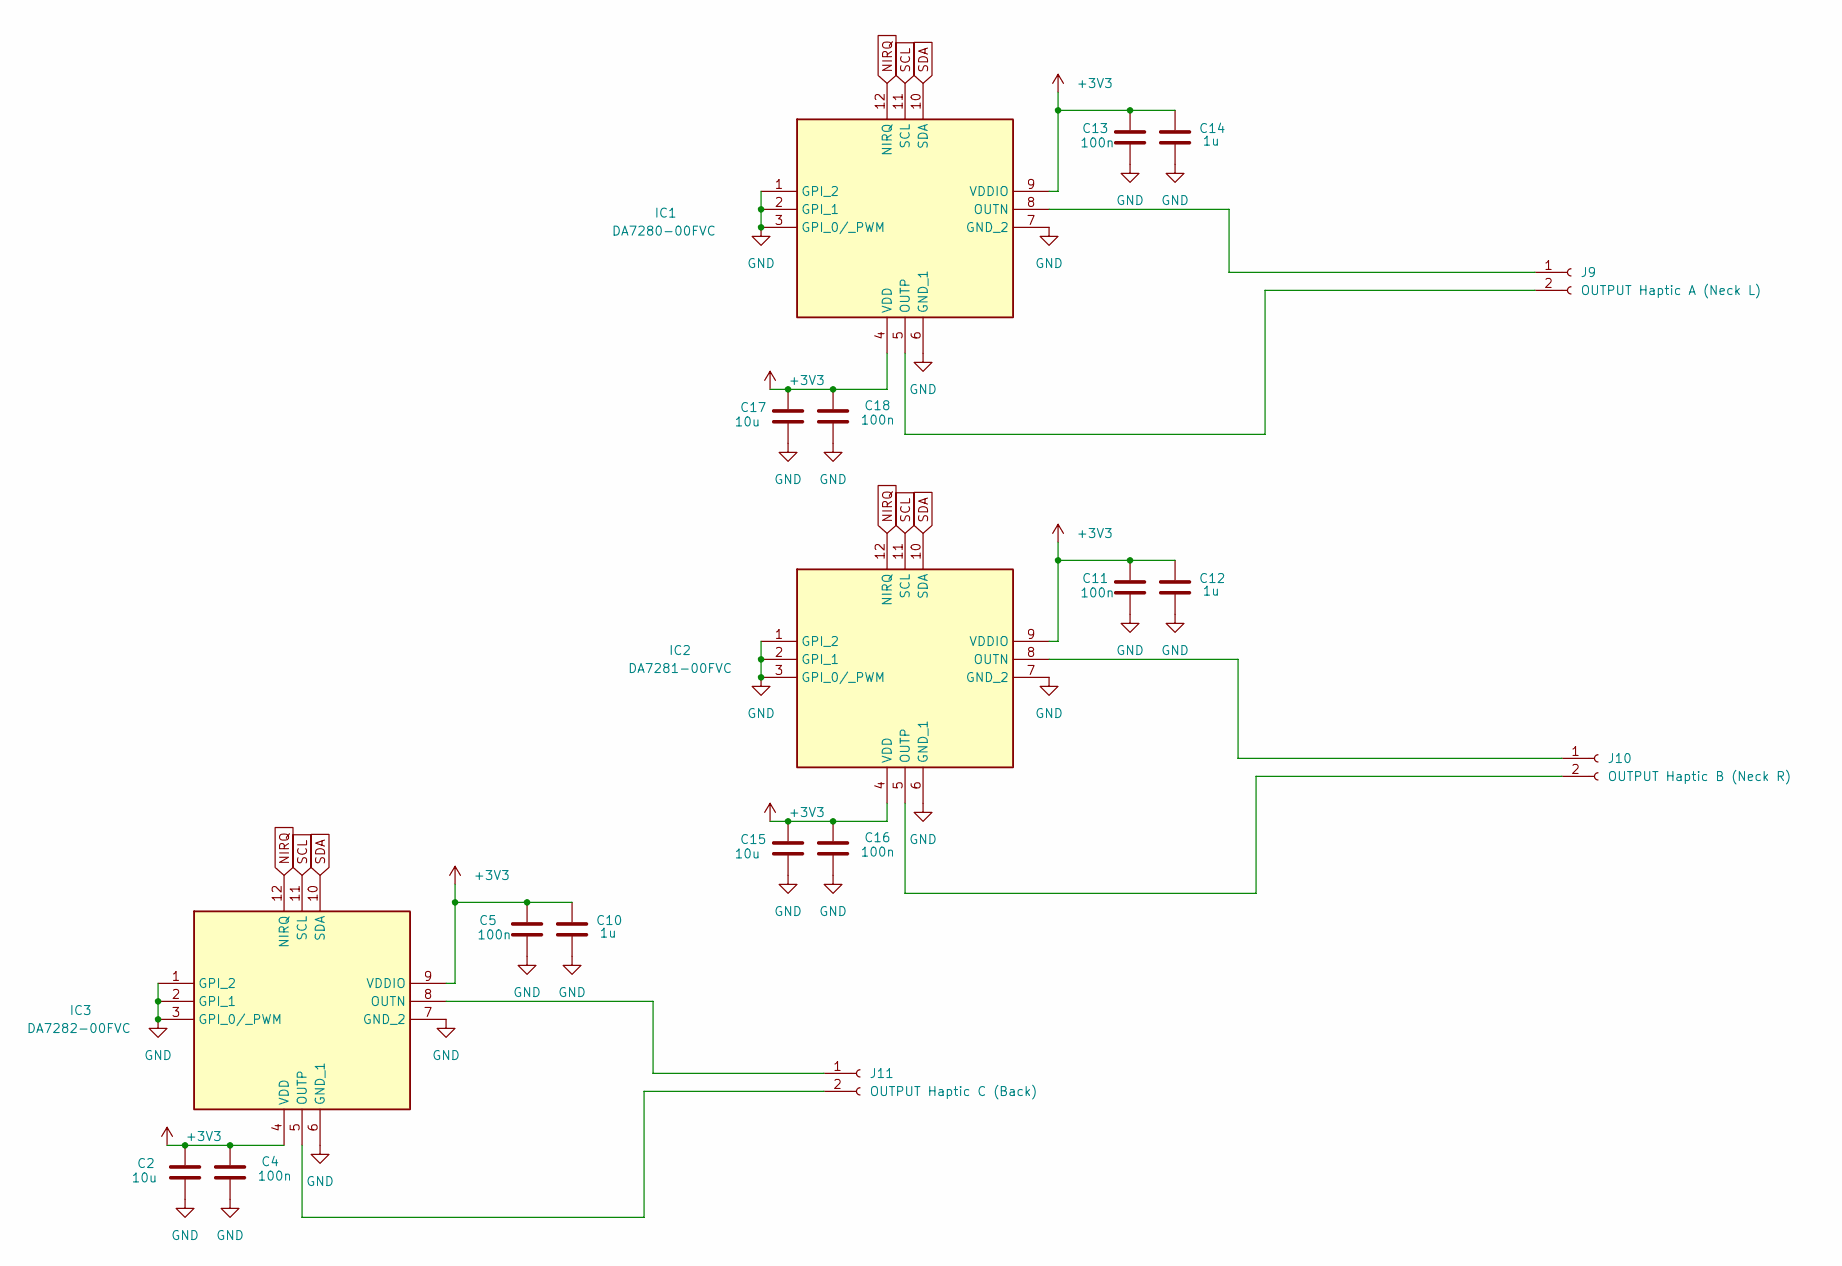
[picture p95: schematic Haptic_Driver_Module.kicad_sch, AI Deputy]

Parts:
C2, C15, C17: 10u; C_0805_2012Metric_Pad1.18x1.45mm_HandSolder
C4, C5, C11, C13, C16, C18: 100n; C_0805_2012Metric_Pad1.18x1.45mm_HandSolder
C10, C12, C14: 1u; C_0805_2012Metric_Pad1.18x1.45mm_HandSolder
IC1: DA7280-00FVC; QFN65P300X300X84-12N; Manufacturer_Part_Number DA7280-00FVC
IC2: DA7281-00FVC; QFN65P300X300X84-12N; Manufacturer_Part_Number DA7280-00FVC
IC3: DA7282-00FVC; QFN65P300X300X84-12N; Manufacturer_Part_Number DA7280-00FVC
J9: OUTPUT Haptic A (Neck L); JST_XH_S2B-XH-A_1x02_P2.50mm_Horizontal
J10: OUTPUT Haptic B (Neck R); JST_XH_S2B-XH-A_1x02_P2.50mm_Horizontal
J11: OUTPUT Haptic C (Back); JST_XH_S2B-XH-A_1x02_P2.50mm_Horizontal

Connections:
+3V3: C2.1, C4.1, C5.1, C10.1, C11.1, C12.1, C13.1, C14.1, C15.1, C16.1, C17.1, C18.1, IC1.4 (VDD), IC1.9 (VDDIO), IC2.4 (VDD), IC2.9 (VDDIO), IC3.4 (VDD), IC3.9 (VDDIO); also elsewhere on the board
GND: C2.2, C4.2, C5.2, C10.2, C11.2, C12.2, C13.2, C14.2, C15.2, C16.2, C17.2, C18.2, IC1.1 (GPI_2), IC1.2 (GPI_1), IC1.3 (GPI_0/_PWM), IC1.6 (GND_1), IC1.7 (GND_2), IC2.1 (GPI_2), IC2.2 (GPI_1), IC2.3 (GPI_0/_PWM), IC2.6 (GND_1), IC2.7 (GND_2), IC3.1 (GPI_2), IC3.2 (GPI_1), IC3.3 (GPI_0/_PWM), IC3.6 (GND_1), IC3.7 (GND_2); also elsewhere on the board
NIRQ: IC1.12 (NIRQ), IC2.12 (NIRQ), IC3.12 (NIRQ); also elsewhere on the board
unnamed: IC1.8 (OUTN), J9.1
unnamed: IC1.5 (OUTP), J9.2
unnamed: IC2.8 (OUTN), J10.1
unnamed: IC2.5 (OUTP), J10.2
unnamed: IC3.8 (OUTN), J11.1
unnamed: IC3.5 (OUTP), J11.2
SCL: IC1.11 (SCL), IC2.11 (SCL), IC3.11 (SCL); also elsewhere on the board
SDA: IC1.10 (SDA), IC2.10 (SDA), IC3.10 (SDA); also elsewhere on the board

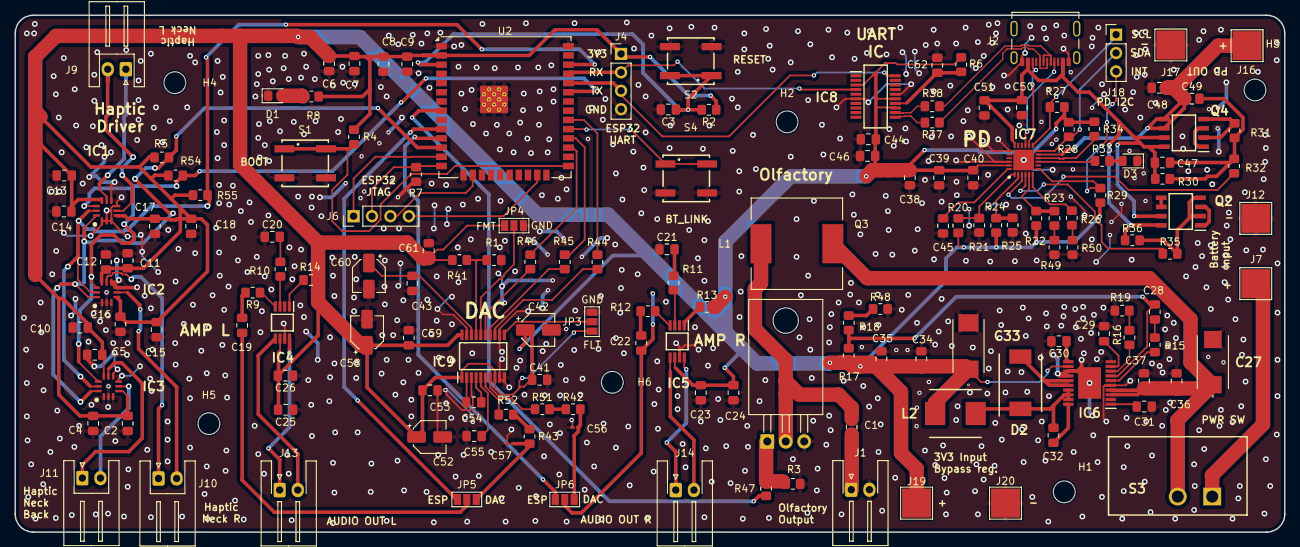
[picture p96: board AI_deputy_PCB.kicad_pcb from above]

Board: 2 copper layers, 175.0 x 71.2 mm, 162 parts (0 on the bottom side), 106 nets.

Other parts of the board:
R1: 2.7k; R_0805_2012Metric_Pad1.20x1.40mm_HandSolder

Their connections:
GND: R1.1; also elsewhere on the board
unnamed 74: R1.2; also elsewhere on the board
