zayinconde/Expert_In_Teams/(commit log)

2025-10-28 commit including files test
    [AI_deputy_PCB.kicad_pcb, AI_deputy_PCB.kicad_sch, DA7280-00FVC.SchLib, DA7280-00FVC.stp, EDI2CAP.CFG, ESP32-WROOM-32UE_M113EH6400UH3Q0_.step, Haptic_Driver_Module.kicad_sch, PD_UART.kicad_sch]
2025-10-28 moving embedded in
    [VLV101040A_config.txt]
2025-10-28 updating repo from desktop
    [AI_deputy_PCB.kicad_sch, Haptic_Driver_Module.kicad_sch, PD_UART.kicad_sch, audio_amp.kicad_sch]
2025-10-28 progress on PCB + matlab calculations
    [AI_deputy_PCB.kicad_pcb, AI_deputy_PCB.kicad_sch, DIOM7958X256N.PcbLib, EDI2CAP.CFG, IS31AP2005-SLS2-TR.SchLib, IS31AP2005-SLS2-TR.stp, LM25576QMH_NOPB.SchLib, LM25576QMH_NOPB.stp]
2025-11-03 update some schematic footprints
    [AI_deputy_PCB.kicad_pcb, AI_deputy_PCB.kicad_sch, Haptic_Driver_Module.kicad_sch, LI_Charge_IC.kicad_sch, PD_UART.kicad_sch, UART.kicad_sch, audio_amp.kicad_sch, pcb.kicad_pcb]
2025-11-06 update pcb from desktop
    [AI_deputy_PCB.kicad_pcb, AI_deputy_PCB.kicad_sch, EDI2CAP.CFG, EEFSX0J151ER.stp, Haptic_Driver_Module.kicad_sch, INDPM7166X300N.PcbLib, PD_UART.kicad_sch, SRP6530A-8R2M.SchLib]
2025-11-10 update schematic from desktop
    [217179-0001.stp, 2171790001.step, AI_deputy_PCB.kicad_pcb, AI_deputy_PCB.kicad_sch, EDI2CAP.CFG, PCM5102APWR.SchLib, PCM5102APWR.stp, PD_UART.kicad_sch]
2025-11-10 fixed small things, push from laptop
    [AI_deputy_PCB.kicad_pcb, UART.kicad_sch]
2025-11-12 pcb v0.1 plus cad render for mech students
    [AI_deputy_PCB.kicad_pcb, AI_deputy_PCB.kicad_sch, Downloads_STP_4307x30xx8xx_rev1.stp, EDI2CAP.CFG, PCM5102APWR.SchLib, PCM5102APWR.stp, SOP65P640X120-20N.PcbLib, SSOP-20-5_3.step]
2025-11-26 pcb updates from desktop with schematic fix
    [${AIDEPUTYKICADBOM}.csv, 744771220.stp, AI_deputy_PCB.csv, AI_deputy_PCB.kicad_sch, AI_deputy_PCB.xlsx, EDI2CAP.CFG, Haptic_Driver_Module.kicad_sch, PD_UART.kicad_sch]
2025-11-26 extra commit to make sure i get everythin
    [AI_deputy_PCB.kicad_sch]
2025-11-29 before saturday work
    [PD_UART.kicad_sch, audio_amp.kicad_sch]
2025-11-30 update after lab session with gustav saturday
    [AI_deputy_PCB.kicad_pcb, AI_deputy_PCB.kicad_sch, Haptic_Driver_Module.kicad_sch, PCB OUTLINE 2D dxf.dxf, PCB Outline dxf.dxf, audio_amp.kicad_sch, pcboutline2d.dxf, stepdown3v3.kicad_sch]
2025-12-01 finished PCB design and gerbers are in directory
    [744771220.stp, AI_deputy_PCB.kicad_pcb, AI_deputy_PCB.kicad_sch, EDI2CAP.CFG, ESP32-WROOM-32UE-N16.SchLib, ESP32-WROOM-32UE-N16.stp, ESP32WROOM32UEN16.PcbLib, L101121MS02Q.stp]
2025-12-02 feedback from lawrence implemented in PCB design
    [AI_deputy_PCB-B_Cu.dxf, AI_deputy_PCB-B_Mask.dxf, AI_deputy_PCB-B_Paste.dxf, AI_deputy_PCB-B_Silkscreen.dxf, AI_deputy_PCB-Edge_Cuts.dxf, AI_deputy_PCB-F_Cu.dxf, AI_deputy_PCB-F_Mask.dxf, AI_deputy_PCB-F_Paste.dxf]
2025-12-07 fixed .dxf 2d pcb for dinnis
    [AI_DEPUTY_PCB_MM_2D.dxf, AI_deputy_PCB-B_Cu.dxf, AI_deputy_PCB-B_Mask.dxf, AI_deputy_PCB-B_Paste.dxf, AI_deputy_PCB-B_Silkscreen.dxf, AI_deputy_PCB-Edge_Cuts.dxf, AI_deputy_PCB-F_Cu.dxf, AI_deputy_PCB-F_Mask.dxf]
2025-12-14 updated pcb code
    [AI_deputy_PCB.kicad_sch, PD_UART.kicad_sch, audio_amp.kicad_sch, stepdown3v3.kicad_sch]
2025-12-23 final push
    [audio_amp.kicad_sch]
2026-01-20 cad files scent
    [scent emitter concept.step]
2026-01-21 desktop push exam
    [scent emitter concept zayin.stl]
